M3-Grant/fpga-synth-engine/00-先看我.md

# 00 · 先看我 —— 项目总入口

> 竞赛：2026 全国大学生嵌入式芯片与系统设计竞赛 · FPGA 创新设计赛道
> 选题：选题二《基于 FPGA 的实时多音色合成电子乐器引擎》
> 平台：高云 **GW2AR-LV18QN88C8/I7**（Sipeed Tang Nano 20K，27 MHz，无 PLL 倍频）
> 版本：**v2.0.1**（2026-11-04）

**一句话现状：12 键可演奏 C4~B4 一个完整八度，4 声部复音，6 档音色。**
**钢琴走 6 谐波加法合成（非谐倍率 + 每谐波独立衰减），吉他走 Karplus-Strong 物理建模 ——
两条完全不同的合成路线。双红外分别当延音踏板和弱音踏板，上位机 120 fps 实时可视化。**

| 关键指标 | 值 |
|---|---|
| 采样率 | 52734.375 Hz（27 MHz ÷ 8 ÷ 64） |
| 内部演奏延迟 | **5.006 ms**（37 ns 量化，n=12 实测） |
| 遥测 | 576 B/帧 @ 921600 8N1，**103 fps** |
| 渲染 | **120 fps**（跟随屏幕刷新率） |
| 资源 | LUT **9281**/20736（45%）、Register 3695/15750（24%）、DSP 3/24、BSRAM 0 |

---

## 一、这个包能做什么

| 能力 | 实现程度 |
|---|---|
| 复音 ≥ 4 | ✅ `VOICE_NUM = 4`，参数化可扩 |
| **钢琴音色** | ✅ 6 谐波加法合成，倍率 `n·√(1+B·n²)`（B=3e-4，非谐），权重 1/h，每谐波独立衰减（τ 2.5 s → 0.08 s） |
| **吉他音色** | ✅ Karplus-Strong 单弦，`y-(y>>5)` 快衰减；踩延音踏板切 `y-(y>>7)` |
| 数字波形 | ✅ 三角 / 方波 / 锯齿 / 脉冲（`oscillator_array` + `adsr`） |
| 延音踏板 | ✅ IR#1（引脚 85）：踩着松手走 `env-(env>>4)-1` 指数渐弱（≈0.93 s），抬脚回收声部 |
| 弱音踏板 | ✅ IR#2（引脚 73）：遮挡 = 整体 -12 dB（混音末级 `>>> 2`） |
| 手感开关 | ✅ `A5 02` 松键渐弱(48 ms) / 立即静音；`A5 03` 延音踏板总开关 |
| 延迟测量 | ✅ 片内 37 ns 量化，min/max/avg/抖动 |
| 实时可视化 | ✅ 波形 / FFT 频谱 / 李萨如 / 12 音统计 / 延迟面板 |
| 纯硬件合成 | ✅ 全部 Verilog，无软核、不预存 PCM |

---

## 二、硬件与接线

### 2.1 触摸输入（TTP229 钢琴模块）

| 信号 | 引脚 | 说明 |
|---|---|---|
| `ttp_scl` | 75 | FPGA → TTP229 SCL |
| `ttp_sdo` | 76 | TTP229 → FPGA（片内上拉） |

> ⚠️ TTP229 的 VCC **必须接 3.3 V**。接 5 V 会让 SDO 输出 5 V，打坏 FPGA 的 3.3 V IO。
> ⚠️ 商家标的"I2C"是误标，实际是 2 线串行（主机给时钟、模块出数据位）。

另一个顶层 `synth_board12_top` 支持旧的 12 × TTP223 并行方案（引脚 27/28/29/30/31/26/41/42/48/77/79/25）。

### 2.2 双红外

| 信号 | 引脚 | 作用 |
|---|---|---|
| `ir_in` | **85** | IR#1 · 延音踏板（遮挡 = 踩下） |
| `ir2_in` | **73** | IR#2 · 弱音踏板（遮挡 = -12 dB） |

模块 VCC 接 3.3 V、GND 共地，OUT 低有效。
红外朝桌面被常遮挡时会一直报"有手"，等于踏板被永久踩住 —— 用 `A5 03 0` 可整体停用延音踏板。

> 引脚 **74** 是旧版红外口，实际接线是 85/73，别再改回去。

### 2.3 音频输出

| 信号 | 引脚 | 说明 |
|---|---|---|
| `i2s_bck` | 56 | → PCM5102A BCK |
| `i2s_lrck` | 55 | → LRCK / WS |
| `i2s_din` | 54 | → DIN |
| `pa_en` | 51 | 板载 MAX98357A 使能（外接功放可不用） |

**推荐链路**：`FPGA I2S → PCM5102A → PAM8403（3 W，独立 5 V）→ 4 Ω 喇叭 + 密封腔体`。
完整接线见 `docs/18-新硬件接线指南.md`。

### 2.4 其他引脚

| 用途 | 引脚 |
|---|---|
| 时钟 | 4（板载 27 MHz） |
| UART TX | 48（另有 69/42/77/79 并联备用） |
| UART RX | 27 |
| 板载 LED | 15~20（低电平点亮） |
| 避开 | 33~40（HDMI/LCD）、87/88（用户键/**复位**） |

---

## 三、代码结构

### 3.1 合成链路

| 模块 | 作用 |
|---|---|
| `synth_ttp229_top.v` | **整机顶层**（TTP229 + 双红外 + 遥测 + 延迟） |
| `ttp229_scan.v` | TTP229 2 线串行读出（500 kHz，20 ms 一轮） |
| `key_scan.v` | 12 路按键消抖（5 ms）+ 边沿检测 → 音符事件 |
| `note_alloc.v` | 音符事件 → 4 声部分配 / 抢占 / `all_off` 回收 |
| `note_table.v` | 音名 → 频率控制字（`tools/gen_fcw.py` 生成，勿手改） |
| `synth_top.v` | **两条音色通路的汇合点** + 弱音移位 |
| `piano_engine.v` | **钢琴**：4 声部 × 6 谐波加法合成，非谐倍率，串行乘加 |
| `ks_array.v` / `karplus_strong.v` | **吉他**：Karplus-Strong 物理建模（支持 sustain） |
| `oscillator_array.v` / `osc_voice.v` | 数字波形通路 |
| `adsr.v` | 四段包络 + **S_PEDAL**（踏板延音的指数渐弱） |
| `mix_tree.v` | N 路求和 + 20 位饱和 |
| `i2s_tx.v` | 标准 Philips I2S 发送机 |
| `latency_meter.v` / `lat_stat.v` | 37 ns 量化的延迟测量与统计 |
| `uart_stream.v` | 576 字节帧的双缓冲发送器 |
| `ui_cmd.v` | 下行命令解析（`A5 01/02/03`） |
| `ir_gesture.v` | 红外消抖 + 挥手判定（诊断用，音色已改由 UI 控制） |

### 3.2 顶层与自检固件

| 模块 | 用途 |
|---|---|
| `synth_ttp229_quiet_top.v` | 静音台架版（触摸/延迟/串口全活，DAC 输出置零） |
| `synth_board12_top.v` | 12 × TTP223 版整机 |
| `tone_test_top.v` | 440 Hz 单音「生死线」工程 |
| `chord_demo_top.v` | 零接线自动和弦演示 |
| `self_test_12notes.v` | 零接线循环钢琴十二音 |
| `self_test_square.v` | 零接线循环方波十二音（硬件对照） |
| `self_test_ks.v` | 零接线 KS 拨弦自检 |
| `ttp229_debug.v` | 触摸 → LED 显示位号（测位映射） |

---

## 四、测试体系（15 套回归）

```powershell
cd code
powershell -ExecutionPolicy Bypass -File .\run_sim_all.ps1
# 期望最后一行：ALL SIMULATIONS PASSED   (15 suites)
```

| # | 套件 | 覆盖 |
|---|---|---|
| 1 | `i2s_tx` | BCK 周期 / 每 LRCK 的 BCK 数 / 采样率 |
| 2 | `note_alloc` | 声部分配、抢占、释放 |
| 3 | `adsr` | 四段包络单调性、峰值、RELEASE |
| 4 | **`adsr_pedal`** | **踏板延音：松手走 S_PEDAL 慢衰减（≈932 ms），不踩踏板仍 48 ms** |
| 5 | `synth_top` | 数字波形通路：静音/单音/复音/释放 |
| 6 | `tone_test` | 440 Hz 实际输出频率 |
| 7 | `synth_board` | 2 键版集成 |
| 8 | `led_ctrl_top` | LED 模式切换 |
| 9 | `key_scan` | 消抖 + 事件 |
| 10 | `ir_gesture` | 挥手窗口判定 |
| 11 | `synth_board12` | 12 键版整机 |
| 12 | `key12_notes` | 12 个键 → 12 个音名 |
| 13 | `piano_engine` | 钢琴引擎：谐波、衰减、damper、和弦 |
| 14 | `ttp229` | TTP229 串行读出（位序、单键、全按、松键） |
| 15 | `synth_ttp229` | 整机链路（串行 → 按键 → 合成 → I2S） |

> ⚠️ **必须用 `.ps1`，不要用 `.bat`。** `.bat` 只看退出码，测试台打印 `[FAIL]` 时退出码仍是 0，会假报 PASS
> （2026-10-15 就因此漏掉过 2 个隐藏 FAIL）。`.ps1` 扫描输出里的 `[FAIL]` 才是真判据。

**单模块快速验证**（比跑全套快一个数量级）：

```powershell
$iv="C:\iverilog\bin"
& "$iv\iverilog.exe" -o "$env:TEMP\t.vvp" "code\rtl\adsr.v" "code\sim\tb_adsr_pedal.v"
& "$iv\vvp.exe" "$env:TEMP\t.vvp"
```

---

## 五、v2.0.1 验证结果

| 项 | 结果 |
|---|---|
| 综合 / 布线 | 0 Error，时序收敛 |
| 资源（`synth_ttp229`） | LUT **9281**/20736（45%）、Register 3695/15750（24%）、DSP 3/24 |
| 串口 | 103.0 fps、0 异常帧 |
| 延迟 | avg **5.006 ms**（min 4.996 / max 5.014 / 抖动 0.018 ms，n=12） |
| 钢琴非谐性（FFT） | 泛音比 1.0025 / 1.0051 / 1.0038 / 1.0051 / 1.0076（n=2..6），等效 B≈7e-4 |
| 踏板延音（数字波形） | 932 ms 归零；不踩踏板仍 48.5 ms |
| 吉他衰减（C4） | 不踩踏板 668 ms 归零；踩踏板 1087 ms 仍有 332 |

---

## 六、踩过的坑（新对话务必知道）

1. **采样率是 52734.375 Hz，不是 48000**。`fs = 27 MHz ÷ 8 ÷ 64`。按 48 k 算，A4 会跑成 483 Hz。
2. **I2S 必须标准 Philips 时序**（LRCK 边沿后延迟 1 个 BCK 发 MSB）。左对齐会让样本左移一位 = 音量翻倍 + 削波。
3. **`tri` 是 Verilog 保留字**（三态线网类型），信号不能叫 `tri`。
4. **iverilog 通过 ≠ 综合通过**。Gowin 的 `EX3791`（位宽截断）/ `EX3784`（索引越界）能抓出仿真不报的 bug。
5. **`.v` 文件不能带 UTF-8 BOM**，否则 iverilog 报 `No top level modules`（Gowin 反而不报，很隐蔽）；
   **`.ps1` / `.bat` 必须纯 ASCII**，PowerShell 5.1 / cmd 按系统 ANSI 代码页读取，中文注释会破坏语法。
6. **KS 的延迟线必须同步读**。写成 `wire x = delay[rd]` 时 Gowin 用不了 BSRAM，整块退化成触发器，DFF 从 3.7k 冲到 18k。
7. **有符号数与无符号数的移位是两回事**。`lp - (lp >> 8)` 对补码负数是"绝对值变大"，波形会一路放大到削波；
   必须 `$signed(lp) - ($signed(lp) >>> 8)`。
8. **多声部叠加要算幅度预算**。单声部激励 1/2（±16383）× 4 声部 = 65532，超 16 位满幅后整段削成方波
   （频谱铺满全频段，听着既不像钢琴也不像吉他）。现在钢琴 1/4、吉他 1/8。
9. **KS 引擎要知道"延音踏板"**。`sustain` 只喂给 note_valid 门控是不够的 —— 衰减档也得切，否则踩了踏板还是 0.67 s 就没声。

---

## 七、文档速查

| 想干什么 | 看哪篇 |
|---|---|
| 仓库总览 / 快速开始 | `README.md` |
| **新硬件怎么接** | `docs/18-新硬件接线指南.md` |
| 上板接线、喇叭怎么焊 | `docs/07-接线指南.md` |
| 触摸 / 红外 / 轻触开关方案 | `docs/08-交互硬件接线.md` |
| 模块接口规格 | `docs/05-模块规格与接口定义.md` |
| 钢琴音色怎么做的 | `docs/16-钢琴音色迭代.md` |
| 红外手势怎么做的 | `docs/17-红外手势最小系统.md` |
| I2S 到底哪里错了 | `code/I2S调试记录.md` |
| Gowin 烧录流程 | `docs/10-Gowin烧录指南.md` |
| 历代评审与发布说明 | `docs/09` / `docs/12` / `docs/13` / `docs/15` |

> ⚠️ `host_viz/` 是 **v1 时代的 Python 上位机**（`synth_viz.py` + LabVIEW 对接文档），
> 已被 `host_ui/`（Electron + 浏览器版）取代，仅作历史参考保留。
> `iterations/` 里是 `demo0.0.2` 的代码快照，同理。

---

## 八、待办（按优先级）

1. **喇叭换 4 Ω 全频 + 密封腔体** —— 对音色的改善大于任何电子改动（板载 SPK+/SPK− 是 BTL，两端都不能接地）
2. **第二路红外的表情通道**：目前 IR#2 用来做弱音；若要做"手距 → 力度/弯音"，需要连续量测距而不是开关量
3. **钢琴音色的力度分层**：现在没有 velocity，所有按键同一个音头
4. **李萨如可视化**：衰减信号的轨迹会卷成螺旋，闭不上；后期考虑用"谱峰重建"生成理想轨迹
5. 和弦削波取舍：单音约 55% 满幅，两音以上会饱和；接 3 W 功放后若嫌糊可加软限幅
