M3-Grant/fpga-synth-engine/docs/12-进度记录-2026-10-14.md

# 进度记录 · 2026-10-14

> 状态：**全链路打通，板子已出声** ✅
> 下次继续：先跑回归仿真 → 烧 2 键版 → 接 12 键触摸

---

## 一、今日里程碑

### 1. 硬件链路全部打通，喇叭出声 ✅

| 环节 | 结果 |
|---|---|
| USB 枚举 | `VID_0403&PID_6010` = **FTDI FT2232H**，`ProblemCode 0` |
| 串口 | **COM9 / COM10**（属 FTDI 双通道，**烧录不用它们**） |
| 驱动 | **完全免驱** —— Windows 11 自带 FTDI 驱动（`Service = FTDIBUS`） |
| JTAG | `GW2AR-18C`，ID `0x0000081B`，Family `GW2AR` |
| 烧录 | SRAM Program 100%，4.6 秒 |
| 上板现象 | **LED 闪 + 喇叭持续出声**（用户确认） |

**⚠️ 之前"资源管理器不认"的真凶就是 USB 数据线：**

```
旧线：USB\VID_0000&PID_0002   ProblemCode 43
      "A request for the USB device descriptor failed"   ← 连描述符都拿不到
新线：USB\VID_0403&PID_6010   ProblemCode 0             ← 正常
```

> **那根能用的线务必留好、贴标签。** 以后调试出问题，第一个怀疑对象永远是线。

板子橙色 WS2812 流水灯 = BL616 固件在跑，**和 FPGA 无关**，它可以作为"供电正常"的指示。

---

### 2. 命令行构建流程打通（不用开 IDE）✅

新增 `code/synth/build.ps1` + `code/synth/README.md`：

```powershell
cd D:\harness\fpga-synth-engine\code\synth
.\build.ps1 -Target tone_test                # 只构建
.\build.ps1 -Target synth_board -Program sram # 构建 + 烧 SRAM
```

| Target | 顶层 | 说明 |
|---|---|---|
| `tone_test` | `tone_test_top` | 440 Hz 自检，**一直响**，只在验证工具链时用 |
| `synth_board` | `synth_board_top` | 2 键版（板载按键 87/88），**零接线** |
| `synth_board12` | `synth_board12_top` | 12 键版（TTP223），正式演奏用 |

### 🔑 关键坑：引脚 54/55/56 是 SSPI 专用引脚

不设这一项，布局布线直接失败：

```
ERROR (PR2017) : 'i2s_din' cannot be placed ...
                 for the location is a dedicated pin (SSPI)
```

**解法**：Tcl 里加 `set_option -use_sspi_as_gpio 1`
（对应 IDE 里 `Place & Route → Dual-Purpose Pin → Use SSPI as regular IO`）

引脚分配本身**没错** —— 与官方 `vendor-docs/audio/src/audio.cst` 逐条一致。

---

### 3. Gowin 综合新暴露并修掉的 4 个真实 bug ✅

Gowin 综合器的告警比 iverilog 严格，一上板就抓出 4 个问题：

| # | 文件 | 问题 | 修复 |
|---|---|---|---|
| 1 | `constraints/synth_board12.cst` | `SINGLE_RESISTOR=ON` 非法（仅 bank 2/3/6/7 支持）→ **阻塞 P&R** | 去掉该属性，保留 `PULL_MODE=DOWN` |
| 2 | `constraints/synth_board.cst` | 同上 | 同上 |
| 3 | `rtl/osc_voice.v:78` | `modulated >>> 8` 触发 `EX3791`（33→16 位截断） | 改 `modulated[23:8]`，**语义完全等价**，附值域校核注释 |
| 4 | `rtl/synth_board_top.v:194` | LED 拼接 7 位截成 6 位，**心跳位被挤掉** | `2'b00` → `1'b0` |

> **#4 是实打实的功能 bug**：会导致 `led[0]` 心跳灯不闪、`led[1:2]` 错位。
> 而 `tone_test_top` 没这问题，所以昨天没暴露。

**教训：iverilog 通过 ≠ 综合通过。上板前必须跑一次 Gowin 综合看告警。**
目前 3 个 target 综合**全部零 ERROR、零 EX3791 告警**（只剩两个无害的时钟类 WARN）。

### 4. 音量调整

| 参数 | 原值 | 现值 | 效果 |
|---|---|---|---|
| `AMP`（`tone_test_top` / `synth_top`） | `16'sh2000`（1/4 满量程） | `16'sh0800`（1/16） | **降 12 dB** |

原因：方波谐波极其丰富，1/4 满量程在 8Ω 小喇叭上实测**非常刺耳**。

---

## 二、当前状态

### 已生成的比特流

| Target | 路径 | 状态 |
|---|---|---|
| `tone_test` | `build/tone_test/impl/pnr/tone_test.fs` | 已上板验证 ✅（但**未含降音量改动**，是旧的 1/4 幅度） |
| `synth_board` | `build/synth_board/impl/pnr/synth_board.fs` | 已修 LED bug + 降音量，**未上板** |
| `synth_board12` | `build/synth_board12/impl/pnr/synth_board12.fs` | 已修，**未上板** |

### 板子现状

- **已拔线，FPGA 里没有程序**（SRAM 掉电即失，正常）
- 喇叭焊接情况待确认

### ⚠️ 未完成的事

1. **回归仿真没跑完** —— `osc_voice.v` 和 `synth_board_top.v` 改动后，只跑了一部分 iverilog 验证就被打断
2. 2 键版 / 12 键版**都还没上板**
3. `synth_board_top` 的 `ACTIVE_LOW=0`（假设板载按键**按下为高**）**未在实物验证**

---

## 三、明天从这里继续

### 第 1 步：跑回归仿真（确认今天的 RTL 改动没破坏功能）

```powershell
cd D:\harness\fpga-synth-engine\code
.\run_sim_all.bat          # 期望输出 ALL SIMULATIONS PASSED
```

### 第 2 步：烧 2 键版（零接线，验证复音 + ADSR + 音量）

```powershell
cd D:\harness\fpga-synth-engine\code\synth
.\build.ps1 -Target synth_board -Program sram
```

**预期现象**

| 现象 | 含义 |
|---|---|
| `led[0]` 约 1.6 Hz 闪 | 逻辑在跑 |
| 按 **KEY1** 出声 / 再按停声 | 音符开关 |
| 按 **KEY2** 切到下一个音（C-D-E-F-G-A-B-C） | 音阶步进 |
| `led[5:3]` 显示当前音阶位置 | 二进制计数 |

**如果按键行为反了**（松开才响、按下停）：把 `synth_board_top.v` 里两处 `debounce` 的
`.ACTIVE_LOW(0)` 改成 `.ACTIVE_LOW(1)` 再重建。

### 第 3 步：接 TTP223 ×12 → 烧 12 键版

接线：`VCC→3.3V`、`GND→GND`、`I/O→对应 key 引脚`，**A/B 焊盘都不焊**（默认高有效，匹配 `ACTIVE_LOW=0`）。

引脚分配见 `code/constraints/synth_board12.cst`，全部来自官方例程 `.cst`，已核实。

```powershell
.\build.ps1 -Target synth_board12 -Program sram
```

### 第 4 步：尚未开始的功能

- **第二交互维度**（红外对管做手势/力度）—— 比赛要求 ≥2 维交互，现在只做了第 1 维（按键）
- **钢琴音色**（加法合成 wavetable）—— 只做过可行性分析，未动手

---

## 四、环境备忘

| 项 | 值 |
|---|---|
| Gowin 云源 | `D:\Gowin\Gowin_V1.9.11.03_Education_x64` |
| 综合器 | `IDE\bin\gw_sh.exe`（Tcl） |
| 烧录器 | `Programmer\bin\programmer_cli.exe` |
| `GOWINHOME` | 命令行工具**必须**设置（`build.ps1` 自动设） |
| iverilog | `C:\iverilog\bin` |
| 器件 | `GW2AR-LV18QN88C8/I7` / 短名 `GW2AR-18C` |
| 时钟 | 27 MHz（引脚 4）→ `fs = 52734.375 Hz` |

### programmer_cli 常用 operation_index

| 值 | 操作 |
|---|---|
| `2` | SRAM Program（掉电即失） |
| `4` | SRAM Program and Verify |
| `9` | exFlash Erase,Program,Verify（掉电保持） |
| `11` | exFlash Verify |

---

## 五、一句话总结

> **昨天：仿真全过、代码就绪。今天：工具链、USB、JTAG、综合、烧录全部打通，板子真的响了。**
> 明天从「跑回归仿真 → 烧 2 键版」开始，然后接 12 个触摸键。
