M3-Grant/fpga-synth-engine/docs/09-第一代demo评审报告.md

# 第一代 demo 测试与评审报告

> 测试时间：2026-10-08
> 被测版本：`demo0.0.1`（提交 `46b5d9e`）
> 测试环境：Icarus Verilog 12.2022（`C:\iverilog\bin`）

---

## 一、仿真测试结果：21 项全通过 ✅

### 1. `i2s_tx` —— 6/6 通过

```
[检查1] BCK 周期            期望 296.3 ns    实测 296.0 ns      PASS
[检查2] 每 LRCK 周期 BCK 数 期望 64          实测 64            PASS
[检查3] 实际采样率          期望 52734.4 Hz  实测 52734.3 Hz    PASS
[检查4] 串行数据流 6 组向量                                    PASS 6/6
        T1 L=1234 R=ABCD  → 流 1234abcd
        T2 L=FFFF R=0000  → 流 ffff0000
        T3 L=8001 R=7FFE  → 流 80017ffe
        T4 L=A55A R=5AA5  → 流 a55a5aa5
        T5 L=0001 R=8000  → 流 00018000
        T6 L=+max R=-max  → 流 7fff8000
```

**评价**：这套测试向量设计得很扎实，特别是 **T5（边界值 0001/8000）和 T6（正负满量程）**——这两个是新手最容易漏的，能覆盖说明测过脑子。

### 2. `tone_test_top` —— 2/2 通过

```
实际采样率      = 52734.375 Hz
音频样本数      = 2216
相位 MSB 翻转数 = 36
测得方波频率    = 439.86 Hz（期望 440.00，误差 0.032%）  PASS
I2S 持续输出    = 2216 个样本                              PASS
```

**评价**：**测实际输出频率**而不是只测"有没有信号"，这是很专业的做法。439.86 Hz 的偏差来自仿真窗口取整，不是设计问题。

### 3. `led_ctrl_top` —— 10/10 通过

模式切换、回绕、5 种模式输出全部正确。

### 4. 独立复算音高表

我用 Python 独立复算了 `note_table.v` 的 FCW 值：

| 音符 | 频率 | 代码值 | 复算值 | 实际音高误差 |
|---|---|---|---|---|
| C4 | 261.63 | 21308174 | 21308535 | −0.002% |
| D4 | 293.66 | 23917617 | 23917228 | +0.002% |
| E4 | 329.63 | 26846617 | 26846816 | −0.001% |
| F4 | 349.23 | 28443000 | 28443144 | −0.001% |
| G4 | 391.99 | 31926188 | 31925745 | +0.001% |
| A4 | 440.00 | 35835935 | 35835935 | **0.000%** |
| B4 | 493.88 | 40224476 | 40224208 | +0.001% |
| C5 | 523.25 | 42616348 | 42616256 | 0.000% |

**结论：音高全部正确**，最大误差 0.002%，远低于人耳可辨阈值（约 0.3%）。
（代码值与理论值有几十个 LSB 的差异，但不影响音准，属于可接受的取整方式。）

---

## 二、做得好的地方（值得保持）

| # | 亮点 | 为什么重要 |
|---|---|---|
| 1 | **`i2s_tx` 重写为标准 Philips I2S** | v1 左对齐会让 PCM5102A 左右声道错位、声音发闷。这个修正很关键 |
| 2 | **每声道 32 BCK（非 16）** | v1 只有 16 BCK/声道，采样率被顶到 105kHz。修正后是合理的 52.7kHz |
| 3 | **样本锁存（`l_reg`/`r_reg`）** | 帧起点打一拍，保证发送途中数据不被上游改写。**这是很多人会漏的坑** |
| 4 | **`sample_req` 提前 16 BCK 请求** | 给上游留出计算时间，避免欠载。设计意识很好 |
| 5 | **上电复位（POR）** | `tone_test_top` 用计数器自复位，不依赖按键，减少一类入门坑 |
| 6 | **测试向量覆盖边界值和满量程** | T5/T6 体现了测试思维 |
| 7 | **显式声明 `sample_req` 再使用** | 规避了 iverilog v14 的 "declaration after use" 检查 |
| 8 | **文档记录了踩坑** | `I2S调试记录.md` 对答辩极有价值 |

---

## 三、发现的问题

### 🔴 问题 1：两处"插 J4"的残留说法（**上板前必须修正**）

**先说明：你们的结论是对的。** `00-先看我.md` 和 `07-接线指南.md` 第 18~22 行都正确指出：
> 原理图里标 J4（Conn_01x02），但**实物上没有焊座子**，只有两个标着 **SPK** 的裸露焊盘，必须自己焊线。BTL 输出，不能接地。

**但有两处早期写法没同步更新，仍然说"插 J4"：**

| 位置 | 原文 | 问题 |
|---|---|---|
| `code/rtl/tone_test_top.v` 第 12、14 行 | "输出经 J4（2pin 座子）接 4~8Ω 喇叭"<br>"生死线可以**完全不接线**，只要把 pa_en 拉高、喇叭插 J4 就能响" | 说"不接线""插座子"，与实物矛盾 |
| `docs/07-接线指南.md` 第 30 行 | "生死线那天可以**一根线都不接**……喇叭插到板上 J4 座子" | 与同文件第 20~21 行的更正自相矛盾 |
| `docs/07-接线指南.md` 第 38~39 行 | 方案 A："接线量 **0 根**"、"喇叭插 J4" | 表格里还在说插 J4 |

**风险**：
- 队员只看这几行，会以为"不用焊接、插上就行" → 找不到座子、以为板子有问题，**白折腾几小时**
- 更糟的情况：误以为某些排针是喇叭口，接错位置 → **可能烧功放芯片**

**注意**：`07-接线指南.md` 后面的第 55、70~87、202~203 行其实写得很完整（焊盘位置、焊接步骤、万用表检查），
所以**信息是全的，只是前面留了过时说法**，容易让读者在第一眼就被误导。

**建议修正**（3 处，10 分钟能改完）：

1. `tone_test_top.v` 第 10~16 行注释改为：
   ```
   //    原理图上标 J4，但实物未焊座子，输出在板上的 SPK+ / SPK- 两个裸焊盘。
   //    → 用板载功放出声需要自己焊两根线到 SPK 焊盘（BTL 输出，两端都不可接 GND）。
   //    → 若不焊接，则走外接 PCM5102A 方案（3.5mm 耳机口，零焊接）。
   ```
2. `07-接线指南.md` 第 30 行：删掉"插到板上 J4 座子"，改成"**喇叭两根线焊到 SPK 焊盘**"
3. `07-接线指南.md` 第 38~39 行表格：方案 A 的"接线量"由"0 根"改为"**2 根（需焊接）**"，"出声方式"改为"**4~8Ω 喇叭焊到 SPK 焊盘**"

**另外强烈建议**：在 `07-接线指南.md` 里补一张**实物照片**，圈出 SPK 焊盘位置。文字描述"排针 54 和 56 正下方往板内一格"不如一张照片直观。

---

### 🟠 问题 2：采样率 52734.375 Hz 不是标准音频速率

| 标准速率 | 本项目 | 偏差 |
|---|---|---|
| 44100 | 52734.375 | +19.58% |
| 48000 | 52734.375 | +9.86% |

**影响评估**：
- ✅ **音准没问题**——FCW 按真实 fs 算，A4 实测 440.00 Hz
- ✅ **MAX98357A 支持 8k~96kHz**，能接受这个速率
- ⚠️ **但与标准 48kHz 不兼容**：如果以后要把音频录到电脑分析、或与外设对接，会有问题
- ⚠️ **与 PCM5102A 的隐患**：PCM5102A 通过采样 MCLK 或 BCLK 自动检测速率。52734 Hz 落在它支持的范围内，应该能用，但**换 DAC 后必须重新验证**

**建议**：
- 如果只是"出声"和演示，**保持现状完全没问题**
- 若想更规范，可改 `BCK_HALF`：`5` → 42187.5 Hz，`3` → 70312.5 Hz（但仍非标准）
- **真正的标准 48kHz 需要 24.576MHz 时钟**（27MHz 除不出整数），这就是为什么会有这个偏差——不是设计失误，是时钟源的物理限制

---

### 🟡 问题 3：MAX98357A 是单声道，注意演示策略

代码注释里已经提到了，这里再强调：

- MAX98357A 是**单声道** D 类功放
- `SD_MODE > 1.4V` 时只输出**左声道**
- 当前 `tone_test_top` 左右声道同数据，所以听不出问题
- **但等你们做复音、立体声效果时，右声道会丢失**

**建议**：
- 频谱验证和最终演示**按计划外接 PCM5102A**（立体声）——你们文档里已经想到了，很好
- 板载 MAX98357A 只当"快速验证出声"用

---

### 🟡 问题 4：缺少幅值调节机制

当前 `AMP = 16'sh2000`（1/4 满量程）是固定参数，需要改代码重新综合才能调音量。

**建议**：后续加一个按键或电位器控制幅值，现场演示时可调，避免音量过大刺耳。

---

## 四、改进建议（按优先级）

### P0（上板前必须做）

| # | 事项 |
|---|---|
| 1 | **确认并统一喇叭接法**（J4 vs SPK 焊盘），修正文档矛盾 |
| 2 | **补一张实物接线照片**放进 `docs/07-接线指南.md` |
| 3 | 焊接前用万用表确认 SPK+ / SPK− 无短路、未接地 |

### P1（上板后尽快做）

| # | 事项 | 说明 |
|---|---|---|
| 4 | 记录**真实上板实测数据** | 波形/频率截图，答辩要用 |
| 5 | 用示波器或逻辑分析仪确认 BCK/LRCK/DIN 实际波形 | 对照仿真验证硬件一致 |
| 6 | 外接 PCM5102A 做立体声验证 | 为后续复音做准备 |

### P2（进入第二代开发时）

| # | 事项 | 说明 |
|---|---|---|
| 7 | 提高时间分辨率 | 当前仿真窗口下 440Hz 测得 439.86Hz，可用更长窗口验证 |
| 8 | 加入 ADSR 包络 | 让声音不再"硬切" |
| 9 | 相位累加器位宽保持 32 位 | 当前设计正确，扩复音时别降位宽 |
| 10 | 开始参数化复音数 | `parameter VOICE_NUM` + `generate`，为 4→32 复音做准备 |

---

## 五、总体评价

**这是一份质量很高的第一代 demo。** 具体来说：

| 维度 | 评分 | 说明 |
|---|---|---|
| 功能正确性 | ★★★★★ | 21 项测试全通过，含边界值 |
| 测试设计 | ★★★★★ | 测实际频率而非"有无信号"，覆盖边界 |
| 代码规范 | ★★★★☆ | 注释详尽、模块解耦、命名清晰 |
| 文档完整度 | ★★★★☆ | 8 篇文档 + 调试记录，但存在 1 处矛盾 |
| 工程意识 | ★★★★★ | 样本锁存、提前请求、上电复位都考虑到了 |
| **上板风险** | ⚠️ | **喇叭接法未确认，有烧板风险** |

**最强的一点**：你们踩过的坑都留下了记录（`I2S调试记录.md`），这在答辩时是**实打实的加分项**——证明你们理解原理，而不是抄代码。

**最需要立刻做的**：把喇叭接法搞清楚。这是唯一有"物理损坏风险"的问题，其余都是优化项。

---

## 六、上板检查清单

上板前逐项确认：

```
□ 喇叭接法已确认（J4 还是 SPK 焊盘）
□ 焊接处万用表测过，无短路、未接地
□ 板卡供电正常（Type-C 数据线，非充电线）
□ Gowin 工程器件选对：GW2AR-LV18QN88C8/I7
□ 约束文件 tone_test.cst 已导入
□ 改过代码后重新综合+布线+生成码流（不能下旧码流）
□ 上电后先看 led[0] 是否闪烁（证明逻辑在跑）
□ 听到 440Hz 单音 → 生死线通过
```

**注意**：`led[0]` 闪烁是"逻辑在跑"的证据。如果灯不闪，说明板子没配置成功，别急着怀疑音频。
