M3-Grant/fpga-synth-engine/docs/06-追赶排期（10-08起）.md

# 06 · 追赶排期（2026-10-08 起）

> **为什么要有这份文件**：原排期从 09-22 开始，但环境这一步实际上到 10-08 才就位，
> 已经落后约 2.5 周。原计划作废，下面是按"距省赛提交还剩 27 天"重新倒推的版本。
> 赛题：高云 · 选题二《基于 FPGA 的实时多音色合成电子乐器引擎》
> **省赛提交：2026-11-04 18:00（剩 27 天）｜ 决赛：2026-11-20 ~ 11-22**

---

## 一、先解决三个"不知道就白干"的问题（今天，1 小时内）

| # | 必须确认 | 为什么 | 怎么确认 |
|---|---|---|---|
| 1 | ~~板卡型号到底是哪个~~ | ✅ **已确认为 Tang Nano 20K**，文档与引脚约束全部适用 | — |
| 2 | **DAC 模块型号与接线方式** | 是否要 MCLK、逻辑电平是 3.3V 还是 5V，直接决定能不能出声 | 看模块丝印（应为 PCM5102A），问客服"是否 3 线 I2S、不需 MCLK" |
| 3 | **省赛提交截止日期** | 文档里的 11-04 来自报名时的信息，必须在官网再核一次 | 大赛官网 http://www.fpgachina.cn/ |

> ⚠️ 如果是 **Tang Mega 60K**：主时钟、引脚、器件系列全部不一样，
> 必须先把 `code/constraints/*.cst` 和 Gowin 工程里的器件换成 GW5AT-LV60，
> 其余架构（I2S / DDS / 复音）不变。**这一步不确认，后面每一天都可能白做。**

---

## 二、已完成 / 待完成（截至 10-08）

| 项 | 状态 |
|---|---|
| 硬件采购 | ✅ 已下单 |
| Gowin 软件 | ✅ 已下载，❌ **未安装** |
| Icarus Verilog 仿真器 | ✅ **已装好**（`D:\Tools\iverilog\bin`，含 GTKWave） |
| I2S 模块 | ✅ **已重写并通过仿真**（标准 Philips I2S，9/9 项通过） |
| 440Hz 验证工程 | ✅ **已写好并通过仿真**（实测 439.86 Hz） |
| 音符 FCW 表 | ✅ 已生成（C4~C6，25 个半音） |
| 点灯 | ❌ 未做 |
| 上板出声 | ❌ 未做 ← **生死线** |

---

## 三、五周追赶计划

### W1｜10-08(四) ~ 10-11(日) — 环境 + 点灯 + **出声（生死线）**

| 日期 | 任务 | 验收标准 |
|---|---|---|
| **10-08 今天** | ① 安装 Gowin 云源软件教育版 V1.9.11.03（422MB，**勾选 GW2A/GW2AR 器件库**）② 安装云源编程器教育版（85MB）③ 确认上面三个问题 | 软件能打开，器件列表里有对应芯片 |
| **10-09 五** | 跑官方例程 `vendor-docs/led/blink_led`：新建工程 → 加 `.v` → 加 `.cst` → Synthesize → Place & Route → Program Device | **板上 LED 闪烁** |
| **10-10 六** | ① 不照抄，独立重做一遍 `flow_led` ② **外接 PCM5102A 出声**（5 根线：54/55/56 + 3V3 + GND，杜邦线即可，零焊接） | 走完流程不卡壳；**耳机响** |
| **10-11 日** | 录一段出声视频存档；把 I2S 排查经验补进文档 | 🔴 **耳机里听到持续的 440Hz 单音** |

> 💡 **板载已有一片 MAX98357A（I2S DAC + D 类功放）**，接在引脚 54/55/56，使能脚 51，
> 输出在标着 **SPK** 的两个焊盘上（**没焊座子，要自己焊线**）。
> 它是单声道、D 类 PWM 底噪大，**不能用于频谱验证**。
> 所以**推荐直接走外接 PCM5102A**（杜邦线插上就行，不用动烙铁）。排针丝印顺序见 `07-接线指南.md`。

> **工程路径绝对不能有中文、空格**（例如 `D:\fpga\code`）。这是 Gowin 最常见的创建失败原因。
>
> **不出声的排查顺序**（按顺序来，别跳）：
> 1. 板卡供电灯亮不亮 → 换 Type-C 数据线（**必须是数据线，不能是纯充电线**）
> 2. 设备管理器认不认得到串口 → 装 BL616 驱动
> 3. Programmer 里 Port 换 0 → 1 试一下
> 4. 用手机耳机插入 DAC，音量先调到最小再慢慢加大
> 5. 万用表量 BCK 对地应有约 1.7V 平均电压（说明有时钟输出）
> 6. 逻辑分析仪/示波器看 BCK=3.375MHz、LRCK=52.7kHz 是否对得上
> 7. **若 10-14 仍无声音 → 立刻降级**：改用 PWM 直推蜂鸣器验证逻辑链，
>    同时在高云群里问 I2S，不要一个人死磕

---

### W2｜10-12(一) ~ 10-18(日) — DDS 正弦波 + 音符

| 日期 | 任务 | 验收标准 |
|---|---|---|
| 10-12 | 用 Python 生成正弦波形表（1024 点 × 16bit），存成 `.mi` 或 `.hex` | 文件生成、数值可读 |
| 10-13 | 在 Gowin 里用 IP Core 例化 ROM，或 `$readmemh` 加载 | 综合通过，BSRAM 占用 1~2 块 |
| 10-14 | 相位累加器高 10 位 → ROM 地址 → 样本 → I2S | 仿真输出正弦序列 |
| 10-15 | 上板：改 `tone_test_top` 用正弦替代方波 | 手机频谱 App 看到 **440Hz 单峰** |
| 10-16 | 接入 `note_table.v`（已生成），用板载按键切换音符 | 按键能改变音高 |
| 10-17 | 试 220 / 440 / 880Hz，核对频谱 | 频率误差 < 1% |
| 10-18 | 复盘封板：把 I2S + DDS 封装成干净的可复用模块 | 接口清晰，带注释 |

**本周末产出**：能弹不同音高的正弦波电子琴（单音）。

---

### W3｜10-19(一) ~ 10-25(日) — 2 维交互 + ADSR

| 日期 | 任务 | 验收标准 |
|---|---|---|
| 10-19 | **交互维度 1**：自制电容触摸（IO 充电 → 转输入 → 计数器测放电时间） | 手指触摸能稳定触发，不误触 |
| 10-20 | 触摸做成 4~8 个键位 | 不同键位出不同音 |
| 10-21 | **交互维度 2**：光电对管 / 红外接近 / 第二组触摸 | 第二个维度独立可控 |
| 10-22 | 两维度组合（一个选音、一个控音量或音色） | 互不干扰 |
| 10-23 | ADSR 状态机（IDLE → A → D → S → R） | 状态转换图清晰 |
| 10-24 | 实现四段包络，用**移位加法**近似，不占 DSP | 听得到渐强/衰减/释放，不再硬切 |
| 10-25 | 录一段旋律视频存档 | 视频可播放 |

**本周末产出**：带包络、双维度控制的简易电子琴。

---

### W4｜10-26(一) ~ 11-01(日) — 复音 4 + 架构定型

| 日期 | 任务 | 验收标准 |
|---|---|---|
| 10-26 | 🔴 振荡器改成 `parameter VOICE_NUM` + `generate`；波形 ROM 改**全阵列共享** | 改一个数字就能改复音数 |
| 10-27 | 音符分配器：note-on 找空闲声部，note-off 释放 | 仿真验证 |
| 10-28 | 混音加法树（流水线 + 饱和处理） | 多音同响不失真 |
| 10-29 | 复音 4 上板调试 | 🔴 **同时按 4 键，频谱出现 4 个独立谱峰** |
| 10-30 | **测试模式**：一键输出 N 路不同频率（合规自证用） | 频谱峰数 = 复音数 |
| 10-31 | 加第 2 种音色；有余力扩到复音 8 | 能切换音色 |
| 11-01 | 看综合报告，确认无时序违例；记录资源占用 | 无 setup/hold 违例 |

> ⚠️ **11-01 是决策点**：复音 4 还不稳，就把省赛交付冻结在 W3 水平（单音+包络），
> 复音留到国赛。**宁可功能少，也要稳**。

---

### W5｜11-02(一) ~ 11-04(三) — 文档 + 视频 + 提交

| 日期 | 任务 | 验收标准 |
|---|---|---|
| 11-02 | 综合实现报告（LUT/FF/BSRAM/DSP、时钟、时序）+ 设计报告 | 文档完整 |
| 11-02 | 演示视频（≤3 分钟，**必须含测试模式的频谱演示**） | 视频可播放 |
| 11-03 | 材料打包：源码 + 约束 + 脚本 + 报告 + 视频，**文件名全英文小写** | 无中文文件名 |
| 11-03 | 连续运行 10 分钟不出错、不失真 | 无死机 |
| **11-04** | 🔴 **提交（18:00 前）** | 上传成功，留截图 |

---

## 四、已经替你解决的技术坑（别再踩）

| 坑 | 原状态 | 现在 |
|---|---|---|
| **I2S 时序是左对齐不是 I2S** | LRCK 一跳变就出 MSB，缺 I2S 规定的 1 位延迟 → PCM5102A 会声道错位 | ✅ 已改为标准 Philips I2S（1 延迟位 + 16 数据 + 15 补零） |
| **采样率 105 kHz** | 每声道只有 16 BCK，速率非标准，DAC 可能锁不上 | ✅ 改为 64 BCK/LRCK，**fs = 52734.375 Hz** |
| **"DIN 左移 1 位"的假 bug** | 其实是 testbench 没丢掉无效位 + 在时钟沿改样本造成竞争 | ✅ testbench 重写，**9/9 项全部通过** |
| **FCW 按 48000 算** | fs 实际是 52734，按 48000 算 A4 会变成 483Hz，跑调两个半音 | ✅ 已生成 `note_table.v`（按真实 fs）和 `tools/gen_fcw.py` |
| **iverilog 没装** | 文档写着"已安装"，实际没有 | ✅ 已装到 `D:\Tools\iverilog\bin` |

---

## 五、本周（W1）每天结束时自查

- [ ] 今天有没有让板子**真的动起来**（灯闪 / 出声）？
- [ ] 遇到看不懂的英文界面，有没有截图翻译？（见 `../06-Gowin界面中英对照速查表.md`）
- [ ] 有没有在高云官方群（213923272）里问问题？
- [ ] 代码有没有改动没记录？

---

## 六、常用命令（复制即用）

**仿真 I2S**：
```powershell
cd D:\Competition\FPGA\FPGA\FPGA\code
D:\Tools\iverilog\bin\iverilog.exe -g2005 -o sim_i2s.out rtl\i2s_tx.v sim\tb_i2s_tx.v
D:\Tools\iverilog\bin\vvp.exe sim_i2s.out
```

**仿真 440Hz 音高**：
```powershell
D:\Tools\iverilog\bin\iverilog.exe -g2005 -o sim_tone.out rtl\i2s_tx.v rtl\tone_test_top.v sim\tb_tone_test.v
D:\Tools\iverilog\bin\vvp.exe sim_tone.out
```

**重新生成音符表**（改了时钟或 BCK_HALF 就必须重跑）：
```powershell
python code\tools\gen_fcw.py 27e6 4 --out code\rtl\note_table.v
```

**看波形**：
```powershell
C:\iverilog\gtkwave\bin\gtkwave.exe tb_i2s_tx.vcd
```
