M3-Grant/fpga-synth-engine/docs/07-接线指南.md

# 07 · 接线指南（Tang Nano 20K）

> 板卡已确认：**Sipeed Tang Nano 20K（GW2AR-LV18QN88C8/I7）**
> 引脚来源：官方 audio 例程 `vendor-docs/audio/src/audio.cst` ＋ Tang Nano 20K 原理图 AUDIO 页交叉核对。

---

## 一、结论先行：板子上已经有一片 I2S DAC 了

原理图里有一片 **MAX98357A**（I2S 输入 → D 类功放），已经接在 FPGA 上：

| 信号 | FPGA 引脚 | 原理图网络名 |
|---|---|---|
| I2S_DIN | **54** | PIN54_I2S_DIN |
| I2S_LRCK | **55** | PIN55_I2S_LRCK |
| I2S_BCLK | **56** | PIN56_I2S_BCLK |
| PA_SD/EN（功放使能） | **51** | PIN51_PA_SD/EN |
| 喇叭输出 | **SPK 焊盘 ×2** | AUDIO_OUTP / AUDIO_OUTN |

> ⚠️ **更正**：原理图里这个输出叫 J4（Conn_01x02），但**实物上没有焊座子**，
> 只有两个标着 **"SPK"** 的裸露焊盘。要接喇叭得**自己焊两根线上去**。
> 位置见图：就在排针 **54 和 56 的正下方（往板内一格）**。

MAX98357A 的关键特性（数据手册确认）：
- **不需要 MCLK**，三线 I2S 就能响
- 支持 **8 kHz ~ 96 kHz**，我们的 52.734 kHz 在范围内
- 型号后缀是 **A**（不是 B）→ 支持的是 **标准 I2S**，跟我们重写的 `i2s_tx.v` 完全匹配
- 支持 16/24/32 位数据 → 我们的"16 位数据 + 32 位帧"没问题

所以 **生死线那天可以一根线都不接**：把 `pa_en`（引脚 51）拉高，喇叭插到板上 J4 座子，就能出声。

---

## 二、两条路线，按顺序走

| | 方案 A：板载功放 | 方案 B：外接 PCM5102A |
|---|---|---|
| 接线量 | **0 根** | 5 根 |
| 出声方式 | 4~8Ω 喇叭插 J4 | 耳机 / 音箱插 3.5mm |
| 声道 | **单声道**（SD_MODE 高电平时只出左声道） | 立体声 |
| 音质 | D 类 PWM，底噪大 | 干净 |
| 频谱验证 | ❌ 底噪会盖住谱峰 | ✅ 适合 |
| 用途 | **先做这个，10 分钟内判断"逻辑通不通"** | **最终演示和答辩用这个** |

> ⚠️ 方案 A 只是用来快速验证的。题目要求"频谱可观测对应数量独立谱峰"，
> D 类功放的 330 kHz PWM 底噪会污染频谱，**正式演示必须走方案 B**。

---

## 三、方案 A：板载功放出声（今天就能做）

### 步骤
1. `tone_test_top.v` 里已经把 `pa_en` 拉高了（第 6 节），不用改代码
2. 综合 → 布局布线 → 下载
3. **找一个喇叭**，两根线焊到板上的 **SPK 焊盘**（见下方定位）
4. 上电 → 应该听到持续的 440 Hz 单音

**喇叭规格（买错会烧功放，务必照着买）**：

| 参数 | 要求 |
|---|---|
| 阻抗 | **8Ω（推荐）或 4Ω，绝不能低于 4Ω** |
| 功率 | ≥1W，推荐 2W |
| 类型 | **动圈式小扬声器**，带两根引线 |
| 禁忌 | ❌ 有源音箱 ❌ 压电蜂鸣片 ❌ 无源蜂鸣器 |

淘宝搜 `8欧2瓦 小喇叭 40mm 引线`，3~8 元，**买两个**（一个备用）。
详细选型理由见 `04-硬件采购清单.md` 第 2.3 节。

### SPK 焊盘在哪
在你拍的那张照片上（能看到 SD 卡座、丝印 `V3921` 的那面）：

- 找到上排排针里的 **54** 和 **56** 两个脚
- **它们正下方（往板内一格）有两个椭圆形的裸露焊盘**
- 焊盘左下方印着 **`SPK`** 三个字母 ← 就是这里

⚠️ 这里**没有焊座子**，只有两个焊盘，得用电烙铁焊两根线上去
（实验室借个烙铁，2 分钟的事）。焊完用万用表量一下两个焊盘之间**不是短路**再上电。

### ⚠️ 喇叭接法（唯一会烧芯片的操作）
MAX98357A 输出是 **BTL 桥接**：
- 喇叭**跨接在两个 SPK 焊盘之间**（一端接一个焊盘）
- **绝对不能**把喇叭一端接焊盘、另一端接 GND
- 阻抗必须 ≥ 4Ω（8Ω 更稳妥）

### 不响的话
- 先量两个 SPK 焊盘对 GND 的直流电压，正常应在 **2.5V 左右**（BTL 静态中点）
- 确认 `pa_en` 真的拉高了（引脚 51 量到约 3.3V）
- 注意：SD_MODE > 1.4V 时只输出**左声道**。我们左右声道送的是同一份数据，所以没影响；
  但后面做立体声时记得这一点

> 💡 **如果不想焊**：直接用方案 B 的外接 PCM5102A 就行了——杜邦线一插就响，
> 零焊接。板载 SPK 只是备选。

---

## 四、方案 B：外接 PCM5102A（最终交付用）

### 4.1 排针丝印的确切顺序（已按实物照片放大确认）

Tang Nano 20K 有两排 20pin，**板子丝印直接印了 FPGA 引脚号**。
你拍照的那一面（能看到 SD 卡座、丝印 `V3921` 的那面），**上面那一排**从左到右是：

```
位置  1   2   3   4    5     6    7   8   9   10  11  12  13  14  15  16  17  18   19   20
丝印  52  53  71  72  3V3   GND   79  86  49  55  48  51  54  56  41  42  80  76  GND   5V
```

对应关系（★ = 我们要用的）：

| 丝印 | 位置 | 用途 |
|---|---|---|
| **3V3** | 第 5 个 | ★ DAC 供电 |
| **GND** | 第 6 个（紧挨 3V3） | ★ 共地 |
| **55** | 第 10 个 | ★ LRCK |
| 48 | 第 11 个 | 空 |
| **51** | 第 12 个 | ★ 板载功放使能 pa_en |
| **54** | 第 13 个 | ★ DIN |
| **56** | 第 14 个 | ★ BCK |
| GND | 第 19 个 | 备用接地 |
| 5V | 第 20 个 | ⚠️ 别接 DAC |

**好消息**：51、54、56 三个脚**紧挨在一起**（第 12、13、14 个），
3V3 和 GND 也在同一排上（第 5、6 个），**五根线全在这一排搞定**，不用跨到对面排针。

**下排**（同一面的下面那一排，丝印是倒着印的）从左到右是：

```
3V3  GND  18  19  20  17  31  30  29  25  26  28  27  16  15  77  85  75  74  73
```

### 4.2 万用表复核（30 秒，建议做）

虽然丝印已经确认，接电源线之前还是量一下最稳：

1. 板子 USB-C 上电（先别接 DAC）
2. 黑表笔接 USB 口金属外壳（已知的地）
3. 红表笔点那个标着 `3V3` 的第 5 个脚 → 应读到 **3.3V 左右**
4. 红表笔点标着 `GND` 的第 6 个脚 → 应读到 **0V**
5. ⚠️ 第 20 个脚标着 `5V`，**千万别接 DAC**（大部分 PCM5102A 模块是 3.3V 逻辑）

### 4.3 关于排针有没有焊

官方渲染图上是**光板**（只有镀金孔，没焊排针）。实物一般已焊好，
**上板前先确认**：如果只有光孔没排针，得先自己焊上排针，
或者直接把杜邦线焊到孔上——否则杜邦线插不住。

### 4.4 接线表

| PCM5102A 模块 | Tang Nano 20K | 说明 |
|---|---|---|
| **BCK**（或 BCLK） | 排针丝印 **56** | 位时钟 |
| **LRCK**（或 LCK / WS） | 排针丝印 **55** | 左右声道时钟 |
| **DIN**（或 DATA / SD） | 排针丝印 **54** | 串行数据 |
| **VIN / VCC** | 排针丝印 **3V3** | 确认模块是 3.3V 逻辑；若模块标 5V 就接 5V |
| **GND** | 排针丝印 **GND** | ⚠️ **必须共地**，不共地一定不出声 |
| SCK / MCLK | 见下方说明 | 3 线版本没有这个脚 |

一共就 **5 根线**。

### 4.5 关于 MCLK（SCK）—— 如果你的模块有这个脚

如果你的 PCM5102A 模块引出了 **SCK/MCLK** 并且需要外部提供主时钟，
**不用慌，27 MHz 刚好能精确分出标准 MCLK**：

```
fs      = 27 MHz / 512      = 52734.375 Hz
MCLK    = 256 × fs          = 13,500,000 Hz  = 27 MHz ÷ 2   ← 精确整除，零抖动
BCK     = 64 × fs           = 3.375 MHz
```

在顶层加三行就能产生：

```verilog
// 可选：给需要 MCLK 的 DAC 用（13.5 MHz = 256 × fs，精确）
output wire mclk,
reg mclk_r = 1'b0;
always @(posedge clk) mclk_r <= ~mclk_r;
assign mclk = mclk_r;
```
然后在 `.cst` 里把 `mclk` 约束到任意一个空闲 IO 即可。

**不过更省事的做法**：直接问卖家"这个模块是不是 3 线 I2S、不需 MCLK"。
大部分 20~40 元的 PCM5102A 模块都是板载晶振自给 MCLK 的版本，**SCK 脚都不引出来**。

### 4.6 用好消息：两个 DAC 可以同时接

引脚 54/55/56 **同时**连着板载 MAX98357A 和排针。
所以你可以把 PCM5102A 并接上去，**板载喇叭和外接耳机同时响**，方便对比调试。
不想让板载喇叭响，就把 `tone_test_top.v` 里的 `assign pa_en = 1'b1;` 改成 `1'b0`。

---

## 五、上电前检查清单（照着打勾）

```
□ 断电状态下完成所有接线（I2S 信号线带电插拔有冲击）
□ GND 共地 —— DAC 的 GND 和板子的 GND 是连通的（万用表蜂鸣档确认）
□ VIN 接的是 3V3 不是 5V（除非模块明确标 5V）
□ 3V3 和 GND 之间不短路（万用表电阻档，读数不是 0）
□ BCK / LRCK / DIN 三根没有接反 —— 每根线两头贴标签
□ 喇叭（若用）跨接两个 SPK 焊盘之间，任意一端都没碰 GND
□ 两个 SPK 焊盘之间不短路（万用表电阻档，未接喇叭时应为开路）
□ 先上电，确认板子没发烫、没异味，再插耳机
□ 耳机音量先调到最小，再慢慢加大（440Hz 方波挺刺耳的）
```

---

## 六、最常见 5 个接线错误

| 错误 | 后果 | 现象 |
|---|---|---|
| **忘了共地** | 一定不出声 | 完全安静，或有嗡嗡交流声 |
| BCK 和 LRCK 接反 | 不出声 | 安静，或刺啦刺啦杂音 |
| 喇叭一端接了 GND | **烧 MAX98357A** | 芯片发烫 |
| VIN 接了 5V 但模块是 3.3V | 烧 DAC | 模块发烫 |
| 用了纯充电的 Type-C 线 | 板子没供电 | 电脑认不到串口 |

---

## 七、接线完成后，验证顺序

1. **先看 LED**：`led[0]` 应该以约 1.6 Hz 闪烁 → 说明 FPGA 逻辑在跑
2. **量 BCK**：万用表直流档测引脚 56 对地，应有 **约 1.65V**（3.375 MHz 方波的平均值）
   → 0V 说明没输出，3.3V 说明卡在高电平，都说明有问题
3. **量 LRCK**：引脚 55 对地同样约 1.65V
4. **插耳机听**：应该是干净的 440 Hz 单音
5. **手机频谱 App**：应看到一个尖峰在 440 Hz

---

## 八、相关文件

| 文件 | 内容 |
|---|---|
| `code/rtl/tone_test_top.v` | 440 Hz 验证工程（含板载功放使能） |
| `code/constraints/tone_test.cst` | 引脚约束（54/55/56/51） |
| `code/I2S调试记录.md` | I2S 时序说明 + 不出声的排查顺序 |
| `06-追赶排期（10-08起）.md` | 到天的执行计划 |
