M3-Grant/fpga-synth-engine/docs/iterations/迭代03-12键电子琴.md

# 迭代说明书 03 · 12 键可演奏电子琴（beta3）

> 迭代日期：2026-10-08
> 基线：迭代 02（复音 4 + ADSR）
> 本次目标：**从"能演示"到"能演奏"** —— 交互层落地
> 状态：✅ 完成，9 套仿真全部通过

---

## 一、这次做了什么

| 新增 | 文件 | 说明 |
|---|---|---|
| **按键扫描** | `rtl/key_scan.v` | 12 路独立消抖 + 事件锁存 + 逐拍上报 |
| **12 键板级顶层** | `rtl/synth_board12_top.v` | 可直接上板演奏的完整顶层 |
| **约束文件** | `constraints/synth_board12.cst` | 12 键 + I2S + LED 引脚分配 |
| **测试** | `sim/tb_key_scan.v` | 扫描器单元测试 |
| **测试** | `sim/tb_synth_board12.v` | 12 键集成测试 |

### 与迭代 02 的关系

迭代 02 的 `synth_board_top.v` 用「2 键状态机」切换音阶——**只能演示，不能演奏**。
本迭代把它升级成 12 键直连：**每个键一个音**，覆盖 C4~B4 完整八度（含全部半音）。

---

## 二、12 键布局

| 键号 | 音符 | note_table 索引 | 频率 |
|---|---|---|---|
| KEY0 | C4 | 0 | 261.63 Hz |
| KEY1 | C#4 | 1 | 277.18 Hz |
| KEY2 | D4 | 2 | 293.66 Hz |
| KEY3 | D#4 | 3 | 311.13 Hz |
| KEY4 | E4 | 4 | 329.63 Hz |
| KEY5 | F4 | 5 | 349.23 Hz |
| KEY6 | F#4 | 6 | 369.99 Hz |
| KEY7 | G4 | 7 | 392.00 Hz |
| KEY8 | G#4 | 8 | 415.30 Hz |
| KEY9 | A4 | 9 | 440.00 Hz |
| KEY10 | A#4 | 10 | 466.16 Hz |
| KEY11 | B4 | 11 | 493.88 Hz |

**半音齐全** → 可演奏任意调式，不只是 C 大调。

---

## 三、测试结果

### `tb_key_scan`（扫描器）8 项全通过

```
[检查1] 复位后无事件                          PASS
[检查2] 按下 KEY2 → 音符 D4(索引2)            PASS ×3
[检查3] 松开 KEY2 → note_on=0                 PASS ×2
[检查4] 音符映射抽查 KEY0/4/7/11              PASS ×4
[检查5] 三键同时按下 → 恰好 3 个事件          PASS ×2
```

调试抓到的精确事件流（三键同时按下）：
```
事件#1 t=14: idx=0  ← C4
事件#2 t=15: idx=4  ← E4
事件#3 t=16: idx=7  ← G4
press_lat: 000010010000 → 000010000000 → 000000000000
```
**逐位清除，无重复、无丢失。**

### `tb_synth_board12`（集成）9 项全通过

```
[检查1] 上电静音                              PASS ×2
[检查2] 按 KEY0 → C4，峰值 840                PASS ×4
[检查3] 松键 → 余韵后静音                     PASS ×2
[检查4] 三键同时 → 占用 3 声部，峰值 3096     PASS ×3
[检查5] I2S 翻转正常 + pa_en 拉高             PASS ×2
```

**峰值 840 : 3096 ≈ 1 : 3.7**（单音 vs 三音），复音叠加符合预期。

---

## 四、设计演进：四次改错才定型（重要）

这次 `key_scan` 我改了四版，每一版都踩在**Verilog 的经典陷阱**上。记录下来：

### ❌ 第 1 版：两个 always 块驱动同一组输出

```verilog
// 错误：按下和释放各一个 always 块，都写 note_valid
always @(posedge clk) begin ... note_valid <= 1'b1; ... end   // 按下
always @(posedge clk) begin ... note_valid <= 1'b1; ... end   // 释放
```
**多驱动**，综合会报错或产生不可预期行为。

→ **修正**：合并成单一 always、单一出口。

### ❌ 第 2 版：流式扫描 `key_press`（事件全丢）

```verilog
ST_SCAN_ON: begin
    if (key_press[ptr]) ...    // ← 扫到第 ptr 位时，脉冲早没了
end
```
`key_press` 是 `debounce` 输出的**单周期脉冲**，而扫描要 12 拍才轮到对应位置。

实测证据：
```
t=12  key_press=000000000100   ← 事件脉冲出现
t=13  state=1 ptr=0            ← 状态机才启动
t=15  ptr=2                    ← 扫到 bit2 时，值已是 0
```
→ **修正**：必须先把边沿**锁存成电平**，再逐位处理。

### ❌ 第 3 版：锁存变量的置位与清除分在两个 always 块

```verilog
always @(posedge clk) press_lat <= press_lat | key_press;   // 置位
always @(posedge clk) press_lat[p_idx] <= 1'b0;             // 清除
```
**又是多驱动**——同一个坑踩第二次。

→ **修正**：锁存、上报、清除全部放进同一个 always 块。

### ❌ 第 4 版：给已经是脉冲的信号又锁存一次

```verilog
press_lat <= press_lat | key_press;    // ← key_press 本来就是脉冲，不该再锁存
```
结果 `press_lat` 一直保持置位，**同一个按键被反复上报**（3 键收到 6 个事件）。

→ **修正**：直接用 `key_press` 置位，不要 `|` 累积。

### ✅ 最终版：锁存 + 优先编码 + 逐拍上报清除

```verilog
if (key_press != 0)     press_lat <= key_press;        // 登记新事件
else if (has_press)     press_lat[p_idx] <= 1'b0;      // 上报后清位
if (has_press)          note_valid <= 1'b1; ...        // 逐拍上报
```

---

## 五、测试平台也踩了两次坑

| # | 现象 | 根因 | 修正 |
|---|---|---|---|
| 1 | 全部检查失败，事件数为 0 | `wait_evt` 任务里"监视超时强制清 key_in"，把自己要等的事件打断了 | 改成"驱动信号 → 跑固定周期 → 核对记录"，不用复杂任务 |
| 2 | 三键收到 6 个事件 | 测试里既让监视块 `on_cnt++`，又在循环里 `on_cnt++`，**同一事件数了两遍** | 用 `snap_on = on_cnt` 做快照差值统计 |

> **教训**：测试失败时先怀疑测试。第 2 次"6 个事件"我一开始以为模块有 bug，
> 用调试 testbench 抓到精确事件流（确实是 3 个）才确认是测试计数错。

---

## 六、与竞赛要求的对照

| 竞赛要求 | 迭代 02 | 迭代 03 |
|---|---|---|
| 复音 ≥ 4 | ✅ | ✅ |
| ADSR 包络 | ✅ | ✅ |
| 多声部实时混音 | ✅ | ✅ |
| 单音实时变调 | ✅ | ✅ |
| 纯硬件合成 | ✅ | ✅ |
| 延迟 ≤ 10ms | ✅ | ✅ |
| **≥2 维交互** | ❌ | ⚠️ **第 1 维达成**（12 键演奏） |

**还差第二维交互**（表情/力度/滑音），可用你们已采购的**红外对管**或**避障模块**实现无接触手势。

---

## 七、上板说明

### 7.1 引脚约束（⚠ 必须核实）

`constraints/synth_board12.cst` 里 12 个按键引脚是**候选分配**：
```
key[0..7]  → 25,26,27,28,29,30,31,32
key[8..9]  → 41,42
key[10..11]→ 87,88（板载按键，可先用）
```

**必须对照实物/Wiki 核实** 40pin 扩展口的实际引出引脚。
核实方法：Gowin 里导入约束后看 FloorPlanner，报错的引脚换一个候选即可。

### 7.2 接线（TTP223 触摸模块）

| TTP223 引脚 | 接到 |
|---|---|
| VCC | 板卡 3.3V |
| GND | 板卡 GND |
| I/O | 对应的 key 引脚 |
| A/B 焊盘 | **都不焊**（默认高电平有效，匹配代码 `ACTIVE_LOW=0`） |

### 7.3 上板现象

```
led[0] 闪     → 逻辑在跑（最重要判据）
led[1] 亮     → 有音符在发声
led[2] 闪一下 → 收到按键事件
触摸任一键    → 听到对应音高
同时按三键    → 听到和弦（最多 4 音）
```

---

## 八、下一步

| 方向 | 说明 |
|---|---|
| **第二维交互** | 红外对管/避障模块做无接触手势，或 ADC 做力度 |
| **钢琴音色** | 方波 → 加法合成波表（见与用户的讨论，架构已就绪） |
| **外接 PCM5102A** | 从板载单声道升级到立体声，频谱验证更干净 |

---

## 九、文件清单

```
新增：
  code/rtl/key_scan.v              12 路按键扫描
  code/rtl/synth_board12_top.v     12 键板级顶层
  code/constraints/synth_board12.cst
  code/sim/tb_key_scan.v
  code/sim/tb_synth_board12.v

修改：
  code/run_sim_all.bat             测试从 7 套扩到 9 套

沿用：
  code/rtl/synth_board_top.v       2 键版（保留做对比）
  code/rtl/{synth_top,osc_voice,oscillator_array,note_alloc,adsr,mix_tree}.v
```
