M3-Grant/fpga-synth-engine/docs/assets/README.md

# docs/assets

从 `code/` 根目录整理过来的验证产物：

| 文件 | 来源 |
|---|---|
| `spectrum.png` / `spectrum_verify.png` | 早期钢琴谐波 FFT 验证截图 |
| `synth_demo.wav` / `synth_demo_44k.wav` | 离线仿真导出的演示音频（52.7 kHz / 44.1 kHz） |
