M3-Grant/fpga-synth-engine/docs/20-下一步拓展计划.md

# 20 · 下一步拓展计划（v1.0.0 之后一周）

> 制定日期：2026-10-31
> 基线版本：**v1.0.0**（校赛视频录制版，可随时 `git checkout v1.0.0` 回退）
> 读者：团队三人 + 接手的 AI。**每一项都给了"怎么做、要多久、风险在哪、怎么验收"。**

---

## 一、先看清评分规则（决定优先级）

赛题的核心评分公式（`docs/01` 第 27 行原文）：

> **吞吐量 = 同时活跃可闻独立振荡器总数 × 实际音频输出采样率**

**加法合成的计数口径**：按**运算分量**统计。

| 量 | 当前值 | 说明 |
|---|---|---|
| 声部数 | **4** | `piano_engine.VOICE_NUM` |
| 每声部谐波 | **6** | `HARM_NUM` |
| **加法分量** | **24** | 4 × 6 |
| 采样率 | 52734.375 Hz | 27 MHz ÷ 8 ÷ 64 |
| **吞吐量** | **≈ 1.27 M 分量·采样/秒** | 24 × 52734 |

**拓展加分项**（`docs/01` 第 46 行）：

| 加分项 | 现状 | 差距 |
|---|---|---|
| 复音 ≥32 **或** 加法分量 ≥32 路 | 24 路 | **差 8 路** |
| ≥3 维表情 | 2 维 | 差 1 维 |
| ≥2 音色切换 | ✅ 5 档 | **已满足** |
| 硬件混响/延迟/合唱 | ❌ | 大工程 |
| 延迟 ≤5 ms 且无抖动 | 未测量 | 需埋时间戳 |
| 视听反馈 | ✅ 上位机 | 已满足（可再改） |
| 脱机/智能联动 | ❌ | 低优先 |

---

## 二、优先级排序（按"性价比"= 加分 ÷ 工作量）

| # | 方向 | 预期收益 | 工作量 | 风险 | 优先级 |
|---|---|---|---|---|---|
| **1** | **加法分量 24 → 32+**（跨过加分线） | ⭐⭐⭐ 直接拿拓展分 | 2~3 天 | 低 | **P0** |
| **2** | **延迟真实测量（≤5 ms）** | ⭐⭐ 一个独立加分项 | 1 天 | 低 | **P1** |
| **3** | **第 3 维表情** | ⭐⭐ 一个独立加分项 | 1~2 天 | 中 | **P1** |
| 4 | 音频噪声治理（独立电源 + 接地） | 音质，影响主观分 | 半天 | 中 | **P2** |
| 5 | 硬件混响 | ⭐ 一个加分项 | 3~5 天 | **高** | P3 |
| 6 | 脱机运行 | ⭐ | 2 天 | 中 | P3 |

> **一句话策略**：先把"加法分量"这条跨线（24→32 只差 8 路，几乎白送），
> 再补"延迟测量"和"第 3 维"两个独立加分项，最后才碰混响。

---

## 三、逐项方案

### P0-1：加法分量 24 → 32+（推荐路线：声部 4→6）

**为什么不是"谐波 6→8"**：每声部谐波增加会让串行乘加变长（当前 24 拍，改 32 拍会拉长单采样处理时间，逼近 512 clk 窗口上限）。增加声部更安全，而且复音数本身也是评分乘数。

**方案**：`VOICE_NUM = 4 → 6`
- 加法分量：6 × 6 = **36 路** ✅ 跨过 32 线
- 资源预估：Logic 30% → **约 42%**，DSP 3 → 5/24，Register 14% → 20%
- 单采样处理时间：6 声部 × 6 谐波 = 36 拍 < 512 clk 窗口 ✅

**改动点**（全部集中在 `piano_engine.v` 的参数 + `synth_top.v` 的例化）：
1. `synth_top`: `VOICE_NUM = 6`
2. `note_alloc`: 支持 6 声部（已经是参数化的）
3. `piano_engine`: `VOICE_NUM = 6`，检查 `ST_END/ST_ACCL/ST_OUT` 推导是否仍正确
4. 回归：`tb_piano_engine`、`tb_synth_top`、`tb_synth_board12`、`tb_synth_ttp229`

**验收标准**：
- 6 个键同时按下 → 6 个音都响且互不打断
- 上板逻辑 ≤ 50%，时序收敛（无负 slack）
- 14 套回归全过

**风险**：`mix_tree` 是 20 位累加，6 声部 × 6 谐波可能更容易饱和 → 需要在 `piano_engine` 内部做每声部饱和，或在 `mix_tree` 提高阈值。**已预留：`piano_engine` 自带 `saturate()`**。

---

### P0-2：加法分量继续冲 48（可选，如果 P0-1 顺利）

如果 6 声部通过且资源 ≤ 55%，可以再试 **`VOICE_NUM = 8`**（48 路）。

- 风险：36 拍 → 48 拍，仍 < 512 clk ✅
- 但 Logic 可能到 55~60%，需要看时序报告
- **决策点**：P0-1 完成后立刻看综合报告，资源余量 > 25% 才上 8 声部

---

### P1-1：延迟真实测量（目标 ≤5 ms 且无抖动）

**当前问题**：上位机的"演奏延迟"面板显示 `—— ms`，因为固件里没埋时间戳（我们不想编数字）。

**方案**：
1. 在 `key_scan` 输出 `note_valid` 的时刻，记下 `clk` 计数器值 → `t_press`
2. 在 `piano_engine` 第一个采样输出的时刻，记下 `t_sound`
3. `lat = t_sound - t_press`（clk 周期，1 clk = 37.037 ns）
4. 统计 min / max / sum / count + 16 格直方图（每格 2.4271 ms）
5. 填入 `uart_stream` 帧的 `[520..575]` 段（现在全是 0）

**为什么能进 5 ms**：
- TTP229 扫描 20 ms + 消抖 10 ms = **30 ms** ← **这是大头！**
- 如果只算"消抖完成后到起音"：消抖 10 ms + 起音 64 采样（1.2 ms）≈ **11 ms**
- **要真正 ≤5 ms，必须把消抖从 10 ms 降到 2~3 ms**（触摸按键不需要 10 ms 消抖）

**关键改动**：
- `key_scan.CNT_MAX`：270000（10 ms）→ **81000（3 ms）**
- 或给 TTP229 路径单独一套更快的消抖参数

**验收标准**：
- 上位机延迟面板显示真实数字（不再是 `——`）
- 平均值 ≤ 5 ms，最大值 ≤ 8 ms，抖动（max-min）≤ 3 ms

**风险**：消抖降到 3 ms 可能引入误触 → 需要实测；如果误触，折中到 5 ms。

---

### P1-2：第 3 维表情（≥3 维加分）

**现状**：2 维（12 键音高 + 挥手音色）。

**候选方案**（按工作量排）：

| 方案 | 怎么实现 | 工作量 | 风险 |
|---|---|---|---|
| **A. 长按力度**（推荐） | TTP229 按住时长 → 映射到音量（短按弱、长按强） | **半天** | 低（纯数字延时） |
| B. 二次挥手弯音 | 两次挥手间隔 → FCW 微调（特雷门琴式） | 1 天 | 中（侵入 FCW 通路） |
| C. 第二个红外左/右 | 左挥降调、右挥升调 | 1 天 | 中（需要第二个模块 + 新引脚） |

**推荐 A**：不增加硬件，复用现有 TTP229 的"按下时长"，在 `key_scan` 里加一个"按住计数器"，输出 `velocity` 给 `piano_engine` 做幅度缩放。

**验收标准**：
- 轻点（<100 ms）声音弱，按住（>500 ms）声音强
- 3 个维度可同时作用（音高 + 音色 + 力度）

---

### P2：音频噪声治理（影响主观分，但非硬指标）

**已确认的结论**（写进 v1.0.0 Release Notes）：
- 噪声产生在 PCM5102A 之后（数字静音时噪声不变）
- 数字域手段无效（噪声门实验证明）

**方案**（按成本）：
1. **独立 5V 给 PAM8403** + **星形接地**（半天，最有效）
2. PAM8403 电源并 1000 µF（需买电容）
3. 若仍有噪声 → 换带 LC 滤波的 PCM5102A 模块

**验收标准**：录音频谱里 1k/2k/5k/10k 谐波相对当前基线下降 ≥10 dB。

---

### P3：硬件混响（大工程，谨慎）

**为什么不推荐先做**：
- 需要 BSRAM 存延迟线（当前 BSRAM 完全未用，有空间）
- 但混响会**占用大量乘法器**，与"提高复音"直接冲突
- 而且评分是"吞吐量"，混响不增加振荡器数

**如果一定要做**：先做最简单的"单抽头延迟 + 反馈"（约 1 天），验证能听出空间感即可。

---

## 四、一周排期（建议）

| 日期 | 上午 | 下午 | 交付物 |
|---|---|---|---|
| **D1** | 读 v1.0.0 代码，跑一遍 14 套回归确认基线 | 改 `VOICE_NUM=6`，综合看资源 | 6 声部初版 |
| **D2** | 修 6 声部的饱和/时序问题 | 上板验证 6 键同时按 | **36 路加法分量** ✅ |
| **D3** | 延迟时间戳埋点（`key_scan` + `piano_engine`） | 填进 `uart_stream`，UI 看真实延迟 | 延迟测量功能 |
| **D4** | 消抖 10ms→3ms，测真实延迟 | 若不达标，调参；达标则记录数据 | **延迟 ≤5ms** ✅ |
| **D5** | 长按力度（第 3 维） | 上板验证 | **3 维表情** ✅ |
| **D6** | 独立 5V + 星形接地（硬件） | 录音对比噪声 | 噪声下降数据 |
| **D7** | 更新文档、录第二版视频、发布 v1.1.0 | 缓冲 | **v1.1.0** |

---

## 五、验收清单（D7 逐项打勾）

- [ ] 加法分量 ≥ 32（实测声部数 × 谐波数）
- [ ] 延迟面板显示真实数字，平均 ≤ 5 ms
- [ ] 3 个维度可同时作用
- [ ] 14 套回归全过
- [ ] 综合时序收敛（正 slack），Logic ≤ 60%
- [ ] 噪声对比录音（改造前后各一段）
- [ ] 文档更新：README / 00-先看我 / docs/20
- [ ] 发布 v1.1.0（含新固件 + Release Notes）

---

## 六、回退策略

**每个阶段都可能失败，回退只有一个动作**：

```powershell
git checkout v1.0.0          # 回到录制视频的那一版
```

**分支策略**：
- `master` 只放已验证的版本
- 实验性改动走分支（如 `feat/6voice`），验证通过再合并
- 每个交付点打 tag（`v1.1.0-rc1` → `v1.1.0`）

---

## 七、需要团队决定的三件事

1. **6 声部还是 8 声部？** 建议先 6（36 路，稳），看资源再决定要不要 8（48 路）
2. **第 3 维用哪个方案？** 建议 A（长按力度，不增加硬件）
3. **噪声治理要不要买电容？** 需要 1000 µF 电解 + 0.1 µF 陶瓷（几块钱）

**这三件事定了，我就可以按 D1 开始改代码。**
