M3-Grant/fpga-synth-engine/docs/15-审查报告-beta.2.1与代码复审.md

# 15 · beta.2.1 审查结论 & 现有 RTL 代码复审

> 审查日期：2026-10-18
> 审查对象：队友上传的 `fpga-synth-engine-beta.2.1.zip`（2026-10-16）+ 仓库 `master` 上的 `beta.2` 代码
> 结论：**功能改动接受**（+6 dB 音量），**发布流程与文档打回并已在本仓库修正**；另有 3 项 RTL 风险需要跟进。

---

## 一、beta.2.1 逐项核查

所有结论均为**独立复现**，不采信发布说明的自述。

| # | 核查项 | 方法 | 结果 |
|---|---|---|---|
| 1 | 改动范围是否真的只有音量 | 与 `beta.2`（`2e4250c`）逐文件比对 rtl / sim / constraints / docs / tools | ✅ 仅 `synth_board12_top.v`（AMP `16'sh1800` → `16'sh3000`）+ `tb_synth_board12.v`（断言 `700~1300` → `1700~2150`） |
| 2 | 仿真是否 10/10 通过 | `run_sim_all.ps1`（扫描 `[FAIL]`，不是看退出码） | ✅ `ALL SIMULATIONS PASSED (10 suites)` |
| 3 | 实测峰值 | `tb_synth_board12` 输出 | 单音 **1928**、三音和弦 **7659**（理论单声部峰值 ≈ 1931，误差 0.16%） |
| 4 | 综合是否 0 Error | 用同一套源码重跑 `build.ps1 -Target synth_board12` | ✅ 0 Error，仅 2 条既有 Warning（`clk` 未建约束、`clk_d` 走通用布线） |
| 5 | 预编译码流是否真的来自这份源码 | 重综合后逐行比较 `.fs` | ✅ 1378 行中**只有第 19 行 `//Created Time` 不同**；`CheckSum`/`UserCode = 0x85B6` 两侧一致 |
| 6 | `SHA256SUMS.txt` 是否可信 | 对 87 条逐项算 SHA-256 | ✅ 87/87 全部匹配 |
| 7 | +6 dB 是否合理、会不会削波 | 手算链路：`AMP × (env+1)/256 ÷ 4` | ✅ 单声部 1931、4 声部同相最坏 7724 / 32767 = 23.6%，余量 12.5 dB |
| 8 | 是否夹带可执行文件 | 扫描包内扩展名 | ✅ 只有 `.ps1/.py/.bat` 文本脚本，无二进制可执行 |

### 数学口径的小修正（不影响结论）

发布说明与 `docs/14` 用 `AMP × 160/255 ÷ 4 = 1928` 推峰值。实际链路是：

```
osc_voice 的包络增益 = (env + 1) / 256，env = SUS_LEVEL = 160 → 161/256
三角波折叠后的峰值是 12287，不是 12288（≥16383×12288 >> 14 的截断）
→ 理论峰值 = 12287 × 161 / 256 ÷ 4 = 1931.9，取整 1931
```

实测 1928 略低于 1931，是因为测试台每个采样只取一个点，离散采样没有正好落在三角波顶点上（窗口 150000 clk ≈ 293 个采样，C4 一个周期约 201 个采样）。
**结论不变：+6 dB 精确成立，余量充足。** 已在 `00-先看我.md` 中改写成"理论 ≈ 1931 / 实测 1928"。

### 两个必须打回的问题（已在 `master` 上修正）

**P1 · 标签和提交号是虚构的。**
发布说明与 `docs/14` 都写"对应 git 标签 `beta.2.1`（提交 `4d468d8`）"，但：

- `git ls-remote --tags origin` 里没有 `beta.2.1`
- 本地也没有 `4d468d8` 这个提交
- 实际远程最新提交是 `8e546d3`（"Add files via upload"），它是**把 552 KB 的 zip 直接提交进仓库根**

后果：任何人按发布说明去 `git checkout beta.2.1` 都会失败。

处理：本次提交 `23607f7` 已把改动正式落库，并打了 annotated tag `beta.2.1`；zip 已从索引移除（`*.zip` 加入 `.gitignore`，发布包改走 GitHub Release 附件）。

**P2 · `00-先看我.md` 与 `README.md` 严重过时。**
两份文档都停留在 **2026-10-08** 那一版：

| 文档声称 | 实际情况 |
|---|---|
| 7 个 RTL（`i2s_tx`/`tone_test_top`/`note_table`/`led_ctrl_top`/`clk_div`/`debounce`/`pwm`） | **17 个** RTL，缺 `synth_top`/`osc_voice`/`adsr`/`note_alloc`/`mix_tree`/`key_scan`/`synth_board12_top`/`chord_demo_top` 等 8 个核心模块 |
| "合计 21 项检查" | 现在是 **10 套回归、上百项检查** |
| `run_sim_all.bat` 跑三套 | 实际 10 套，且必须用 `.ps1`（`.bat` 只看退出码会假报 PASS） |
| `pa_en` 固定为 1 | 已改为有音符才开、静音 155 ms 自动关 |
| 没有顶层/资源/烧录信息 | 需要补 12 键引脚表、资源占用、码流 UserCode、上板判据 |

处理：两份文档已按当前代码重写（本次提交）。`run_sim_all.bat` 也改成转调 `.ps1` 的薄壳，不再存在"假 PASS"陷阱。

### 轻微问题（记录，不阻断）

- `note_table.v` 在包内是 **LF**、在仓库里是 **CRLF**，与 `.gitattributes` 的 `* -text`（保持原始字节）不符。
  语义完全一致（同一份 47 行内容），但说明打包过程走过一次行尾归一化，与"与 git 标签完全一致"的说法有出入。
- 发布说明里的 Gowin 路径是 `D:\Tools\Gowin\...`（那是队友机器的路径），本机是 `D:\Gowin\...`。README 已写明需用 `-GowinHome` 覆盖。

---

## 二、现有 RTL 复审（面向"钢琴谐波"改造）

按优先级排列，**P1 会在本次钢琴改造中一并修掉**。

### P1 · 抢占第 5 个音时没有音头（`note_alloc` + `adsr` 配合缺陷）

`adsr.note_on` 接的是 `voice_trig[g] | voice_busy[g]`。抢占发生时 `voice_busy` 一直是 1，
`voice_trig` 只脉冲 1 拍，所以 `note_on` **没有上升沿** → `trig_edge` 不产生 → 包络不会重新起音。

现象：4 个声部占满后按第 5 个键，音高会立刻变，但包络停在上一个音的状态（可能已经在衰减末端），
听感是"这个音没有音头、发虚"。对钢琴音色尤其致命，因为钢琴最依赖敲击音头。

修法：给 `adsr` 增加独立的 `trig` 端口，直接接 `voice_trig[g]`，不再靠 `note_on` 的边沿。

### P2 · 年龄计数器会溢出（`note_alloc`）

`voice_age` 是 32 位、每个 clk 递增：`2^32 / 27e6 ≈ 159 秒`。
若一个和弦持续按住超过 2 分半，计数器回绕，抢占时"最早分配"的判据失真。
实际演奏概率低，但伴奏持续和弦是真实场景。建议改成"只递增到上限就停"（饱和计数）。

### P3 · `mix_tree` 的求和位宽不随 `VOICE_NUM` 缩放

`SUM_BITS = IN_BITS + 4` 是写死的。当前 `VOICE_NUM=4`、峰值 7727 时最大 30908，20 位装得下（上限 524287）；
但如果以后把复音数改到 8/16，`IN_BITS + 4` 不够，`sum` 会悄悄溢出（饱和逻辑只能兜底，不能救数据）。
建议改成 `SUM_BITS = IN_BITS + $clog2(VOICE_NUM) + 2`。

### P4 · LED 事件指示的展宽时间与注释不符

`evt_stretch` 用 `blink[22:0] == 0` 清除，`2^23 / 27e6 ≈ 0.31 s`，注释写的是 0.2 s。纯文档问题。

### 已确认正常、无需改动的点

- `key_scan` 的"合并 → 上报 → 清除"单 always 结构：和弦丢音问题已修复，逻辑正确
- `pa_en` 门控：`pa_hold` 155 ms 远大于包络 release 的约 1 ms，不会被切断
- `adsr` 的事件锁存（`trig_pending`/`rel_pending`）与 `sample_en` 同拍取旧值的行为正确，最多 1 个采样周期延迟
- `osc_voice` 四种波形均无直流偏置；`AMP` 为编译期常量，乘法被综合成移位加法，不抢 DSP
- `mix_tree` 饱和边界用显式常量（避免早期 `1<<<` 综合出 X 的问题），保持现状

---

## 三、给队友的修改清单

1. **不要再本地打 tag 后打包上传**。要发布就走：提交 → `git push` → 打 tag → `gh release create`，
   否则别人拿到的"版本号"在仓库里根本不存在。
2. **不要往仓库根塞 zip**。发布包放 Release 附件；仓库只放源码与 prebuilt 码流。
3. 文档随代码一起改。`00-先看我.md` / `README.md` 是评委第一入口，过时的杀伤力比代码 bug 更大
   （第 2 节那张表就是证据）。
4. 打包前跑 `run_sim_all.ps1`（不是 `.bat`）和一次 `build.ps1 -Program none`，并把两者的原始输出贴进发布说明。
5. 若继续调音量，改 `synth_top.v` 的 `mix_out[17:2]` → `[16:1]`（÷4 → ÷2，+6 dB）比继续抬 `AMP` 干净；
   但注意此时 4 声部最坏峰值会到 15448 / 32767（47%），仍安全。
