M3-Grant/fpga-synth-engine/docs/16-钢琴音色迭代.md

# 16 · 钢琴音色迭代（beta.3 候选）

> 日期：2026-10-18
> 目标：把"能响"升级成"像钢琴"—— 用真正的谐波结构取代单一波形
> 状态：RTL + 仿真 + FFT 验证完成，综合通过；**尚未上板试听**

---

## 一、为什么原来的声音不像钢琴

beta.2.1 的链路是「三角波 × ADSR」：

| 环节 | 问题 |
|---|---|
| 波形 | 三角波只有**奇次**谐波，幅度按 1/n² 衰减 → 听起来接近长笛/口琴 |
| 包络 | ADSR 有 SUSTAIN 平台：按住不放就一直响 → 这是风琴/合成器的行为，不是钢琴 |
| 音头 | 线性起音，没有"敲击"的亮度变化 |
| 全曲听感 | 同一个音的频谱**从头到尾不变**，缺少"敲下去亮、随后变暗"的过程 |

钢琴的声音有三个不可替代的特征：

1. **谐波结构**：1、2、3、4、5、6 次谐波全都存在，幅度大致按 1/h^1.5 衰减；
2. **音头亮、尾部暗**：高次谐波衰减速度比基波快得多（这是"钢琴味"的核心）；
3. **固定衰减、无 sustain**：琴弦能量一直在衰减，松键只是踩下制音器让衰减变快。

---

## 二、实现方案（为什么选加法合成）

| 方案 | 做法 | 优点 | 缺点 | 结论 |
|---|---|---|---|---|
| A 波表（BSRAM） | 预存"亮/暗"两张单周期波形，按亮度包络交叉淡化 | 资源省、实现简单 | 波形是**固定循环**的：频谱只随两表混合比例变化，颗粒度粗；且需要外部 .mem 初始化，Gowin 综合对 `$readmemh` 支持不稳 | 备选 |
| B **加法合成（本实现）** | 每声部 6 个正弦振荡器（谐波 1..6），每个谐波有自己的幅度与衰减速率 | 频谱可控、音色变化真实，答辩讲得清 | 需要正弦表 + 多路乘加 | ✅ 采用 |
| C 只换包络 | 保持三角波，只把 ADSR 改成 AD | 改动最小 | 频谱还是错的，"像钢琴"只做到一半 | 不足 |

正弦用 **32 点表 + 一阶线性插值**（等效 512 点精度，谐波失真约 -60 dB），
表用 `case` 常量写死在 `piano_engine.v` 里，不依赖任何外部文件。

---

## 三、`piano_engine.v` 设计要点

```
4 声部 × 6 谐波 = 24 路
每路：32 位相位累加器（步进 = h × FCW）+ 16 位包络 + 起音标志
每采样：串行走 24 路（st 0..27），读相位/包络 → 正弦插值 → 乘包络 → 累加
输出：累加结果 >>> 2，饱和到 16 位
```

### 3.1 谐波权重 A[h]（和为 65536，正好满量程）

| h | 1 | 2 | 3 | 4 | 5 | 6 |
|---|---|---|---|---|---|---|
| A[h] | 35840 | 12672 | 6912 | 4480 | 3200 | 2432 |
| 近似 | 1.000 | 0.354 | 0.193 | 0.125 | 0.089 | 0.068 |
| 相对基波 | 0 dB | -9.0 | -14.3 | -18.1 | -21.0 | -23.4 |

形状取 1/h^1.5 —— 比锯齿波的 1/h 更"暗"，符合钢琴能量集中在低次谐波的事实。

### 3.2 每谐波独立衰减（这是"变暗"的来源）

指数衰减用 `env -= (env >> s) | 1` 实现，时间常数 τ = 2^s 个采样：

| h | 1 | 2 | 3 | 4 | 5 | 6 |
|---|---|---|---|---|---|---|
| s | 14 | 13 | 13 | 12 | 12 | 11 |
| τ | 310 ms | 155 ms | 155 ms | 78 ms | 78 ms | 39 ms |
| 衰到 -60 dB | 2.2 s | 1.1 s | 1.1 s | 0.54 s | 0.54 s | 0.27 s |

`| 1` 保证末段仍有 1 的步进，不会因为 `env>>s == 0` 而卡住。

### 3.3 起音与止音

| 阶段 | 行为 | 时长 |
|---|---|---|
| 起音 | 每采样 +`A[h]>>6`，64 拍到顶 | ≈ 1.2 ms（模拟琴棰击弦） |
| 按住 | 按各自 τ 衰减，**没有 sustain** | 2 s 量级 |
| 松键 | `env -= (env>>9)|1`（damper） | 实测 75 ms 内归零 |

### 3.4 时序

`i2s_tx` 的 `sample_req` 在右声道 LSB 处脉冲，到下一帧锁存样本还有
16 个 BCK = 16 × 2 × BCK_HALF = **128 clk**（BCK_HALF=4）。
本模块用 **28 clk** 算完 24 路（三级流水：正弦 → 乘包络 → 累加），余量 4.5 倍。

### 3.5 位宽与峰值（改参数时必须重算）

```
单项     = sin16(±32767) × env(0..A[h]) >> 16      |项| ≤ A[h]/2
单声部   = ΣA[h]/2 = 32768            （理论上界，实际远小于此）
4 声部   = 131072                     → 24 位累加器够
输出     = acc >>> 2 → 4 声部最坏 32768，饱和兜底
```

---

## 四、验证结果（全部为实测，不是估算）

### 4.1 仿真（`tb_piano_engine.v`，10 项检查全 PASS）

| 检查 | 实测 |
|---|---|
| 无触发时输出 | 恒为 0 |
| 单音 C4 峰值 | **5051**（beta.2.1 三角波为 1928，约 +8.4 dB） |
| 0.23 s 后峰值 | 2712（包络确实在衰减，仍非静音） |
| 松键后 damper | +18 ms 1752 → +37 ms 244 → +56 ms 40 → **+75 ms 0** |
| 4 音和弦峰值 | **15117**（≤ 32767，不削波） |
| 重复敲同一个音 | 包络重新起音，有音头 |

### 4.2 FFT 谐波验证（`tools/verify_piano.py`）

音头窗口（0～78 ms）：

| 谐波 | 1 | 2 | 3 | 4 | 5 | 6 |
|---|---|---|---|---|---|---|
| 幅度 | 3712.7 | 1226.1 | 613.7 | 296.8 | 142.8 | 71.9 |
| 相对基波 | 0 dB | -9.6 | -15.6 | -21.9 | -28.3 | -34.3 |

- 实测基频 **260.9 Hz**（理论 261.63，偏差 **-0.26%**）
- 衰减后窗口（114～191 ms）：3 次谐波从 -15.6 dB 掉到 -61.5 dB
- **高次谐波总占比：音头 0.63 → 衰减后 0.18** —— "音色由亮变暗"被量化验证

### 4.3 综合与资源（Gowin V1.9.11.03，`build.ps1 -Target synth_board12`）

| 项 | beta.2.1（三角波） | 本次（钢琴） |
|---|---|---|
| Error | 0 | **0** |
| Logic | 2061 / 20736（10%） | **5066 / 20736（25%）** |
| Register | 841 / 15750（6%） | **1782 / 15750（12%）** |
| DSP | 2 / 24（8%） | **1 / 24（4%）** |
| BSRAM | 0 | 0（正弦用 LUT 表，没占 BSRAM） |
| Warning | 2 条（时钟） | 2 条时钟 + **10 条 NL0002** |

**关于那 10 条 `NL0002 ... is swept in optimizing`**：这不是错误。因为
`synth_board12_top` 把 `wave_sel` 固定成 `3'b100`，综合器据此判定
`mix_out[17:2]` 分支是死代码，于是把 `osc_voice`×4 / `adsr`×4 / `mix_tree` /
`oscillator_array` 整条老通路优化掉了。这正好省下资源。

代价：**当前比特流里只有钢琴音色**，运行时切不到三角/方波。
第二交互维度接入后，`wave_sel` 会由 `gesture_ctrl` 驱动（不再是常量），
届时老通路会重新被综合进来，资源预计涨到 **约 6500 LUT（31%）** —— 仍然宽裕。
`synth_top` / `synth_board` 两个测试台分别用 `3'b000` 验证老通路，两条路都测过。

---

## 五、怎么用

`synth_top` 的 `wave_sel` 从 2 位扩到 3 位：

| wave_sel | 音色 | 通路 |
|---|---|---|
| 3'b000 | 三角波 | osc_voice → mix_tree |
| 3'b001 | 方波 | 同上 |
| 3'b010 | 锯齿波 | 同上 |
| 3'b011 | 脉冲 25% | 同上 |
| **3'b100** | **钢琴** | **piano_engine（独立通路）** |

- `synth_board12_top` 默认 `3'b100`（钢琴）
- `synth_board_top`（2 键降级版）保持 `3'b000`（三角波），便于与 beta.2 对照
- `chord_demo_top` 自动演示 5 种音色轮换，第 5 轮是钢琴
- 第二交互维度接入后，用 `gesture_ctrl` 驱动 `wave_sel` 即可现场切音色

---

## 六、已知局限 / 下一步

| 项 | 现状 | 改进方向 |
|---|---|---|
| 钢琴的**非谐性**（inharmonicity） | 谐波严格是整数倍 | 高次谐波相位增量加一个微小偏移（±0.1%），更像真实琴弦 |
| **同音多弦失谐**（beating） | 未做 | 每声部再叠一个 ±0.3 Hz 的伴生振荡器，资源约 +30% |
| **力度分层**（velocity） | 未做，所有音同样响 | 需要第二维输入（红外测距）给出 0~1 的力度，映射到 A[h] 与亮度包络 |
| 高次谐波实测比理论低 3~5 dB | FFT 窗口内已衰减所致 | 若要精确对照，应用"包络补偿后的频谱"比较 |
| 上板试听 | **未做**（按要求不烧板） | 等确认后再烧 SRAM 试听 |
