M3-Grant/fpga-synth-engine/docs/13-总体分析与beta.2发布说明.md

# 项目总体分析 & beta.2 发布说明

> 发布日期：2026-10-15
> 版本：**beta.2**
> 对应 commit：见 tag `beta.2`

---

## 一、版本演进

| 版本 | 日期 | 关键内容 | 状态 |
|---|---|---|---|
| `demo0.0.1` | 10-08 | 离线仿真快照 | 已归档 |
| `demo0.0.2` | 10-08 | 离线仿真快照（含 12 键） | 已归档 |
| `beta.1` | 10-14 | 12 键可演奏电子琴，第一代能跑的 demo | 已发布 |
| `beta.1.01` | 10-14 | 修 `tb_synth_top.v` 前向引用编译错误 | 已发布 |
| **`beta.2`** | **10-15** | **上板出声 + 音色升级 + 功放门控 + 按键修复** | **本次** |

---

## 二、beta.2 相对 beta.1 的实质变化

### 1. 硬件链路首次打通（10-14）—— 从"仿真通过"到"板上出声"

| 环节 | 结果 |
|---|---|
| USB 枚举失败 | 根因是**数据线**（`VID_0000&PID_0002` / `ProblemCode 43`） |
| 换线后 | `VID_0403&PID_6010` = FTDI FT2232H，**免驱**，COM9/COM10 |
| JTAG | 扫到 `GW2AR-18C` / ID `0x0000081B` |
| 构建流程 | 新增 `code/synth/build.ps1`，**命令行全自动**（不需要打开 Gowin IDE 建工程） |
| 首次上板 | **`tone_test_top` 440 Hz 出声，LED 心跳正常** |

**关键技术坑**（已固化进构建脚本）：
- 引脚 **54/55/56 是 SSPI 专用功能脚**，必须 `set_option -use_sspi_as_gpio 1`，否则 P&R 直接失败
- 命令行工具必须设置 `GOWINHOME` 环境变量

### 2. 音色升级（10-15）

| 项 | beta.1 | beta.2 |
|---|---|---|
| 波形 | 方波（奇次谐波按 1/n 衰减） | **三角波**（按 1/n²，3 次谐波低 9.5 dB） |
| 波形切换 | 无 | **4 种运行时切换**：三角/方波/锯齿/脉冲 |
| 音量档位 | 1/4 满量程（实测刺耳） | **3/16 满量程**（实测定档） |
| 频谱表现 | 能量拖到 10 kHz 以上，10~100 Hz 有 −40~−60 dB 的跳变冲击 | 高频衰减明显加快，低频降到 −70~−90 dB |

**实测依据**：手机频谱 App 对比。三角波不仅削弱了高次谐波，连低频都变干净了 ——
因为**方波每次翻转都是瞬时跳变**，会产生宽频冲击；三角波是连续折线，没有跳变。

### 3. 功放门控降温

| 项 | beta.1 | beta.2 |
|---|---|---|
| `pa_en` | `1'b1` **常开**（静音时功放也全程上电） | 有音符发声立刻开启，**静音 155 ms 后自动关闭** |

保持窗口（155 ms）是为了避免音符间隙反复开关功放产生"啪"声。
**这是针对实测"板子过热"的直接修复。**

### 4. 按键逻辑修复（**队员贡献**）

| 文件 | 问题 | 修复 |
|---|---|---|
| `rtl/key_scan.v` | `press_lat <= key_press` **覆盖赋值**，和弦多拍上报途中若有新键按下，未上报的位被冲掉 → **那个音不响** | 改为"合并 → 上报 → 清除"同拍完成 |
| `constraints/synth_board12.cst` | `key[5]` 分配到**引脚 32**，而 32 **未引出到 40pin 排针** | 改为 **26**（IOB6B / LCD_VS） |
| `sim/tb_key12_notes.v` | 新增 | 精确构造了上述 bug 的时序场景 |

**这两处都经过独立复核**（不是采信自述）：

1. **按键 bug**：用他的测试台分别跑两份代码 —— 我们的版本在检查3 报
   `[FAIL] 音符 7 (G4) note-on 次数 = 0`，他的版本 4 个音全部收到。**bug 真实存在**。
2. **引脚 32**：放大核对 Sipeed 引脚图，左侧排针编号为
   `73 74 75 85 77 15 16 27 28 25 26 29 30 31 17 20 19 18 3V3 GND`，
   右侧为 `5V GND 76 80 42 41 56 54 51 48 55 49 86 79 GND 3V3 72 71 53 52` ——
   **40 个位置里没有 32，而 26 在左侧**。**他的修正正确**。

### 5. 测试体系修正

| 项 | 问题 | 修复 |
|---|---|---|
| `run_sim_all.bat` | **只看退出码** → 把含 2 个 `[FAIL]` 的运行报成 `ALL PASSED` | 新增 `run_sim_all.ps1`，**扫描输出里的 `[FAIL]`** |
| 3 个 tb 的观测窗口 | 只有 5.8~7.8 个音频采样，方波时碰巧能采到峰值，**换三角波后必然漏采** → 假 FAIL | 放宽到 150000 clk（≈2.4 个周期） |
| `tb_synth_board` 的 `pa_en` 检查 | 只测"发声时为 1"，且时机在长时间静音之后 | 改为**双向覆盖**：发声时为 1、静音 208 ms 后为 0 |

修正后实测峰值与理论**完全吻合**：`AMP × 160/255 ÷ 4`
→ AMP=8192 时 `1285`（实测 1283）；AMP=6144 时 `964`（实测 964）。

---

## 三、架构总览

```
   12× TTP223 触摸键
          │
          ▼
    ┌──────────┐
    │ debounce │ ×12        10 ms 消抖，输出单周期 press 脉冲
    └────┬─────┘
         ▼
    ┌──────────┐
    │ key_scan │            锁存边沿 + 优先编码 + 逐拍上报（每拍一个音符事件）
    └────┬─────┘
         │ note_valid / note_on / note_idx
         ▼
    ┌────────────┐
    │ note_alloc │          声部分配：复用 → 空闲 → 抢占最老
    └─────┬──────┘
          │ voice_busy / voice_note / voice_trig
          ├──────────────────────────┐
          ▼                          ▼
    ┌───────────┐            ┌────────────┐
    │ note_table│ ×VOICE_NUM │   adsr     │ ×VOICE_NUM
    │ 音符→FCW  │            │ A→D→S→R    │
    └─────┬─────┘            └─────┬──────┘
          │ fcw                    │ env
          ▼                        ▼
    ┌───────────────────────────────────┐
    │        oscillator_array           │  generate 例化 N 份
    │  ┌─────────────────────────────┐  │
    │  │ osc_voice                   │  │
    │  │  DDS 相位累加器              │  │
    │  │  wave_sel → 4 种波形         │  │
    │  │  × env 包络调制              │  │
    │  └─────────────────────────────┘  │
    └───────────────┬───────────────────┘
                    ▼
            ┌──────────────┐
            │  mix_tree    │  求和 + 饱和（20 位）
            └──────┬───────┘
                   │ mix_out[17:2]  →  16 位（÷4 留余量）
                   ▼
            ┌──────────────┐
            │   i2s_tx     │  fs = 52734.375 Hz = 27MHz/8/64
            └──────┬───────┘
                   ▼
        板载 MAX98357A（I2S DAC + D 类功放）
                   │  pa_en 门控（有音符才开）
                   ▼
               喇叭
```

**顶层模块**（4 个，用途不同）：

| 顶层 | 用途 | 是否需要外部接线 |
|---|---|---|
| `tone_test_top` | 440 Hz 生死线自检 | 不需要（**但会一直响**） |
| `chord_demo_top` | **自动演示**：单音→三和弦→七和弦→音阶，每轮换一种音色 | 不需要 |
| `synth_board_top` | 2 键版（板载按键 87/88） | 不需要 |
| `synth_board12_top` | **12 键正式版** | 需要 12× TTP223 |

---

## 四、代码规模

| 类别 | 文件数 | 行数 |
|---|---|---|
| RTL（`code/rtl`） | 17 | 2030 |
| 测试台（`code/sim`） | 15 | 2159 |
| **合计** | **32** | **4189** |

> 测试台比 RTL 还多 —— 接近 1.06:1 的测试代码比，是本项目最值得保留的工程习惯。

**遗留待清理**：`sim/tb_diag.v`、`tb_diag2.v`、`tb_diag3.v`（共 133 行）是早期调试残留，
不在任何测试套件里，建议后续删除。

---

## 五、资源占用（`synth_board12_top`，GW2AR-18）

| 资源 | 用量 | 占用率 |
|---|---|---|
| Logic（LUT/ALU） | 2061 / 20736 | **10%** |
| ↳ LUT | 1744 | — |
| ↳ ALU | 317 | — |
| Register | 841 / 15750 | **6%** |
| CLS | 1199 / 10368 | 12% |
| I/O Port | 23 / 66 | 35% |
| DSP（MULT18X18） | 4 / 24 | **9%** |
| BSRAM | 0 | 0% |

**结论：资源极其充裕。** LUT 只用了 10%，DSP 9%，**BSRAM 完全没用**。
这意味着还有很大空间做：
- 提高复音数（4 → 8/16）
- 加混响/延时（正好用 BSRAM）
- 加 wavetable 音色（用 BSRAM 存波形表）
- 第二交互维度

---

## 六、验证矩阵

### 仿真：10 / 10 全部通过

| # | 测试台 | 覆盖内容 |
|---|---|---|
| 1 | `tb_i2s_tx` | BCK 周期、LRCK 64 BCK、采样率 52734.4 Hz、MSB-first 数据流 |
| 2 | `tb_note_alloc` | 单音分配、释放、复音 4、占满抢占、重复按键不占新声部 |
| 3 | `tb_adsr` | ATTACK 单调递增、DECAY 到 SUS、SUSTAIN 稳定、RELEASE 归零 |
| 4 | `tb_synth_top` | 复位静音、单音幅度、复音幅度、逐个释放、I2S 活动 |
| 5 | `tb_tone_test` | 音高（439.86 Hz，误差 < 0.25%）、I2S 持续输出 |
| 6 | `tb_synth_board` | 板级：按键→发声→停声、音阶步进回绕、**功放门控双向** |
| 7 | `tb_led_ctrl_top` | LED 模式切换与回绕 |
| 8 | `tb_key_scan` | 12 键扫描、和弦事件不重不漏 |
| 9 | `tb_synth_board12` | 12 键板级集成：静音→单音→余韵→和弦→I2S/功放 |
| 10 | **`tb_key12_notes`** | **12 键映射 + 和弦 + 回归场景（中途插键）+ note-off** |

### 硬件：部分验证

| 项 | 状态 |
|---|---|
| JTAG 链路 | ✅ 已验证（扫到 GW2AR-18C） |
| 命令行烧录 | ✅ 已验证（SRAM Program 4.4 s） |
| `tone_test_top` 上板 | ✅ **已验证（440 Hz 出声 + LED 心跳）** |
| 合成器上板（`synth_board12`） | ⚠️ **未验证**（板子过热后拔下） |
| `chord_demo` 上板 | ⚠️ 未验证 |
| 12× TTP223 接线 | ⚠️ 未验证 |
| `pa_en` 门控实际降温效果 | ⚠️ 未验证 |

---

## 七、引脚分配（已逐条核对引脚图）

### 12 路触摸键

| key | 音名 | 引脚 | 排针位置 | IO |
|---|---|---|---|---|
| `key[0]` | C4 | 27 | 左 | IOB8A |
| `key[1]` | C#4 | 28 | 左 | IOB8B |
| `key[2]` | D4 | 29 | 左 | IOB14A |
| `key[3]` | D#4 | 30 | 左 | IOB14B |
| `key[4]` | E4 | 31 | 左 | IOB29A |
| `key[5]` | F4 | **26** | 左 | IOB6B |
| `key[6]` | F#4 | 41 | 右 | IOB43A |
| `key[7]` | G4 | 42 | 右 | IOB42B |
| `key[8]` | G#4 | 48 | 右 | IOR49B |
| `key[9]` | A4 | 77 | 左 | IOT30A |
| `key[10]` | A#4 | 79 | 右 | IOT27B |
| `key[11]` | B4 | 25 | 左 | IOB6A |

> ⚠️ **接线注意**：`key[11]=25` 与 `key[5]=26` 物理相邻，容易搞混。
> 12 个键分散在**左右两排**（左 8 个、右 4 个），做钢琴键盘布局时要留意走线。

### 音频与其它

| 信号 | 引脚 | 说明 |
|---|---|---|
| `clk` | 4 | 板载 27 MHz |
| `i2s_din` | 54 | → MAX98357A（**SSPI 专用脚，需 use_sspi_as_gpio**） |
| `i2s_lrck` | 55 | 同上 |
| `i2s_bck` | 56 | 同上 |
| `pa_en` | 51 | 功放使能（现由门控驱动） |
| `led[0..5]` | 15~20 | 低电平点亮 |

---

## 八、风险与缺口

按严重程度排序：

| # | 风险 | 严重度 | 说明 |
|---|---|---|---|
| 1 | **第二交互维度完全缺失** | 🔴 **高** | 比赛硬性要求 ≥2 维交互，目前**只有按键这一维**。这是项目最大的缺口 |
| 2 | 12 键版从未上板 | 🟠 中 | 仿真全过，但 TTP223 极性、实际手感、引脚焊接都没验证 |
| 3 | 板子过热后状态未知 | 🟠 中 | `pa_en` 门控已修，但需上板验证是否解决；若 BL616 受损则需换板 |
| 4 | 第二维度硬件未到位 | 🟠 中 | 红外模块情况未知 |
| 5 | `ACTIVE_LOW` 假设未实测 | 🟡 低 | 假设 TTP223 按下为高，若实际相反需改一个参数 |
| 6 | 音色仍偏"电子" | 🟡 低 | 目前是基础波形，缺少包络精修与滤波 |

---

## 九、下一步建议

**优先级 1 —— 补第二交互维度**（不依赖板子可先做一半）

```
红外传感器 → gesture_ctrl（待写）→ wave_sel / 其它控制量
```

`osc_voice` 的 `wave_sel[1:0]` 端口**已经预留好**，`gesture_ctrl` 接上即可实现"挥手切音色"。
可以先把 RTL + 仿真做完，硬件到了直接接线。

**优先级 2 —— 12 键上板验证**

板子恢复后：
```powershell
cd D:\harness\fpga-synth-engine\code\synth
.\build.ps1 -Target synth_board12 -Program sram
```
先只接 1 个 TTP223 到 `key[0]`（引脚 27）验证极性，再铺开 12 个。

**优先级 3 —— 清理与打磨**

- 删除 `tb_diag*.v` 遗留文件
- `iterations/` 目录整理（散落的 `.v` 文件应收进对应快照）
- ADSR 起音加长（当前 0.61 ms 偏快，有轻微瞬态）

---

## 十、beta.2 附带的比特流

发布附件包含已构建的 `synth_board12.fs`（4.41 MB），可直接烧录：

```powershell
$env:GOWINHOME = 'D:\Gowin\Gowin_V1.9.11.03_Education_x64'
& "$env:GOWINHOME\Programmer\bin\programmer_cli.exe" `
    --device GW2AR-18C --operation_index 2 --fsFile synth_board12.fs
```

`operation_index`：**2** = SRAM（掉电即失），**9** = 写外部 Flash（掉电保持）。

---

*本文档由项目组维护。数据来源：`build/synth_board12/impl/pnr/synth_board12.rpt.txt`、`code/run_sim_all.ps1` 实测输出。*
