M3-Grant/fpga-synth-engine/docs/02-制作周期详细排期.md

# 02 · 制作周期详细排期

> 每个任务都标了验收标准。**做不到验收标准就不要进下一步**——这是零基础团队最重要的纪律。
> 符号说明：🔴 P0 必须 ｜ 🟠 P1 加分 ｜ 🟡 P2 有余力

---

# W1（09-22 ~ 09-28）环境 + I2S 出声
## 🔴 生死线：本周末必须让耳机响

| 天 | 任务 | 验收标准 |
|---|---|---|
| D1 | 确认报名已提交；勾选高云免费板卡申请；在高云官方群（213923272）确认板卡是否满足选题二要求 | 报名状态确认；群里得到答复 |
| D1 | 下单第 1 批硬件（见 `04-硬件采购清单.md`） | 订单已下 |
| D2 | 下载安装 **Gowin 云源软件教育版 V1.9.11.03 For Win**（422MB），勾选 GW2A/GW2AR 器件库 | 软件能打开，器件列表有 GW2AR-18 |
| D2 | 下载安装 **云源编程器教育版**（85MB） | Programmer 能打开 |
| D3 | 跑通官方 LED 例程（`vendor-docs/blink_led`），走完整流程 | 板上 LED 闪烁 |
| D4 | 独立重做一遍（不照抄）：新建工程→加 Verilog→加 `.cst`→综合→布线→码流→下载 | 能独立走完 |
| D5 | DAC 模块到货后接线：BCK / LRCK / DIN / VIN / GND，**注意共地** | 接线完成，用万用表确认无短路 |
| D6 | 写第一版 I2S 发送模块，输出**固定频率方波** | **耳机听到持续单音** ← 生死线 |
| D7 | 缓冲；若未出声，启动风险预案 | — |

**本周末的产出**：耳机里响着固定频率的方波。

> ⚠️ 如果 D7 结束还没有声音：不要继续往下做，先把 I2S 调通。这是整个项目的地基，也是唯一会让方案整体失败的点。

---

# W2（09-29 ~ 10-05）单振荡器（DDS）
## 🔴 目标：440Hz 正弦波，频谱可见主峰

| 天 | 任务 | 验收标准 |
|---|---|---|
| D1 | 用 Python 生成正弦波形表 ROM 初始化文件（1024 点 × 12bit，`.mi` 格式） | 文件生成，内容可读 |
| D1 | 在 Gowin 里实例化波形 ROM（IP Core 或 `$readmemh`） | 综合通过 |
| D2 | 实现**相位累加器**：32 位，每个采样周期加 FCW | 仿真波形正确 |
| D3 | 相位高位 → ROM 地址 → 取出样本 → 送 I2S | 仿真输出正弦序列 |
| D4 | 上板：输出固定 440Hz | **手机频谱 App 显示 440Hz 主峰** |
| D5 | 参数化 FCW，试不同频率（220 / 440 / 880Hz） | 频率准确，误差 <1% |
| D6 | 加一个简单音量控制（移位实现） | 音量可调，不爆音 |
| D7 | 复盘：把 I2S + DDS 封装成可复用模块，加注释 | 模块接口清晰，可被其他模块调用 |

**产出**：能输出任意标准音高正弦波的振荡器。

---

# W3（10-06 ~ 10-12）音符映射 + 2 维交互
## 🔴 目标：能弹音阶，两个独立维度可用

| 天 | 任务 | 验收标准 |
|---|---|---|
| D1 | 建立音符→FCW 查找表（至少 1 个八度，12 个半音） | 表中数值经计算验证 |
| D2 | 板载按键（引脚 87）映射到音符 | 按键能改变音高 |
| D3 | **交互维度 1**：自制电容触摸（RC 充放电 + 计数器测时间） | 手指触摸能触发，不误触 |
| D4 | 触摸做成 4–8 个音符键位 | 不同键位发不同音 |
| D5 | **交互维度 2**：光电感应或第二组触摸/按键 | 第二个维度独立可控 |
| D6 | 两个维度组合使用（如：一个选音、一个控制音量或音色） | 组合逻辑正确，不互相干扰 |
| D7 | 能弹一段简单旋律 | 录视频为证 |

**产出**：能弹奏的简易电子琴。

---

# W4（10-13 ~ 10-19）ADSR 包络
## 🔴 目标：声音有起音/衰减/保持/释放

| 天 | 任务 | 验收标准 |
|---|---|---|
| D1 | 设计 ADSR 状态机（4 段 + IDLE） | 状态转换图清晰 |
| D2 | 实现 Attack（音量 0→最大，可调时长） | 听到渐强起音 |
| D3 | 实现 Decay（最大→保持电平） | 听到衰减 |
| D4 | 实现 Sustain（保持）+ Release（松开后衰减到 0） | 松键后声音自然消失，不硬切 |
| D5 | 包络值用**移位加法**实现（避免占用 DSP） | 综合报告显示 DSP 占用低 |
| D6 | 参数可调（4 段时长各 2–4 档） | 能切换不同包络 |
| D7 | 对比有无包络的听感差异，录视频 | 差异明显 |

**产出**：具备 ADSR 的音色，听感明显改善。

> 💡 本项直接影响评分中"ADSR 包络调控"这一条，也是"听起来像乐器"的关键。

---

# W5（10-20 ~ 10-26）复音 4（架构定型）
## 🔴 目标：同时 4 音，频谱 4 个独立谱峰

| 天 | 任务 | 验收标准 |
|---|---|---|
| D1 | **把振荡器改成 `parameter VOICE_NUM` + `generate`** | 改一个数字就能改复音数 |
| D1 | 波形 ROM 改为**全阵列共享** | 综合报告 BSRAM 占用不随复音数线性增长 |
| D2 | 实现音符分配器：note-on 时找空闲声部，note-off 时释放 | 仿真验证分配逻辑 |
| D3 | 实现声部仲裁（超出复音数时的抢占策略） | 不出现"卡音" |
| D4 | 实现**混音加法树**（流水线 + 饱和处理） | 多音同时响不失真 |
| D5 | 复音 4 上板调试 | **同时按 4 键，频谱出现 4 个独立谱峰** |
| D6 | 加**测试模式**（一键输出 N 路不同频率，用于合规自证） | 测试模式下频谱峰数 = 复音数 |
| D7 | 时序检查：看综合报告，确认无时序违例 | 无 setup/hold 违例 |

**产出**：复音 4 的合成器 —— **这是省赛最小可交付版本**。

> ⚠️ 本周是整个项目的架构定型周。如果 D7 复音 4 仍不稳定，省赛就交付到 W3 的水平（简易电子琴），并把复音放到国赛。

---

# W6（10-27 ~ 11-04）扩展 + 音色 + 提交
## 🔴 11-04 18:00 省赛提交

| 天 | 任务 | 验收标准 |
|---|---|---|
| D1 | 🟠 复音从 4 扩到 8 | 频谱 8 个峰 |
| D2 | 🟠 加 ≥2 种音色（多存一套波形表或改参数） | 能切换音色，听感不同 |
| D3 | 🟠 加 ≥3 维表情（如滑音/颤音/力度） | 三个维度都可演示 |
| D4 | **功能冻结**（只修 bug，不加新功能） | — |
| D4 | 综合实现报告（LUT/FF/BSRAM/DSP、时钟频率、时序是否收敛） | 报告导出 |
| D5 | 设计报告（选题背景、架构、软硬件划分、实测数据、失败分析、复现说明） | 文档完整 |
| D5 | 演示视频（3 分钟以内，含测试模式频谱演示） | 视频可播放 |
| D6 | 材料打包：源码 + 约束 + 脚本 + 报告 + 视频；**文件名全用英文小写** | 检查无中文文件名 |
| D6 | 连续运行测试（10 分钟不出错、不失真） | 无死机 |
| D7 | **提交** | 上传成功 |

**产出**：省赛完整提交包。

---

# W7（11-05 ~ 11-11）复音冲刺
## 🟠 目标：复音 ≥16

| 天 | 任务 | 验收标准 |
|---|---|---|
| D1–D2 | 复音 8 → 16，观察资源占用 | 综合通过，资源不超 |
| D3 | 若时序不收敛：降低采样率到 24kHz 或改用时分复用 | 时序收敛 |
| D4–D5 | 复音 16 上板验证 | 频谱 16 个峰 |
| D6–D7 | 尝试 32（资源允许则保留，不允许退回 16） | 记录实测上限 |

---

# W8（11-12 ~ 11-19）表情与效果器
## 🟠 决赛前最后打磨

| 天 | 任务 | 验收标准 |
|---|---|---|
| D1–D2 | 硬件效果器：延迟（用板载 64Mbit SDRAM 做延迟线） | 能听到延迟效果 |
| D3–D4 | 🟡 视听反馈：HDMI 输出实时频谱或李萨如图形 | 屏幕显示与声音同步 |
| D5 | 完善 ≥3 维表情控制 | 演示流畅 |
| D6 | 现场演示演练（至少 3 遍） | 全流程无卡顿 |
| D7 | 答辩材料、备用方案准备 | 能回答高频问题 |

---

# W9（11-20 ~ 11-22）决赛
- 现场演示（含测试模式自证合规）
- 答辩：重点讲清 FPGA 承担的核心作用、振荡器计数口径、RTL 证据位置
- 准备备份：备用 DAC、备用线材、录音文件（万一现场音响有问题）

---

# W10（决赛后）复盘归档
- 代码整理、注释补全
- 提炼可复用 Skill（题目拓展项鼓励这个）
- 经验总结（供下届参考）

---

## 附：每周检查清单

每周日回答以下问题，答"否"就调整计划：

- [ ] 本周的产出能**上板演示**吗？
- [ ] 有没有引入**新的技术风险**？
- [ ] 代码有没有进版本管理？
- [ ] 文档素材（截图/波形/视频）有没有存档？
- [ ] 距离下一个关键节点还有几天？来得及吗？
- [ ] 有没有该砍但还没砍的功能？
