M3-Grant/fpga-synth-engine/docs/assets/spectrum.png

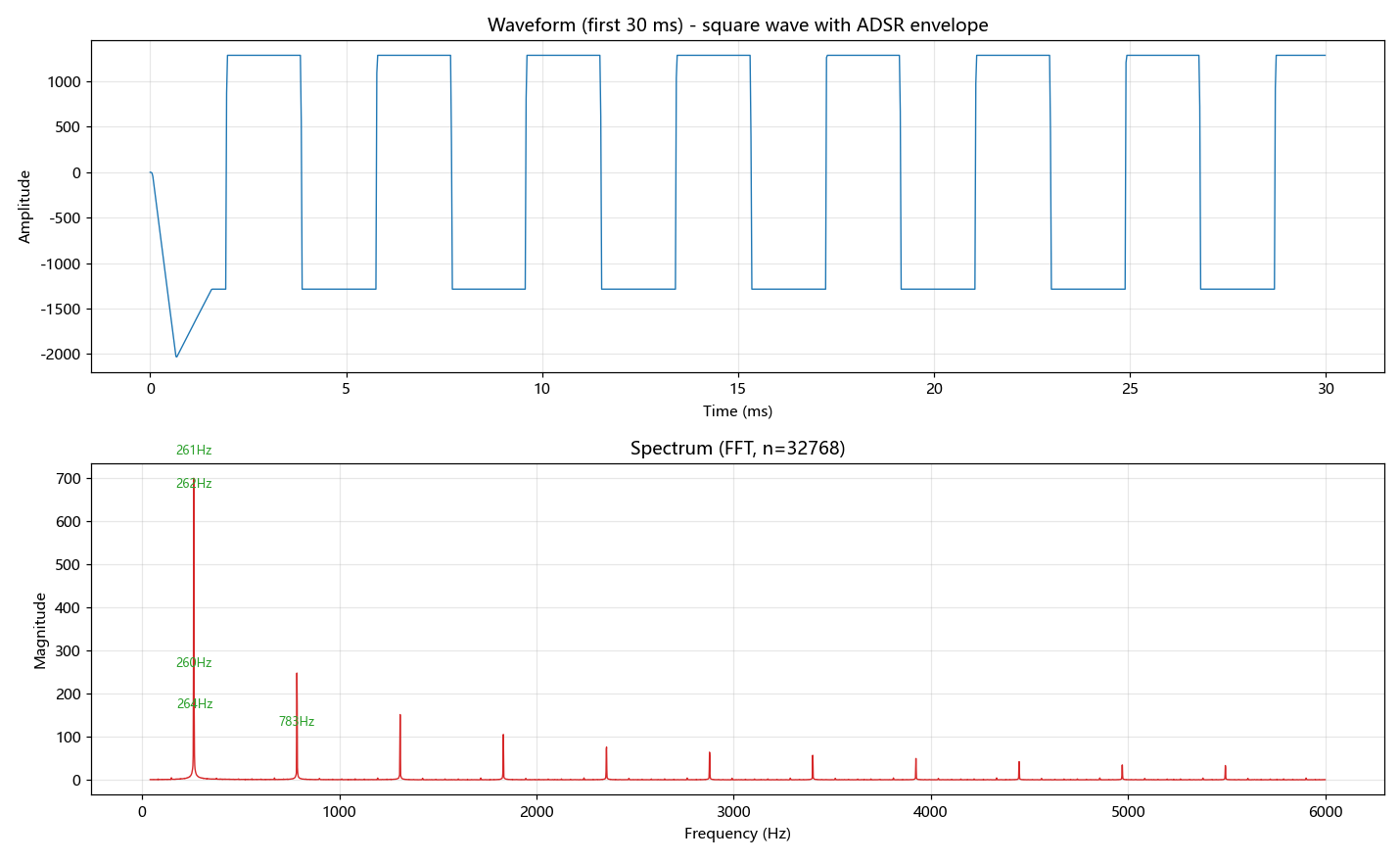
docs/assets/spectrum.png
