M3-Grant/fpga-synth-engine/host_viz/screenshots/preview_flat_keys.png

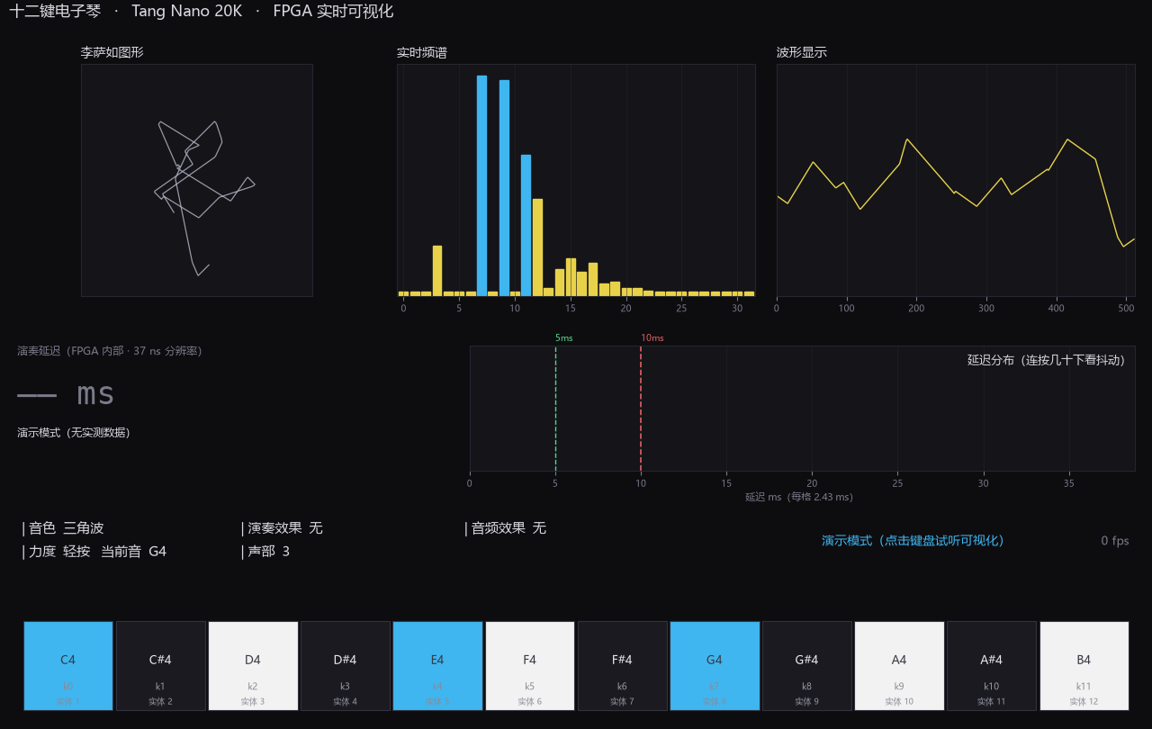
host_viz/screenshots/preview_flat_keys.png
