M3-Grant/fpga-synth-engine/host_viz/screenshots/界面预览.png

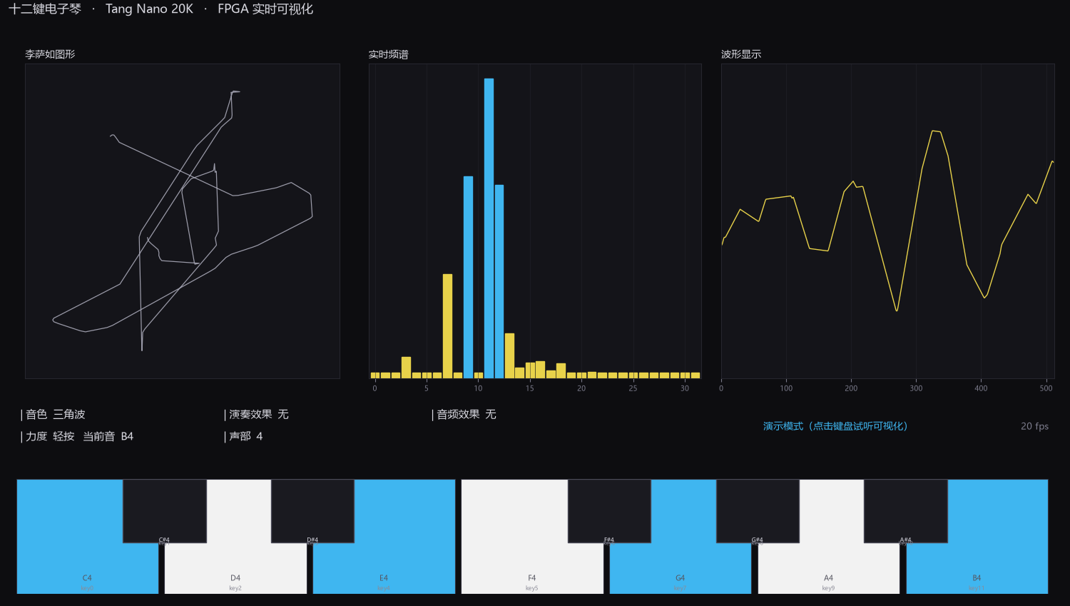
host_viz/screenshots/界面预览.png
