M3-Grant/fpga-synth-engine/docs/03-项目清单.md

# 03 · 项目清单

> 可直接当检查表用。括号内标注的是优先级：🔴 必须 ｜ 🟠 加分 ｜ 🟡 有余力

---

## 一、硬件清单

### 1.1 已有
- [x] Sipeed Tang Nano 20K 开发板（GW2AR-LV18QN88C8/I7）🔴
- [x] Type-C 数据线（**必须支持数据传输**）🔴
- [x] 电脑（Windows）🔴

### 1.2 第 1 批 · 出声必需（约 30–65 元）🔴

| 物品 | 型号建议 | 预算 | 状态 |
|---|---|---|---|
| I2S DAC 模块 | **PCM5102A**（确认是 3 线、不需 MCLK 版本） | 20–50 元 | [ ] |
| 杜邦线 | 母对母、公对母各一扎 | 10–15 元 | [ ] |
| 耳机 | 3.5mm，32Ω 左右 | 家里有 | [ ] |
| 小音箱（备选） | 3.5mm 输入 | 家里有 | [ ] |

### 1.3 第 2 批 · 交互（约 40–80 元）🔴🟠

| 物品 | 型号建议 | 预算 | 用途 | 状态 |
|---|---|---|---|---|
| 铜箔胶带 / 覆铜板 | — | 10–20 元 | 自制电容触摸电极 | [ ] |
| 1MΩ 电阻 | 若干 | 5 元 | RC 充放电 | [ ] |
| 轻触按键 | 6–8 个 | 5–10 元 | 备用音符键 | [ ] |
| 光电对管 | 红外发射+接收 | 10–20 元 | 第二维交互 / 琴键检测 | [ ] |
| 面包板 | 一块 | 10–20 元 | 搭电路 | [ ] |

### 1.4 第 3 批 · 力度与表情（约 30–70 元）🟠

| 物品 | 型号建议 | 预算 | 用途 | 状态 |
|---|---|---|---|---|
| 力敏电阻 FSR | 或压电片 | 15–40 元 | 力度感应（第 3 维） | [ ] |
| ADC 模块 | ADS1015 / MCP3008 | 15–30 元 | **GW2AR-18 无内置 ADC，模拟量必需** | [ ] |
| 霍尔传感器 + 磁铁 | A3144 等 | 10–20 元 | 滑音轮 / 摇杆 | [ ] |

### 1.5 第 4 批 · 机械结构（约 80–150 元）🟡
> 这是发挥你们机械专业优势的部分，建议放到国赛阶段

| 物品 | 用途 | 预算 | 状态 |
|---|---|---|---|
| 铝型材 / 亚克力板 | 琴键与支撑结构 | 30–60 元 | [ ] |
| 弹簧、轴承、螺丝 | 杠杆回弹机构 | 20–40 元 | [ ] |
| 3D 打印件 | 键帽、杠杆、支架 | 按学校资源 | [ ] |
| 光电对管（补充） | 无接触琴键检测 | 10–20 元 | [ ] |

### 1.6 第 5 批 · 显示（可选）🟡

| 物品 | 说明 | 预算 | 状态 |
|---|---|---|---|
| HDMI 线 + 带 HDMI 输入的显示器/电视 | Tang Nano 20K 板载 HDMI 输出 | 家里有则省 | [ ] |

> ⚠️ Tang Nano 20K 的 HDMI 是 **TMDS 输出**，**不能直接接 VGA 显示器**（模拟信号）。需 HDMI 显示设备或转接器。

### 1.7 调试工具

| 物品 | 必需性 | 状态 |
|---|---|---|
| 手机频谱 App（如 Spectroid / Advanced Spectrum Analyzer） | 🔴 免费，**合规自证要用** | [ ] |
| 逻辑分析仪（可选，30–80 元） | 🟠 抓 I2S 时序很有用 | [ ] |
| 示波器（实验室借） | 🟠 有会快很多 | [ ] |
| 万用表 | 🟠 检查接线 | [ ] |
| USB 声卡（可选，30–60 元） | 🟡 把声音采回电脑分析 | [ ] |

**硬件预算汇总**

| 版本 | 新增预算 | 含板卡总计 |
|---|---|---|
| 基础（出声+按键） | 40–80 元 | 240–380 元 |
| 进阶（+触摸+力度） | 110–180 元 | 310–480 元 |
| 完整（+机械+显示） | 190–330 元 | 390–630 元 |

---

## 二、软件清单

| 软件 | 用途 | 获取方式 | 状态 |
|---|---|---|---|
| **Gowin 云源软件教育版 V1.9.11.03 For Win** | 综合、实现、下载（422MB） | 高云官网手动下载 | [ ] |
| **Gowin Programmer 教育版** | 下载码流（85MB） | 高云官网 | [ ] |
| **Icarus Verilog** | 仿真验证 | ✅ **已安装** `D:\Tools\iverilog\bin` | [x] |
| **GTKWave** | 看仿真波形 | ✅ 随 iverilog 已装 | [x] |
| Gowin 在线逻辑分析仪（GAO） | 抓内部信号看波形 | 随 EDA 自带 | [ ] |
| Python | 生成波形表 ROM 文件 | 系统已有 Python 3.14 | [x] |
| Git | 版本管理 | ✅ 已有 2.53.0 | [x] |
| 串口助手 | 调试输出 | 任选（MobaXterm / PuTTY） | [ ] |

**软件下载地址**
- Gowin 教育版：https://www.gowinsemi.com.cn/software/3 （需登录）
- iverilog 官方：https://bleyer.org/icarus/ （已装好，无需再下）

---

## 三、Verilog 模块清单（代码资产）

### 3.1 已实现并验证 ✅

| 模块 | 文件 | 状态 | 乐器方案用途 |
|---|---|---|---|
| 时钟分频 | `clk_div.v` | ✅ 仿真通过 | 产生 48kHz 采样使能 |
| 按键消抖 | `debounce.v` | ✅ 仿真通过 | 交互输入 |
| PWM | `pwm.v` | ✅ 仿真通过 | 备用（如做模拟输出测试） |

### 3.2 待实现（乐器方案核心）

| 模块 | 文件 | 优先级 | 功能 | 验收 |
|---|---|---|---|---|
| **I2S 发送** | `i2s_tx.v` | 🔴 W1 | BCK/LRCK/DIN 三线时序，串行输出 | 耳机出声 |
| **波形表 ROM** | `wave_rom.v` | 🔴 W2 | 1024 点 × 12bit，多种波形 | 输出正弦 |
| **相位累加器** | `phase_acc.v` | 🔴 W2 | 32 位累加，FCW 控制频率 | 频率准确 |
| **单振荡器** | `osc.v` | 🔴 W2 | 相位累加 + 查表 + 包络 | 输出单音 |
| **音符表** | `note_table.v` | 🔴 W3 | 音符 → FCW 映射 | 音阶正确 |
| **电容触摸** | `cap_touch.v` | 🔴 W3 | RC 充放电计时检测 | 触摸响应 |
| **ADSR 包络** | `adsr.v` | 🔴 W4 | 四段包络，移位实现 | 听感自然 |
| **音符分配器** | `note_alloc.v` | 🔴 W5 | note-on/off、声部仲裁 | 不卡音 |
| **振荡器阵列** | `voice_array.v` | 🔴 W5 | `generate` 生成 N 个振荡器 | 改参数即改复音 |
| **混音器** | `mix_tree.v` | 🔴 W5 | 流水线加法 + 饱和 | 不失真 |
| **测试模式** | `test_mode.v` | 🔴 W5 | 输出 N 路等间隔频率 | 频谱 N 个峰 |
| 音色切换 | `timbre_sel.v` | 🟠 W6 | 切换波形表/参数 | ≥2 音色 |
| 表情控制 | `expression.v` | 🟠 W6 | 滑音/颤音/力度 | ≥3 维 |
| 延迟效果器 | `delay_fx.v` | 🟠 W8 | SDRAM 延迟线 | 听到延迟 |
| 混响效果器 | `reverb_fx.v` | 🟡 W8 | 多抽头延迟 | 听到混响 |
| HDMI 频谱显示 | `spectrum_disp.v` | 🟡 W8 | FFT 或简易频谱 + HDMI 输出 | 屏幕显示 |
| 顶层整合 | `synth_top.v` | 🔴 W5 | 例化所有模块 | 整体工作 |

### 3.3 测试平台清单

| 测试平台 | 验证内容 | 优先级 |
|---|---|---|
| `tb_i2s_tx.v` | BCK/LRCK/DIN 时序关系 | 🔴 W1 |
| `tb_osc.v` | 相位累加、频率计算正确性 | 🔴 W2 |
| `tb_adsr.v` | 四段包络时间常数 | 🔴 W4 |
| `tb_note_alloc.v` | 声部分配与仲裁 | 🔴 W5 |
| `tb_mix_tree.v` | 混音饱和处理 | 🔴 W5 |
| `tb_synth_top.v` | 顶层集成仿真 | 🔴 W6 |

---

## 四、文档清单（交付物）

| 文档 | 内容 | 优先级 | 状态 |
|---|---|---|---|
| **设计报告** | 选题背景、系统架构、软硬件划分、实现方法、实测结果、失败分析、复现说明 | 🔴 | [ ] |
| **系统架构图 + 数据流图** | 必须提交，且是评分点 | 🔴 | [ ] |
| **综合与实现报告** | LUT/FF/BSRAM/DSP 占用、时钟频率、时序收敛状态 | 🔴 | [ ] |
| **振荡器计数说明** | 统计口径、当前复音数、RTL 证据位置（**合规自证关键**） | 🔴 | [ ] |
| **交互方案说明** | 两个（或更多）维度的实现原理 | 🔴 | [ ] |
| **测试数据** | 延迟测量、频谱截图（N 个峰）、资源占用 | 🔴 | [ ] |
| **演示视频** | 3 分钟以内，含测试模式频谱演示 | 🔴 | [ ] |
| **README** | 项目简介 + 复现步骤（英文小写文件名） | 🔴 | [ ] |
| 复现说明 | 他人从零开始的操作步骤 | 🔴 | [ ] |
| Skill 提炼（可选） | 可复用经验（题目拓展项鼓励） | 🟡 | [ ] |

---

## 五、技能学习清单

> 只学这些，别的一概不碰。

| 技能 | 用途 | 学习方式 | 状态 |
|---|---|---|---|
| Gowin EDA 全流程 | 综合/布线/下载 | 跑官方例程 | [ ] |
| `.cst` 约束文件语法 | 引脚分配 | 改官方例程对照 | [ ] |
| Verilog 最小子集 | 编码基础 | 7 个语法点（见下） | [ ] |
| 三段式状态机 | ADSR、分配器、控制 | 官方例程 + 练习 | [ ] |
| I2S 时序 | 音频输出 | 看协议时序图 | [ ] |
| DDS 原理 | 频率合成 | 理解 FCW 公式 | [ ] |
| ROM/IP 例化 | 波形表 | Gowin IP Core 向导 | [ ] |
| 在线逻辑分析仪 GAO | 调试 | 官方文档 SUG114 | [ ] |
| 定点数运算 | 包络、混音 | 位宽与移位 | [ ] |

**Verilog 最小子集（只需要这 7 个）**
1. `module` / 端口方向
2. `wire` / `reg`
3. `assign`
4. `always @(posedge clk)`
5. `=` 与 `<=` 的区别
6. `if / else` / `case`
7. 计数器、移位、位拼接

**推荐官方文档**
- SUG949 Gowin HDL 编码风格用户指南
- SUG114 Gowin 在线逻辑分析仪用户指南
- SUG550 GowinSynthesis 用户指南

---

## 六、周检查表模板

每周日填写：

```
周次：W__
本周目标：
实际完成：
能否上板演示：是 / 否
遇到的问题：
下周计划：
需要砍掉的功能：
```

---

## 七、总进度追踪

| 里程碑 | 计划完成 | 实际完成 | 状态 |
|---|---|---|---|
| 环境搭建完成 | W1 | | [ ] |
| **I2S 出声** | W1 | | [ ] |
| 单振荡器 440Hz | W2 | | [ ] |
| 2 维交互可弹奏 | W3 | | [ ] |
| ADSR 包络 | W4 | | [ ] |
| **复音 4（省赛最小交付）** | W5 | | [ ] |
| 测试模式自证合规 | W5 | | [ ] |
| **省赛提交** | W6 / 11-04 | | [ ] |
| 复音 ≥16 | W7 | | [ ] |
| 效果器 + 表情 | W8 | | [ ] |
| **决赛** | W9 / 11-20 | | [ ] |
