M3-Grant/fpga-synth-engine/iterations/demo0.0.2/清单.md

# demo0.0.2 存档快照

> 存档时间：2026-10-08
> 基线：demo0.0.1（单音、方波、无包络）
> 本轮成果：复音 4 + ADSR 包络

## 本轮新增模块（复音架构）

| 文件 | 功能 |
|---|---|
| osc_voice.v | 单声部振荡器（DDS 相位累加 + 方波 + 包络调制） |
| oscillator_array.v | 振荡器阵列（generate 例化 N 份） |
| note_alloc.v | 音符分配器（note-on/off、复用、抢占） |
| mix_tree.v | 混音器（求和 + 饱和，防削波） |
| adsr.v | ADSR 包络发生器（四段状态机） |
| synth_top.v | 复音合成器顶层（整合全部链路） |

## 测试平台

| 文件 | 覆盖 |
|---|---|
| tb_note_alloc.v | 分配/释放/复音/抢占/重复按键（8 项） |
| tb_adsr.v | 四段包络时序与电平（11 项） |
| tb_synth_top.v | 完整链路集成（10 项） |

## 验证结果

- note_alloc：8/8 PASS
- adsr：11/11 PASS
- synth_top 集成：10/10 PASS
- 一键脚本 run_sim_all.bat：6 套全部通过

## 关键指标

| 指标 | 实测 |
|---|---|
| sample_req 间隔 | 512 clk |
| 采样率 fs | 52734.375 Hz |
| 复音数 | 4（可参数化扩展） |
| SUSTAIN 电平 | 160/255 |
| 单音输出幅度 | ~1160 |
| 复音 4 输出幅度 | ~3576 |

## 说明

本目录仅为「本轮新增文件」快照，便于离线取用。
完整可运行代码在仓库根目录 code/，
完整迭代说明见 docs/iterations/。

对应 Git 标签：demo0.0.2
