M3-Grant/fpga-synth-engine/docs/assets/spectrum_verify.png

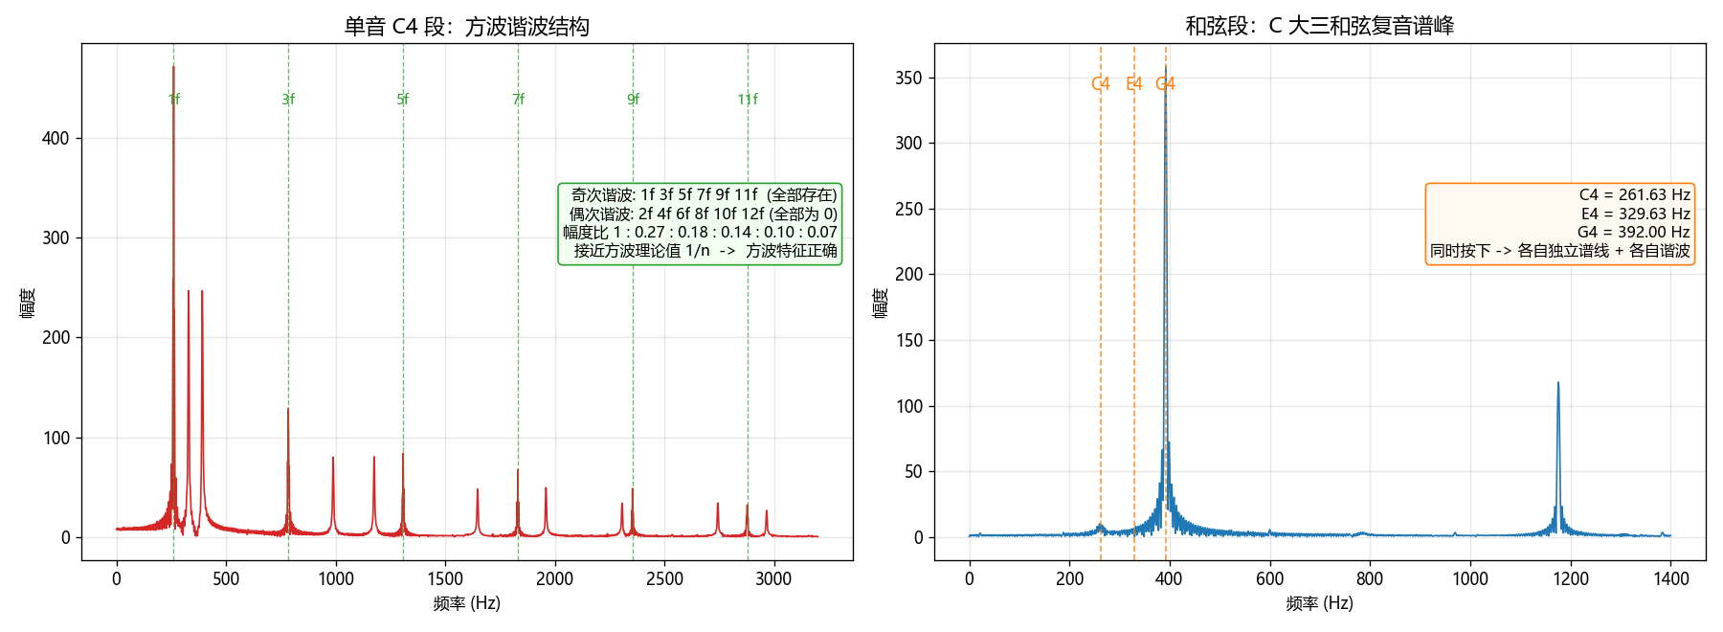
docs/assets/spectrum_verify.png
