M3-Grant/fpga-synth-engine/code/rtl/synth_top.v

// ============================================================================
//  模块名  : synth_top.v
//  功能    : 复音合成器顶层 —— 把分配器/振荡器阵列/混音器/I2S 串成完整链路
//  板卡    : Sipeed Tang Nano 20K (GW2AR-18)，主时钟 27 MHz
//
// ── 数据流（两条音色通路）──────────────────────────────────────────
//   音符事件 → note_alloc → 声部音符索引
//                 ↓
//             note_table（音符→FCW）
//                 ↓
//   ┌─────────────┴──────────────┐
//   ↓                            ↓
// oscillator_array              piano_engine
// （三角/方波/锯齿/脉冲）        （6 次谐波加法合成 + 钢琴衰减包络）
//   ↓                            ↓
// mix_tree（求和 + 饱和）        （内部已归一化 + 饱和）
//   ↓                            ↓
// mix_out[17:2]                  piano_audio
//   └─────────────┬──────────────┘
//                 ↓  （wave_sel == 3'b100 选钢琴）
//              audio_out → i2s_tx → DAC
//
// ── 音色选择（wave_sel[2:0]）─────────────────────────────────────
//   000 三角波  001 方波  010 锯齿  011 脉冲 25%  100 钢琴
//
// ── 迭代状态 ──────────────────────────────────────────────────────
//   迭代 1：复音 4 + 方波 + 可验证的分配逻辑
//   迭代 2：ADSR 包络
//   迭代 3：四种波形运行时切换、三角波、音量定档
//   迭代 4（2026-10-18）：钢琴音色 —— 6 次谐波加法合成 +
//           每谐波独立衰减包络（高次衰减快 → 音色由亮变暗）
// ============================================================================
module synth_top #(
    parameter VOICE_NUM  = 4,          // 复音数（改这里即可扩复音）
    parameter PHASE_BITS = 32,
    parameter USE_KS     = 0,      // 1 = 钢琴档改用 Karplus-Strong 拨弦
    parameter BCK_HALF   = 4,          // I2S BCK 半周期，决定 fs = 52734.375 Hz
    parameter AMP        = 16'sh2000,  // 单声部幅度
    parameter NOTE_BITS  = 5           // 音符索引位宽（0~24）
)(
    input  wire                    clk,       // 27 MHz
    input  wire                    rst_n,
    // ---- 音符事件输入 ----
    input  wire                    note_valid,
    input  wire                    note_on,
    input  wire [NOTE_BITS-1:0]    note_idx,
    // ---- 延音踏板抬起：立即释放所有声部 ----
    input  wire                    all_off,
    input  wire                    fade_soft,   // 1=松键渐弱 0=松键立即静音
    // ---- 延音踏板（2026-11-04）----
    //   sustain   : 1 = IR#1 遮挡，踏板踩着
    //   key_state : 12 个琴键的当前电平，用来判断"这个声部的键还按着吗"
    //               踩着踏板松手时，包络要走慢衰减而不是停在满音量
    input  wire                    sustain,
    input  wire [11:0]             key_state,
    // ---- 弱音踏板（IR#2，2026-11-04）----
    //   1 = 踩下：整体音量降到 1/4（-12 dB），模拟钢琴的 una corda 弱音
    input  wire                    soft_pedal,
    // ---- 音色控制 ----
    input  wire [2:0]              wave_sel,  // 音色：000三角 001方波 010锯齿 011脉冲 100钢琴
    // ---- I2S 输出 ----
    output wire                    i2s_bck,
    output wire                    i2s_lrck,
    output wire                    i2s_din,
    // ---- 调试观测口（综合时可忽略）----
    output wire [VOICE_NUM-1:0]    dbg_voice_busy,
    output wire signed [15:0]      dbg_mix,
    // ---- 给上位机串口用（可悬空）----
    output wire                    dbg_sample_req,
    output wire signed [15:0]      dbg_audio_out
);

    // ==================================================================
    // 1. 样本请求信号（由 i2s_tx 产生）
    // ==================================================================
    wire sample_req;

    // ==================================================================
    // 2. 音符分配器
    // ==================================================================
    wire [VOICE_NUM-1:0]              voice_busy;
    wire [VOICE_NUM*NOTE_BITS-1:0]    voice_note;
    wire [VOICE_NUM-1:0]              voice_trig;

    note_alloc #(
        .VOICE_NUM (VOICE_NUM),
        .NOTE_BITS (NOTE_BITS)
    ) u_alloc (
        .clk        (clk),
        .rst_n      (rst_n),
        .note_valid (note_valid),
        .note_on    (note_on),
        .note_idx   (note_idx),
        .all_off    (all_off),
        .voice_busy (voice_busy),
        .voice_note (voice_note),
        .voice_trig (voice_trig)
    );

    // ==================================================================
    // 3. 音符 → 频率控制字（每个声部一个查表）
    //    注意：note_table 是组合逻辑查表，VOICE_NUM 份并行例化
    // ==================================================================
    wire [VOICE_NUM*PHASE_BITS-1:0] voice_fcw;

    genvar g;
    generate
        for (g = 0; g < VOICE_NUM; g = g + 1) begin : gen_fcw
            note_table u_note (
                .note_idx (voice_note[g*NOTE_BITS +: NOTE_BITS]),
                .fcw      (voice_fcw[g*PHASE_BITS +: PHASE_BITS])
            );
        end
    endgenerate

    // ==================================================================
    // 4. ADSR 包络（每声部一份，独立控制）
    //    触发：voice_trig 是 note-on 瞬间的单周期脉冲
    //    门控：gate = 1 表示该声部应持续发声
    //         · 分配瞬间（trig）→ gate 置 1，触发 ATTACK
    //         · 声部释放（busy 落）→ gate 置 0，进入 RELEASE
    // ==================================================================
    wire [VOICE_NUM*8-1:0] voice_env;

    // 每个声部的琴键是否仍被按着：用该声部当前音符去查 key_state。
    // 12 键版 note_idx 恒在 0..11；越界时按 0 处理，避免 readmem 之外产生 x。
    wire [VOICE_NUM-1:0] voice_key_held;
    localparam [NOTE_BITS-1:0] KEY_MAX = 11;

    generate
        for (g = 0; g < VOICE_NUM; g = g + 1) begin : gen_held
            wire [NOTE_BITS-1:0] vn = voice_note[g*NOTE_BITS +: NOTE_BITS];
            assign voice_key_held[g] = (vn <= KEY_MAX) ? key_state[vn[3:0]] : 1'b0;
        end
    endgenerate

    generate
        for (g = 0; g < VOICE_NUM; g = g + 1) begin : gen_adsr
            adsr #(
                .ENV_BITS  (8),
                .SUS_LEVEL (8'd160),      // 持续电平（0.63 满幅，留混音余量）
                .ATK_STEP  (8'd8),        // 起音较快
                .DEC_STEP  (8'd2),
                .REL_STEP  (8'd3)         // 余韵约 50 个采样周期
            ) u_adsr (
                .clk       (clk),
                .rst_n     (rst_n),
                .sample_en (sample_req),
                .trig      (voice_trig[g]),   // note-on 脉冲（抢占时也会来，保证有音头）
                .note_on   (voice_busy[g]),   // 电平：只用来判断"松开"
                .gate      (voice_busy[g]),
                .fast_release(~fade_soft),
                .sustain   (sustain),         // 踏板踩着
                .key_held  (voice_key_held[g]),
                .env       (voice_env[g*8 +: 8])
            );
        end
    endgenerate

    // ==================================================================
    // 5. 振荡器阵列
    // ==================================================================
    wire [VOICE_NUM*16-1:0] voice_sample;

    oscillator_array #(
        .VOICE_NUM  (VOICE_NUM),
        .PHASE_BITS (PHASE_BITS),
        .AMP        (AMP)
    ) u_osc_array (
        .clk          (clk),
        .rst_n        (rst_n),
        .sample_en    (sample_req),
        .voice_fcw    (voice_fcw),
        .voice_env    (voice_env),
        .voice_gate   (voice_busy),
        .wave_sel     (wave_sel[1:0]),
        .voice_sample (voice_sample)
    );

    // ==================================================================
    // 6. 混音（输出 20 位有符号）
    // ==================================================================
    wire signed [19:0] mix_out;

    mix_tree #(
        .VOICE_NUM (VOICE_NUM),
        .IN_BITS   (16),
        .OUT_BITS  (20)
    ) u_mix (
        .clk        (clk),
        .rst_n      (rst_n),
        .sample_en  (sample_req),
        .samples_in (voice_sample),
        .mix_out    (mix_out)
    );

    // ==================================================================
    // 7. 钢琴音色引擎（2026-11-04 第二轮：恢复加法合成）
    //
    //    为什么又切回来：KS 的线性延迟线只能产生严格谐波 f_n = n·f0，
    //    那是"理想弦"（竖琴/吉他），永远不像钢琴。真钢琴弦有弯曲刚度，
    //    泛音被拉伸 f_n ≈ n·f0·sqrt(1+B·n²)，这是钢琴"金属味/厚度"的来源。
    //    KS 里塞色散全通可以逼近，但相位补偿与系数标定很难在听感上收敛；
    //    而 piano_engine 本来就是 6 谐波并行累加，把倍率表从整数改成
    //    n·sqrt(1+B n²) 即可**精确**实现这个公式（B = 3e-4）。
    //
    //    音色分工因此变成两条完全不同的合成路线：
    //      wave_sel = 4（钢琴）→ piano_engine  加法合成 + 非谐谐波 + 每谐波独立衰减
    //      wave_sel = 5（吉他）→ ks_array      Karplus-Strong 物理建模
    // ==================================================================
    wire signed [15:0] piano_audio;

    piano_engine #(
        .VOICE_NUM  (VOICE_NUM),
        .PHASE_BITS (PHASE_BITS),
        .HARM_NUM   (6),
        .TIMBRE     (0)                  // 0 = 钢琴
    ) u_piano (
        .clk        (clk),
        .rst_n      (rst_n),
        .sample_req (sample_req),
        .voice_fcw  (voice_fcw),
        .voice_trig (voice_trig),
        .voice_busy (voice_busy),
        .audio      (piano_audio)
    );

    // ==================================================================
    // 8. 输出选择
    //    · 老通路：20 位混音取 [15:0]（÷1）—— 2026-10-27 "声音太小"，
    //             依次从 [17:2] → [16:1] → [15:0] 提上来。
    //             4 声部最坏 30908 < 65536，不会溢出。
    // ==================================================================
    // ------------------------------------------------------------------
    // Karplus-Strong 拨弦通路（吉他专用）
    //   参数已冻结：(a+3b)/4 低通、三级低通激励、1/8 幅度、y>>5 衰减
    // ------------------------------------------------------------------
    wire signed [15:0] ks_audio;
    wire piano_mode = (wave_sel == 3'b100);
    wire ks_mode    = (wave_sel == 3'b101);

    ks_array #(
        .VOICE_NUM   (VOICE_NUM),
        .DUAL_VOICES (0),        // 吉他专用：全部单弦（钢琴不再走 KS，双弦白占资源）
        .PHASE_BITS  (PHASE_BITS),
        .DEPTH_LOG2  (9),
        .DECAY_SHIFT (8)
    ) u_ks (
        .clk        (clk),
        .rst_n      (rst_n),
        .sample_req (sample_req),
        .voice_note (voice_note),
        .voice_trig (voice_trig),
        .voice_busy (voice_busy),
        .piano_mode (piano_mode),
        .sustain    (sustain),
        .audio      (ks_audio)
    );

    // 音色选择：0~3 老波形（osc_voice→mix_tree），4 钢琴（加法合成），5 吉他（KS）
    wire signed [15:0] audio_raw = piano_mode ? piano_audio :
                                   ks_mode    ? ks_audio  :
                                                mix_out[15:0];

    // 弱音踏板（IR#2）：整体 -12 dB。放在最后一级，所有音色都吃得到。
    wire signed [15:0] audio_out = soft_pedal ? (audio_raw >>> 2) : audio_raw;

    // 引出给串口帧（dbg_ 端口，不接也不影响功能）
    assign dbg_sample_req = sample_req;
    assign dbg_audio_out  = audio_out;

    // ==================================================================
    // 8. I2S 发送
    // ==================================================================
    i2s_tx #(
        .DATA_BITS (16),
        .BCK_HALF  (BCK_HALF)
    ) u_i2s (
        .clk        (clk),
        .rst_n      (rst_n),
        .sample_l   (audio_out),
        .sample_r   (audio_out),
        .bck        (i2s_bck),
        .lrck       (i2s_lrck),
        .din        (i2s_din),
        .sample_req (sample_req)
    );

    // ==================================================================
    // 9. 调试观测口
    // ==================================================================
    assign dbg_voice_busy = voice_busy;
    assign dbg_mix        = audio_out;

endmodule
