M3-Grant/fpga-synth-engine/code/rtl/synth_board12_top.v

// ============================================================================
//  模块名  : synth_board12_top.v
//  功能    : 12 键电子琴板级顶层 —— 可直接上板演奏
//  板卡    : Sipeed Tang Nano 20K (GW2AR-18)，主时钟 27 MHz
//
//  ── 与 synth_board_top（2 键版）的区别 ────────────────────────────
//  2 键版：用状态机切换音阶，只能演示"逻辑通不通"
//  本版本：12 个按键各自对应一个音符，**能真正演奏**
//          12 键覆盖 C4~B4 一个完整八度（含全部半音）
//
//  ── 可演奏内容 ────────────────────────────────────────────────────
//      · 单音旋律（任意调式，因为半音齐全）
//      · 三和弦 / 七和弦（VOICE_NUM=4，最多四音同时）
//      · 简单双手配合
//
//  ── 按键器件 ──────────────────────────────────────────────────────
//  主用 TTP223 触摸模块（高电平有效，触摸=1）
//  也可用 6×6×5 微动开关（按接线调整 key_scan 的 ACTIVE_LOW）
//
//  ── LED 指示 ──────────────────────────────────────────────────────
//      led[0]   : 心跳闪烁（约 1.6Hz），证明逻辑在跑
//      led[1]   : 有音符在发声
//      led[2]   : 正在扫描/上报事件（调试用）
//
//  ── 音量（beta.2.1）───────────────────────────────────────────────
//  上板实测"按键声音偏小"，故把振荡器幅度从 3/16 满量程提到 3/8：
//      单声部稳态峰值 964 → 1928（+6 dB），单音/和弦均不削波。
//  推导与余量校核见下方 u_synth 的 AMP 参数注释。
//
//  作者    : 第三代 beta3
// ============================================================================
module synth_board12_top #(
    parameter VOICE_NUM  = 4,
    parameter NOTE_BITS  = 5,
    parameter BCK_HALF   = 4,
    parameter KEY_NUM    = 12,
    parameter KEY_CNT_MAX= 270_000,    // 消抖 10ms
    parameter IR_DEBOUNCE_CNT  = 540_000,   // 红外消抖 20ms
    parameter IR_MIN_SWIPE_CNT = 2_160_000, // 挥手最短 80ms（低于此判为误触）
    parameter IR_MAX_SWIPE_CNT = 32_400_000 // 挥手最长 1200ms（高于此判为遮挡）
)(
    input  wire               clk,        // 27 MHz，引脚 4
    input  wire [KEY_NUM-1:0] key,        // 12 路按键输入
    input  wire               ir_in,      // 红外避障模块（低 = 有手），引脚 74
    output wire               i2s_bck,    // 引脚 56
    output wire               i2s_lrck,   // 引脚 55
    output wire               i2s_din,    // 引脚 54
    output wire               pa_en,      // 引脚 51
    output wire [5:0]         led         // 引脚 15~20（低电平点亮）
);

    // ==================================================================
    // 1. 上电复位（不依赖外部按键）
    //    27MHz 下 2^16 周期 ≈ 2.4 ms
    // ==================================================================
    reg [15:0] por_cnt = 16'd0;
    reg        rst_n   = 1'b0;

    always @(posedge clk) begin
        if (&por_cnt) rst_n <= 1'b1;
        else          por_cnt <= por_cnt + 16'd1;
    end

    // ==================================================================
    // 2. 12 路按键扫描 → 音符事件
    // ==================================================================
    wire [KEY_NUM-1:0] key_state;
    wire                note_valid;
    wire                note_on;
    wire [NOTE_BITS-1:0] note_idx;

    key_scan #(
        .KEY_NUM    (KEY_NUM),
        .CNT_MAX    (KEY_CNT_MAX),
        .ACTIVE_LOW (0),              // TTP223 默认高有效；微动开关改成 1
        .NOTE_BITS  (NOTE_BITS)
    ) u_keys (
        .clk       (clk),
        .rst_n     (rst_n),
        .key_in    (key),
        .key_state (key_state),
        .note_valid(note_valid),
        .note_on   (note_on),
        .note_idx  (note_idx)
    );

    // ==================================================================
    // 3. 红外手势 → 音色切换（演奏第二维度）
    //    一次有效挥手换一个音色：0 三角 → 1 方波 → 2 锯齿 → 3 脉冲 → 4 钢琴
    //    与 12 键负责的"音高"维度互相独立，满足赛题"≥2 个可控演奏维度"
    // ==================================================================
    wire [2:0] wave_sel;
    wire       ir_gesture_valid;
    wire       ir_hand;
    wire       ir_tooshort;
    wire       ir_toolong;

    ir_gesture #(
        .DEBOUNCE_CNT  (IR_DEBOUNCE_CNT),
        .MIN_SWIPE_CNT (IR_MIN_SWIPE_CNT),
        .MAX_SWIPE_CNT (IR_MAX_SWIPE_CNT),
        .INIT_SEL      (3'b100),         // 复位默认：钢琴
        .N_COLORS      (5)
    ) u_ir (
        .clk           (clk),
        .rst_n         (rst_n),
        .ir_in         (ir_in),
        .wave_sel      (wave_sel),
        .gesture_valid (ir_gesture_valid),
        .hand_level    (ir_hand),
        .swipe_tooshort(ir_tooshort),
        .swipe_toolong (ir_toolong)
    );

    // ==================================================================
    // 4. 复音合成器
    // ==================================================================
    wire [VOICE_NUM-1:0] dbg_voice_busy;
    wire signed [15:0]   dbg_mix;

    synth_top #(
        .VOICE_NUM  (VOICE_NUM),
        .PHASE_BITS (32),
        .BCK_HALF   (BCK_HALF),
        // ── 音量（beta.2.1 提升）──────────────────────────────────
        // AMP 由 3/16(0x1800) 提到 3/8(0x3000) 满量程 —— 音量 +6 dB。
        //   单声部稳态峰值 = AMP × 160/255 ÷ 4 = 12288 × 160/255 ÷ 4 ≈ 1928
        //   4 声部同相到顶 = 1928 × 4 = 7712，仅为 16 位满量程(32767)的 24%，
        //   故单音与和弦均不削波，mix_tree 的饱和逻辑只在极端情形兜底。
        .AMP        (16'sh3000),        // 3/8 满量程
        .NOTE_BITS  (NOTE_BITS)
    ) u_synth (
        .clk            (clk),
        .rst_n          (rst_n),
        .note_valid     (note_valid),
        .note_on        (note_on),
        .note_idx       (note_idx),
        .all_off        (1'b0),
        .fade_soft      (1'b1),
        .sustain        (1'b0), // 12x TTP223 board: no sustain pedal
        .key_state      (key_state),
        .soft_pedal     (1'b0),   // no soft pedal on this board
        .wave_sel       (wave_sel),     // 由红外挥手切换（原为固定 100 钢琴）
        .i2s_bck        (i2s_bck),
        .i2s_lrck       (i2s_lrck),
        .i2s_din        (i2s_din),
        .dbg_voice_busy (dbg_voice_busy),
        .dbg_mix        (dbg_mix)
    );

    // ==================================================================
    // 4. 板载功放使能门控（降温）
    //    有音符发声时立即开启；静音后再保持约 155ms 才关闭。
    //    保持窗口避免音符间隙反复开关功放（会产生"啪"声），
    //    同时静音时功放断电，显著降低 MAX98357A 的发热。
    //    27MHz × 155ms ≈ 4.19e6 → 取 2^22-1 = 4194303
    // ==================================================================
    wire any_busy = |dbg_voice_busy;
    reg [21:0] pa_hold;

    always @(posedge clk or negedge rst_n) begin
        if (!rst_n)                pa_hold <= 22'd0;
        else if (any_busy)         pa_hold <= 22'h3FFFFF;      // 重新计时
        else if (pa_hold != 22'd0) pa_hold <= pa_hold - 22'd1;
    end

    assign pa_en = (pa_hold != 22'd0);

    // ==================================================================
    // 5. LED 指示（低电平点亮）
    //    led[0] : 心跳
    //    led[1] : 有音符在发声
    //    led[2] : 正在上报事件（note_valid 太短，用 latch 展宽）
    // ==================================================================
    reg [23:0] blink;
    reg        evt_stretch;

    always @(posedge clk or negedge rst_n) begin
        if (!rst_n) begin
            blink       <= 24'd0;
            evt_stretch <= 1'b0;
        end
        else begin
            blink <= blink + 24'd1;
            // 事件灯展宽到约 0.2 秒，肉眼可见
            if (note_valid)                  evt_stretch <= 1'b1;
            else if (blink[22:0] == 23'd0)   evt_stretch <= 1'b0;
        end
    end

    // 1 = 点亮（any_busy 已在第 4 节定义）
    wire [5:0] led_on = {
        2'b00,           // [5:4] 预留
        ir_hand,         // [3]   红外检测到手（挥手时可看到亮）
        evt_stretch,     // [2]   事件指示
        any_busy,        // [1]   正在发声
        blink[23]        // [0]   心跳
    };

    assign led = ~led_on;

endmodule
