M3-Grant/fpga-synth-engine/code/rtl/karplus_strong.v

// ============================================================================
//  模块名  : karplus_strong.v
//  功能    : 拨弦乐器物理建模（Karplus-Strong 算法，单声部）
//  板卡    : Sipeed Tang Nano 20K (GW2AR-18)，27 MHz
//
//  ── 为什么它能"像"拨弦乐器 ────────────────────────────────────────
//  这不是"拟合音色"，而是**弦振动方程的离散解**：
//      延迟线（长度 N = fs/f0）模拟"弦往返一次的时间"
//      一阶低通 (y[n] + y[n-1])/2 模拟"弦的阻尼"（高次谐波先衰减）
//      反馈系数 <1 模拟"能量损耗"
//  1983 年 Karplus & Strong 在 CCRMA 提出的算法，至今是所有物理建模
//  合成器的起点。物理上正确 → 听感上必然像吉他/古筝/竖琴。
//
//  ── 结构 ──────────────────────────────────────────────────────────
//      起音：往延迟线里灌 N 个白噪声采样（模拟"拨"的那一下）
//      之后：每采样读 delay[wr-N]，低通，×衰减，写回 delay[wr]
//
//  ── 资源 ──────────────────────────────────────────────────────────
//      512 × 16bit 的 BRAM（延迟线）。板上的 BSRAM 之前完全没用，正好给它。
//      不占 DSP（只有加法和移位）。
// ============================================================================
`timescale 1ns / 1ps

module karplus_strong #(
    parameter PHASE_BITS = 32,
    parameter DEPTH_LOG2 = 9,                 // 512 深延迟线
    parameter DECAY_SHIFT = 6                 // 衰减 y - y>>6（≈0.984/次）
)(
    input  wire                      clk,
    input  wire                      rst_n,
    input  wire                      sample_req,   // 音频采样率脉冲
    input  wire [PHASE_BITS-1:0]     fcw,          // 频率控制字（未直接用）
    input  wire [9:0]                ks_len,       // 延迟线长度 N = fs/f0
    input  wire                      trig,         // 起音脉冲
    input  wire                      busy,         // 1=发声 0=静音
    input  wire                      slow_decay,   // 1=钢琴式慢衰减(y>>8) 0=拨弦式快衰减(y>>5)
    // ---- 延音踏板（2026-11-04 补）----
    //   ⚠️ 之前 sustain 只喂给 note_valid 门控和 adsr，没进 KS ——
    //      踩踏板时吉他的 voice_busy 虽然保持 1，衰减却仍走拨弦档
    //      （τ≈0.25 s，0.67 s 就没声），比钢琴的 2.5 s 短一个数量级，
    //      踏板对吉他等于没用。现在踩踏板切到 ≈0.7 s 的中间档。
    input  wire                      sustain,
    output reg  signed [15:0]        audio
);

    localparam DEPTH = 1 << DEPTH_LOG2;       // 512

    // ------------------------------------------------------------------
    // 1. 延迟线（BRAM）与指针
    // ------------------------------------------------------------------
    reg  [15:0] delay [0:DEPTH-1];
    reg  [DEPTH_LOG2-1:0] wr;

    reg  [DEPTH_LOG2-1:0] rd;
    // 延迟线必须是"同步读"，综合器才会把它映射到 BSRAM。
    // 之前写成 wire x_now = delay[rd]（异步读）时，Gowin 无法用 BRAM 实现，
    // 整块 512×16 退化成触发器，7 个 KS 实例直接把 DFF 顶到 18573（上限 15750）。
    // 代价：反馈路径多 1 拍延迟，音高约低 0.5%，实际听不出来。
    reg  [15:0] x_now_r;
    always @(posedge clk) x_now_r <= delay[rd];
    wire [15:0] x_now = x_now_r;

    reg  [15:0] x_prev;          // 上一个值，用于一阶低通

    // 写端口（★ 唯一管理 wr 的地方）
    // ------------------------------------------------------------------
    // 之前 wr 由主状态机递增、而 wr_data/wr_en 晚一拍才送到这里，
    // 结果是 **数据在拍 t 准备好、地址在拍 t 已经 +1**：
    // 第 k 个激励样本落进 delay[k+1]，delay[0] 永远没人写。
    // rd 又从 0 开始读，于是读到 4 态 x，x 进入反馈环路后污染整条延迟线
    // （板上的表现就是"按下去有音、随即突然没声"）。
    // 现在把 wr 的递增搬进写端口，地址与数据在同一拍绑定。
    // ------------------------------------------------------------------
    reg  [15:0] wr_data;
    reg         wr_en;

    always @(posedge clk or negedge rst_n) begin
        if (!rst_n) begin
            wr <= {DEPTH_LOG2{1'b0}};
        end
        else if (trig) begin
            wr <= {DEPTH_LOG2{1'b0}};
        end
        else if (wr_en) begin
            delay[wr] <= wr_data;
            wr <= wr + 1'b1;
        end
    end

    // ------------------------------------------------------------------
    // 2. 白噪声（LFSR），用于起音激励
    // ------------------------------------------------------------------
    reg [15:0] lfsr;
    wire       lfsr_fb = lfsr[0] ^ lfsr[2] ^ lfsr[3] ^ lfsr[5];

    // ------------------------------------------------------------------
    // 3. 主状态机
    // ------------------------------------------------------------------
    // 激励噪声：两级低通（更"深沉"）+ 有符号中心化 + 降到 1/4 幅度
    //   一级低通听起来还是"沙沙的"，两级后才有"低频的拨弦感"。
    reg  [15:0] lfsr_prev, lfsr_prev2, lfsr_prev3;
    wire [16:0] lp1 = ({1'b0, lfsr}      + {1'b0, lfsr_prev})  >> 1;
    wire [16:0] lp2 = (lp1               + {1'b0, lfsr_prev2}) >> 1;
    wire [16:0] lp3 = (lp2               + {1'b0, lfsr_prev3}) >> 1;
    // 激励按音色分档：钢琴只过一级低通（保留高频 → 锤击的"嗒"），
    // 吉他过三级（噪声更圆润 → 拨弦的"噗"）。幅度钢琴 1/2、吉他 1/4。
    //
    // ⚠️ 幅度缩放必须对**有符号**量做算术右移。
    //    旧写法 `lp_c[15:0] >>> 1` 先把 17 位有符号截成 16 位无符号，
    //    移位就退化成逻辑右移 —— 负半周翻成接近 +32767 的大正数，
    //    等于给激励灌了一大堆满幅正脉冲。仿真里钢琴档 83 ms 就冲到
    //    32671（削波）、不到 1 s 直接归零，原因就在这里。
    wire [16:0]        exc_lp  = slow_decay ? lp1 : lp3;                    // 钢琴一级 / 吉他三级
    // 中心归零：先做无符号减法拿到补码位模式，再按有符号重新解释。
    // 不写成 $signed({1'b0, exc_lp[15:0]}) —— iverilog 对 $signed 里套拼接的
    // part-select 会报 "Unable to bind wire/reg/memory"，Gowin 却肯过，
    // 于是仿真永远跑不起来、只有综合能验。
    wire [16:0]        lp_c_u  = exc_lp - 17'd32768;
    wire signed [16:0] lp_c    = lp_c_u;
    // ⚠️ 幅度必须留够多声部叠加的余量。
    //    单个 KS 声部的稳态幅度 ≈ 激励幅度，4 声部相加就是 4 倍。
    //    2026-11-04 上一版写成钢琴 1/2（±16383），4 声部一叠加就是 65532，
    //    远超 16 位满幅 → 混音饱和后整段变成**方波**：频谱铺满全频段、
    //    波形是锯齿、听感既不像钢琴也不像吉他。
    //    现在钢琴 1/4、吉他 1/8：4 声部最坏 32764 / 16380，都不削波。
    //   2026-11-04 第三轮：激励改为全幅注入，后面的谱整形低通（α=1/16）
    //   对噪声的 RMS 增益约 0.18（-14.9 dB），正好把幅度拉回可用范围：
    //   实测峰值 钢琴 ≈5900、吉他 ≈4000，4 声部叠加 23600 / 16000，不削波。
    wire signed [16:0] exc_s   = lp_c;

    // ★ 2026-11-04 第三轮：激励谱整形（决定"像不像钢琴"的关键）
    //   原始噪声激励谱是**平坦**的，而 KS 环路的一阶低通对 257 Hz 的基频
    //   几乎不衰减（每圈 0.024%），5 次谐波每圈也只多衰 0.3%，150 圈才 -3.6 dB。
    //   实测（FFT，音头 60 ms）：H1..H6 = 0/-0.6/-6.5/-0.7/+0.5/-2.7 dB ——
    //   H2..H5 与 H1 几乎同强，听感是"金属 / 电子嗡"，不像琴弦。
    //   真实钢琴的谐波约按 1/h^1.5：H2 -9、H3 -14、H4 -18 dB。
    //   解决办法：让激励先过一阶低通 α=1/16（fc≈530 Hz），
    //   得到约 0/-3.9/-8.0/-11.7/-14.9 dB 的谐波倾斜，接近钢琴。
    //   低通时间常数 16 采样（0.3 ms），远小于激励灌入的 202 采样，不影响音头包络。
    wire signed [19:0] exc_s20  = {{3{exc_s[16]}}, exc_s};
    reg  signed [19:0] exc_acc;
    wire signed [19:0] exc_err  = exc_s20 - exc_acc;
    wire signed [19:0] exc_filt = exc_acc + (exc_err >>> 4);
    wire        [15:0] exc_val  = exc_filt[15:0];

    localparam S_IDLE  = 2'd0;
    localparam S_EXC   = 2'd1;      // 灌噪声
    localparam S_RUN   = 2'd2;      // 正常 KS 循环

    reg [1:0]  state;
    reg [9:0]  exc_cnt;
    // 2026-11-04：run_cnt 由 16 位扩到 18 位。
    // 慢衰减（钢琴 τ≈1.0 s）尾音到 1.14 s 时还有 ~31%（-10 dB），
    // 原来 16 位写死 60000 会在那儿**硬截断**，听起来是"咔"一声断掉。
    reg [17:0] run_cnt;
    reg [9:0]  len_q;               // 锁存本轮的 N

    // 尾音上限：钢琴放长到 ≈3.4 s（自然衰减到 -30 dB 以下），
    // 吉他保持 ≈0.95 s（那时已低于 0.7%，本来就没声了）。
    localparam [17:0] RUN_MAX_PIANO = 18'd180000;   // 180000 / 52734 ≈ 3.41 s
    localparam [17:0] RUN_MAX_PLUCK = 18'd50000;    //  50000 / 52734 ≈ 0.95 s
    wire [17:0] run_max = (slow_decay || sustain) ? RUN_MAX_PIANO : RUN_MAX_PLUCK;

    // 衰减后的反馈值
    // ------------------------------------------------------------------
    // 2026-11-04 第二轮：钢琴与吉他必须拉出**听感差距**
    //
    // 第一版只有衰减移位一个 bit 的差别（>>7 vs >>6，0.7 s vs 0.5 s），
    // 低通和激励完全一样 —— 用户实测"钢琴和吉他太接近"。
    // 现在三个维度同时区分：
    //
    //   维度        钢琴                      吉他
    //   ----------  ------------------------  --------------------------
    //   反馈低通    (a+b)/2       保留高频     (a+3b)/4     更闷、像木箱
    //   衰减        y-(y>>8) ≈1.4 s          y-(y>>5) ≈0.25 s
    //   激励        一级低通、幅度 1/2        三级低通、幅度 1/4
    //               （锤击的宽带瞬态）        （圆润的拨弦噪声）
    //
    // 两条曲线直流增益都是 1、环路增益都 <1，稳定。
    // ------------------------------------------------------------------
    // ★★ 2026-11-04 关键修复（低通级）：延迟线里是**补码**，16 位。
    //    旧写法 `{1'b0, x_now} + {1'b0, x_prev}` 是**零扩展**：
    //    -9909 被拼成 55627，低通结果 `lp` 直接变成 +27813，
    //    激励/反馈的负半周整段翻成正的大数，所以波形一直顶着削波、
    //    音色当然"闷且雷同"。低通必须显式符号扩展 + 算术右移。
    wire signed [15:0] x_now_s  = x_now;
    wire signed [15:0] x_prev_s = x_prev;

    wire signed [16:0] lp_piano = {x_now_s[15], x_now_s} + {x_prev_s[15], x_prev_s}; // a+b
    wire signed [15:0] lp_p     = lp_piano >>> 1;                                    // (a+b)/2
    wire signed [18:0] lp_pluck = {x_now_s[15], x_now_s[15], x_now_s}
                                + {x_prev_s[15], x_prev_s[15], x_prev_s}
                                + {x_prev_s[15], x_prev_s[15], x_prev_s}
                                + {x_prev_s[15], x_prev_s[15], x_prev_s};        // a+3b
    wire signed [15:0] lp_g     = lp_pluck[17:2];                                    // (a+3b)/4
    wire signed [15:0] lp       = slow_decay ? lp_p : lp_g;

    // 衰减也必须是有符号算术右移（上一棒已改成 >>>，保留）。
    wire signed [15:0] lp_s           = lp;
    wire signed [15:0] decayed_piano  = lp_s - (lp_s >>> 8);   // 钢琴：约 1.4 s
    wire signed [15:0] decayed_pluck  = lp_s - (lp_s >>> 5);   // 吉他松键：约 0.25 s
    // 吉他 + 延音踏板：介于两者之间（≈0.7 s），否则踩了踏板还是 0.67 s 就没了
    wire signed [15:0] decayed_pluck_sus = lp_s - (lp_s >>> 7);
    // 松键阻尼：busy=0（键已松开且没踩延音踏板）时用快衰减，
    // 约 70 ms 听不见 —— 这才是钢琴"止音"的手感。
    wire signed [15:0] decayed_damper = lp_s - (lp_s >>> 3);
    wire signed [15:0] decayed = busy
        ? (slow_decay ? decayed_piano
                      : (sustain ? decayed_pluck_sus : decayed_pluck))
        : decayed_damper;

    // ------------------------------------------------------------------
    // ★★ 色散全通：让泛音"拉伸"，这才像钢琴（2026-11-04 第二轮）
    //
    //   线性延迟线只能产生严格谐波 f_n = n·f0 —— 那是"理想弦"，
    //   听起来像竖琴/吉他，永远不像钢琴。
    //   真实钢琴弦有弯曲刚度，泛音被拉伸：
    //       f_n ≈ n·f0·sqrt(1 + B·n²)      （B = 非谐性系数）
    //   低音区 B ≈ 1e-4，高音区可到 1e-2，这就是钢琴"金属味/厚度"的来源。
    //
    //   标准解法（Jaffe & Smith 1983 的 Extended Karplus-Strong）：
    //   在环路里插一阶全通
    //       y[n] = x[n-1] - a·x[n] + a·y[n-1]
    //   全通 |H| = 1 不改变幅度、不影响稳定性，但相位延迟随频率下降，
    //   高频泛音的环路周期变短 → 频率被抬高 → 等效于 B > 0。
    //
    //   实现：a 用 2^-SHIFT 的移位做，不占乘法器。
    //   ⚠️ a 太小等于没做：一阶全通 a=1/16 在 2 kHz 的相位延迟只差 0.12 采样，
    //      相对 202 的环路只有 0.06%，等效 B ≈ 2e-5 —— 完全听不出来。
    //      要让 C4 的 B 落到 1e-4 量级，a 必须取到 1/2 左右。
    //      代价是基频会被拖慢约 1%（可在 ks_len 里补 1 个采样）。
    //   钢琴 a = 1/2（明显色散），吉他 a = 1/16（几乎理想弦）。
    // ------------------------------------------------------------------
    wire [3:0] disp_sh = slow_decay ? 4'd1 : 4'd4;      // a = 2^-1 / 2^-4
    reg  signed [16:0] ap_x1, ap_y1;
    wire signed [16:0] ap_in  = decayed;
    wire signed [16:0] ap_out = ap_x1 - (ap_in >>> disp_sh) + (ap_y1 >>> disp_sh);

    always @(posedge clk or negedge rst_n) begin
        if (!rst_n) begin
            ap_x1 <= 17'sd0;
            ap_y1 <= 17'sd0;
        end
        else if (sample_req && state == S_RUN) begin
            ap_x1 <= ap_in;
            ap_y1 <= ap_out;
        end
    end


    always @(posedge clk or negedge rst_n) begin
        if (!rst_n) begin

            rd       <= {DEPTH_LOG2{1'b0}};
            x_prev   <= 16'd0;
            wr_en    <= 1'b0;
            wr_data  <= 16'd0;
            lfsr     <= 16'hACE1;
            state    <= S_IDLE;
            exc_cnt  <= 10'd0;
            run_cnt  <= 18'd0;
            exc_acc  <= 20'sd0;
            len_q    <= 10'd200;
            audio    <= 16'sd0;
        end
        else begin
            wr_en <= 1'b0;

            // LFSR 每周期都跑（噪声源）
            lfsr      <= {lfsr_fb, lfsr[15:1]};
            lfsr_prev  <= lfsr;
            lfsr_prev2 <= lfsr_prev;
            lfsr_prev3 <= lfsr_prev2;

            if (trig) begin
                // 起音：进入激励阶段，指针归零（wr 由写端口清，见上）
                state   <= S_EXC;
                rd      <= {DEPTH_LOG2{1'b0}};
                exc_cnt <= 10'd0;
                run_cnt <= 18'd0;
                exc_acc <= 20'sd0;
                len_q   <= ks_len;
                x_prev  <= 16'd0;
                audio   <= 16'sd0;
            end
            else if (sample_req) begin
                case (state)
                    // ---- 灌噪声：写满 N 个采样 ----
                    S_EXC: begin
                        // 激励噪声先做一阶低通 —— 原始白噪声直接灌进去听起来像
                        // "在弦上使劲摩擦"，低通后才像"拨一下"。
                        exc_acc <= exc_filt;   // 一阶低通状态推进
                        wr_data <= exc_val;
                        wr_en   <= 1'b1;
                        exc_cnt <= exc_cnt + 10'd1;
                        if (exc_cnt + 10'd1 >= len_q) begin
                            state <= S_RUN;
                            // 激励从 delay[0] 顺序写到 delay[N-1]，最老的样本就是
                            // delay[0]，所以读指针直接从 0 开始（wr 由写端口推进）。
                            rd    <= {DEPTH_LOG2{1'b0}};
                        end
                    end

                    // ---- 正常循环 ----
                    S_RUN: begin
                        // 色散全通 → 衰减 → 写回延迟线
                        wr_data <= ap_out[15:0];
                        wr_en   <= 1'b1;

                        x_prev <= x_now;           // 记住上一次读出值
                        rd     <= rd + 1'b1;

                        audio  <= $signed(x_now);  // 输出当前读出值

                        run_cnt <= run_cnt + 18'd1;
                        // 尾音自然衰减：不再因"松键"立即静音。
                        //   busy 只表示"这个声部是否被按键占用"，
                        //   而延迟线里的能量该衰减多久，就让它衰减多久。
                        //   弹完一个单音马上弹复音时，单音的余音不会被砍断。
                        //   上限按音色分档（run_max），见上面的 localparam。
                        if (run_cnt > run_max) begin
                            state <= S_IDLE;
                            audio <= 16'sd0;
                        end
                    end

                    default: begin
                        state <= S_IDLE;
                        audio <= 16'sd0;
                    end
                endcase
            end
        end
    end

endmodule
