M3-Grant/fpga-synth-engine/code/rtl/note_table.v

// ============================================================
//  note_table.v —— 音符 → 频率控制字（FCW）查找表
//  自动生成，请勿手改。重新生成：python gen_fcw.py 27e6 4 --out note_table.v
//
//  主时钟   : 27.000 MHz
//  BCK_HALF : 4
//  实际 fs  : 52734.375 Hz
//  公式     : FCW = f * 2^32 / fs
// ============================================================

module note_table (
    input  wire [4:0]  note_idx,   // 0..24 -> MIDI 60..84
    output reg  [31:0] fcw
);

    always @(*) begin
        case (note_idx)
            5'd0 : fcw = 32'd21308174;  // C4 (261.63 Hz)
            5'd1 : fcw = 32'd22575224;  // C#4 (277.18 Hz)
            5'd2 : fcw = 32'd23917617;  // D4 (293.66 Hz)
            5'd3 : fcw = 32'd25339832;  // D#4 (311.13 Hz)
            5'd4 : fcw = 32'd26846617;  // E4 (329.63 Hz)
            5'd5 : fcw = 32'd28443000;  // F4 (349.23 Hz)
            5'd6 : fcw = 32'd30134309;  // F#4 (369.99 Hz)
            5'd7 : fcw = 32'd31926188;  // G4 (392.00 Hz)
            5'd8 : fcw = 32'd33824618;  // G#4 (415.30 Hz)
            5'd9 : fcw = 32'd35835935;  // A4 (440.00 Hz)
            5'd10: fcw = 32'd37966850;  // A#4 (466.16 Hz)
            5'd11: fcw = 32'd40224476;  // B4 (493.88 Hz)
            5'd12: fcw = 32'd42616348;  // C5 (523.25 Hz)
            5'd13: fcw = 32'd45150448;  // C#5 (554.37 Hz)
            5'd14: fcw = 32'd47835234;  // D5 (587.33 Hz)
            5'd15: fcw = 32'd50679665;  // D#5 (622.25 Hz)
            5'd16: fcw = 32'd53693234;  // E5 (659.26 Hz)
            5'd17: fcw = 32'd56886000;  // F5 (698.46 Hz)
            5'd18: fcw = 32'd60268618;  // F#5 (739.99 Hz)
            5'd19: fcw = 32'd63852376;  // G5 (783.99 Hz)
            5'd20: fcw = 32'd67649236;  // G#5 (830.61 Hz)
            5'd21: fcw = 32'd71671869;  // A5 (880.00 Hz)
            5'd22: fcw = 32'd75933700;  // A#5 (932.33 Hz)
            5'd23: fcw = 32'd80448953;  // B5 (987.77 Hz)
            5'd24: fcw = 32'd85232697;  // C6 (1046.50 Hz)
            default: fcw = 32'd0;
        endcase
    end

endmodule
