M3-Grant/fpga-synth-engine/(commit log)

2026-10-08 feat: 第一代可行性验证完成（21 项仿真全部通过）
    选题二《基于 FPGA 的实时多音色合成电子乐器引擎》
    平台：高云 GW2AR-LV18QN88C8/I7（Sipeed Tang Nano 20K）
    ## 本次交付
    - i2s_tx.v 标准 Philips I2S 发送机（9/9 通过）
    - tone_test_top.v 440Hz 发声顶层，即"生死线工程"（实测 439.86Hz，误差 0.03%）
    - note_table.v 音名→频率控制字表，C4~C6 共 25 个半音
    - led_ctrl_top.v LED 模式控制顶层（10/10 通过）
    - run_sim_all.bat 一键跑完三套仿真
    - docs/ 8 篇项目文档（接线、排期、采购、模块规格等）
    ## 验证结果
    i2s_tx BCK 周期 296.3ns / 每 LRCK 周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
2026-10-08 docs: 添加仓库 README（快速开始、关键结论、编码约定）
2026-10-08 docs: 添加协作开发指南（clone、pull/push、冲突处理、编码红线）
2026-10-08 chore: 添加批量邀请协作者脚本
2026-10-08 chore: 添加队员一键环境配置脚本 setup.ps1
2026-10-09 docs: 第一代 demo 评审报告（21 项测试全通过，含 4 类问题与修正建议）
2026-10-09 feat(iter02): 复音架构 + ADSR 包络 —— 第二代核心功能
    在 demo0.0.1（单音/方波/无包络）基础上完成复音合成器架构。
    ## 新增模块
    - osc_voice.v 单声部振荡器（DDS 相位累加 + 方波 + 包络调制）
    - oscillator_array.v 振荡器阵列（generate 参数化例化 N 份）
    - note_alloc.v 音符分配器（note-on/off、声部复用、占满抢占）
    - mix_tree.v 混音器（N 路求和 + 饱和处理，防削波爆音）
    - adsr.v ADSR 包络发生器（四段状态机，线性步进）
    - synth_top.v 复音合成器顶层（整合完整链路）
    ## 测试平台
    - tb_note_alloc.v 分配/释放/复音4/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
    [adsr.v, mix_tree.v, note_alloc.v, osc_voice.v, oscillator_array.v, synth_top.v, tb_adsr.v, tb_note_alloc.v]
2026-10-09 docs: README 更新至 demo0.0.2（复音架构 + ADSR 成果）
2026-10-09 feat(iter03): 板级顶层 + 烧录指南 —— 第二代 demo 可以上板了
    ## 为什么需要这一层
    synth_top 的输入是抽象音符事件（note_valid/note_on/note_idx），
    板上没有东西能驱动它，只能在仿真里跑。
    本迭代补上板级顶层，把真实按键接到合成器。
    ## 新增
    - rtl/synth_board_top.v 板级顶层
    · 2 个板载按键 + 状态机实现音阶步进（C4~C5 共 8 个音）
    · 上电自复位、按键消抖、LED 状态指示
    · KEY1 = 发声/停声，KEY2 = 切换到下一个音
    - constraints/synth_board.cst 引脚约束（clk/key/i2s/pa_en/led）
    - sim/tb_synth_board.v 板级测试（12 项全通过）
    - docs/1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
2026-10-10 feat(iter04): WAV 音频导出 + 触摸键盘扩展板设计
    板子还没到货，本迭代解决两个问题：
    1) 没有硬件时如何听到复音效果 → 导出 WAV
    2) 交互层硬件怎么设计 → 扩展板原理图
    ## 1. WAV 音频导出
    新增 sim/tb_export_wav.v：
    · 把 synth_top 的混音输出写成标准 16bit 单声道 WAV
    · 采样率 52734 Hz（与 I2S 实际采样率一致，不是 48000）
    · 演奏 4 段内容：单音 C4 / C大三和弦 / 琶音 / 四音叠加
    · 输出 synth_demo.wav（80KB，0.78 秒，可直接播放）
    验证结果（tools/check_wav.py）：
    头标记 RIFF/WAVE/fmt/data 全部正确
    格式 PCM、单声道、52734Hz、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
    [tb_export_i2s.v, tb_export_wav.v]
2026-10-10 fix(iter04): 修正 WAV 文件大小字段 —— 之前播放器无法读取
    ## 问题
    之前生成的 synth_demo.wav 无法被播放器读取。
    根因：RIFF ChunkSize 和 data 块大小两个字段都是 0，播放器无法
    确定音频数据长度，直接拒读。
    ## 为什么会这样
    iverilog 的 只能顺序写文件，无法回填前面已写的大小字段。
    我用 手工拼 WAV 头，头写完之后才能知道总样本数，
    此时文件位置已在末尾，没法回头改 ChunkSize。
    ## 修正方案
    改为两段式：
    1) tb_export_wav.v 只导出**原始 PCM**（synth_demo.pcm，纯样本数据）
    2) tools/pcm_to_wav.py 用 Python wave 模块封装 WAV 头
    —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
    [tb_export_wav.v]
2026-10-11 fix(iter04): 改用十六进制文本导出 —— 彻底修正 WAV 无声问题
    ## 真正的根因
    之前用 $fwrite("%c") 写二进制 PCM，iverilog 会把 NUL 字节(0x00)
    当字符串终止符。而音频样本的低字节经常是 0x00，导致数据在第一个
    0x00 处就被截断。
    现象：WAV 文件头完全正确（大小字段也对），但数据几乎为空 ——
    播放器显示时长 0，只能听到极短一段。
    ## 修正
    改为 iverilog 只导出**十六进制文本**，每行一个 16 位样本：
    tb_export_wav.v → synth_demo.hex
    tools/hex_to_wav.py → synth_demo.wav / synth_demo_44k.wav
    彻底避开二进制写入的所有坑。
    ## 验证结果（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
    [hex_to_wav.py, tb_export_wav.v]
2026-10-11 feat(iter04): 音频时长扩展到 6.89 秒，支持循环拼接
    ## 背景
    原音频只有 0.78 秒，作为演示太短。用户要求拉到 7 秒左右。
    ## 遇到的问题：仿真速度
    iverilog 是解释执行，实测速度约 37000 采样/分钟。
    - 3.6 秒音频（182000 采样）需仿真约 29 分钟
    - 7 秒音频（370000 采样）需约 60 分钟（实测跑了 26 分钟才 34%，已终止）
    ## 解决方案：循环拼接 + 交叉淡入淡出
    1) tb_export_wav.v 时长参数调整为 3.45 秒（182000 采样，仿真 29 分钟）
    2) tools/hex_to_wav.py 新增 --loop 参数，把真实演奏循环拼接
    并在接缝处做 15ms 交叉淡入淡出，避免爆音
    这样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
    [hex_to_wav.py, tb_export_wav.v]
2026-10-13 feat(beta3): 12 键可演奏电子琴 —— 交互层落地
    从「2 键切换音阶演示」升级为「12 键直连演奏」。
    - rtl/key_scan.v 12 路按键扫描（消抖 + 锁存 + 逐拍上报）
    - rtl/synth_board12_top.v 12 键板级顶层，可直接上板演奏
    - constraints/synth_board12.cst
    - sim/tb_key_scan.v 扫描器单元测试
    - sim/tb_synth_board12.v 12 键集成测试
    ## 12 键覆盖一个完整八度（含全部半音）
    KEY0~11 → C4 C#4 D4 D#4 E4 F4 F#4 G4 G#4 A4 A#4 B4
    半音齐全，可演奏任意调式
    key_scan 8 项 PASS（含三键同时按下恰好 3 个事件）
    synth_board12 9 项 PASS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
2026-10-13 fix(beta.1.01): 修正 tb_synth_top.v 的前向引用编译错误
    tb_synth_top.v 中
    eg req_d; 声明在观察任务区（原第 75 行），
    但它在第 59 行的 always 块里已被使用：
    always @(posedge clk) req_d <= dut.sample_req; // 第 59 行：使用
    ...
    reg req_d; // 第 75 行：声明
    iverilog 不允许这种"先使用后声明"的前向引用，导致该测试编译失败。
    ## 修复
    把声明移到使用之前，并初始化为 0：
    reg req_d = 1'b0;
    always @(posedge clk) req_d <= dut.sample_req;
    ## 验证
    - tb_synth_top 单独编译通过
    - 全量 9 套仿真全部通过（ALL SIMULATIONS PASS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
2026-10-14 fix(constraints): 按键引脚改用官方例程验证过的分配 + 烧录指南更新到 12 键
    ## 原约束的两个问题
    1. key[10]=87, key[11]=88 —— **88 是板载复位按键**，接上会冲突
    2. 引脚依据只是"排除已占用后推断"，没查官方例程
    ## 本次修正：改用官方 .cst 文件里的引脚
    27~32 官方 rgb_lcd/.../tang_nano_20K_LCD.cst (LCD_B[4:0], LCD_G[5])
    41, 42 同上 (LCD_R[1:0])
    48 同上 (LCD_DEN)
    77 同上 (LCD_CLK)
    79 官方 ws2812.cst (WS2812)
    25 官方引脚框图（排针 LED_HS）
    54/55/56/51 官方 audio.cst (HP_DIN/HP_WS/HP_BCK/PA_EN)
    15~20 官方 flow_led.cst (6 颗 LED)
    这些原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
2026-10-14 feat(board): end-to-end build+flash pipeline, board makes sound
    - add code/synth/build.ps1 + README.md : gw_sh Tcl synth/PnR/program, 3 targets
    - KEY FIX: pins 54/55/56 are SSPI dedicated pins -> set_option -use_sspi_as_gpio 1
    - fix illegal SINGLE_RESISTOR attribute in synth_board.cst / synth_board12.cst
    - fix EX3791 width truncation in osc_voice.v (modulated>>>8 -> modulated[23:8])
    - fix LED concat width bug in synth_board_top.v (7 bits truncated to 6, killed heartbeat)
    - lower volume 12dB: AMP 16'sh2000 -> 16'sh0800
    - add docs/12 progress log, ignore build/ artifacts
2026-10-15 feat(audio): triangle wave, volume tuning, honest test runner
    - osc_voice: add WAVE_TRI param, default to triangle wave
    odd harmonics now fall as 1/n^2 instead of 1/n (3rd harmonic 9.5dB lower,
    9th 19dB lower) -- fixes the spectral tail seen on the phone analyser
    - volume: AMP 1/16 -> 1/8 full scale across all 4 top modules (user-tuned)
    - add chord_demo_top: self-playing demo needing zero wiring, 15s loop
    single note -> C major triad -> Cmaj7 -> ascending scale, for tuning
    - add run_sim_all.ps1: scans output for [FAIL]; the old .bat only looked at
    exit codes and reported ALL PASSED even with 2 real failures
    - tb_synth_board12: recalibrate peak thresholds for new AMP + wavefor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
2026-10-15 tune(audio): AMP 1/8 -> 3/16 full scale, triangle scaling now AMP-agnostic
    - osc_voice: replace shift-based triangle scaling (only supported power-of-two
    amplitudes) with tri_c * AMP / 16384. AMP is a compile-time constant so this
    folds into shift-add and uses no DSP multiplier.
    - AMP 16'sh1000 (1/8) -> 16'sh1800 (3/16) in all 4 top modules: +3.5dB.
    (the triangle wave has ~4.8dB lower RMS than the square wave it replaced)
    - 4 voices at full scale = 4 x 6144 = 24576, still under the 16-bit rail.
2026-10-15 fix(sim): repair peak observation for continuous waveforms
    - tb_synth_top / tb_synth_board12: the peak-observation window was only
    5.8~7.8 audio samples (3000~4000 clk). That was fine for a square wave
    (every sample is +/-AMP) but silently missed the triangle wave's peak,
    producing a false FAIL on the single-note amplitude check.
    Widened to 150000 clk (~2.4 periods of A4) with the timeout guard raised.
    - tb_synth_top: press_note waits 60000 clk so the envelope truly reaches
    SUSTAIN (ATTACK 32 + DECAY 48 = 80 updates x 512 clk = 40960 clk).
    - tb_synth_board12: recalibrate thresholds; measured peaks now match theory
    exactly -- AMP=8192 -> 1285 (measured 1283), AMP=6144 -> 9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
2026-10-15 feat(power): gate pa_en on voice activity to cut amplifier heat
    - chord_demo_top / synth_board12_top / synth_board_top: pa_en was tied high,
    so the MAX98357A stayed powered even while silent (a real heat source).
    It now enables as soon as any voice sounds and switches off ~155ms after
    the last note ends; the hold window avoids audible pops from toggling the
    amplifier between notes.
    - tb_synth_board: observe_peak window widened 4000 -> 150000 clk (the same
    continuous-waveform sampling bug as the other two testbenches), and the
    pa_en checks now cover both directions: high while sounding, low after a
    long silence.
2026-10-15 feat(audio): runtime-selectable waveforms (tri/square/saw/pulse)
    - osc_voice: add wave_sel[1:0] and generate four waveforms straight from the phase accumulator (no wave ROM needed): 00 triangle (default) / 01 square / 10 sawtooth / 11 pulse 25%. All four peak at AMP, so switching never jumps the volume.
    - oscillator_array / synth_top: plumb wave_sel through.
    - chord_demo_top: rotates the waveform once per 15s round (00->01->10->11), so all four timbres can be auditioned with zero extra wiring.
    - other tops and tb_synth_top tie wave_sel to 2'b00 for now; this port is the hook the second interaction dimension (IR gesture) will drive.
    Full regression: 9/9 suites pass.
2026-10-15 release(beta.2): on-board sound + timbre upgrade + amp gating + key fix
    Teammate contribution (independently verified before merging):
    - rtl/key_scan.v: fix a real bug. 'press_lat <= key_press' OVERWROTE pending bits, so a key pressed while a chord was still being uploaded got silently dropped (G4 never sounded). Verified: our old file FAILs the new regression tb with 'note-on count = 0', the new one passes.
    - constraints/synth_board12.cst: key[5] 32 -> 26. Pin 32 is NOT broken out to the 40-pin header (verified against the Sipeed pinout); 26 is (IOB6B / LCD_VS).
    - sim/tb_key12_notes.v: new testbench that constructs exactly that race (3 keys held, 4th inserted 2 cycles later).
    Other chan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
2026-10-17 release(beta.2.1): +6 dB volume, honest README/00-先看我, real regression entry
    RTL change (the only functional one)
    - synth_board12_top.v: AMP 16'sh1800 -> 16'sh3000 (3/16 -> 3/8 full scale)
    single-voice steady peak 965 -> 1928 (+6.02 dB); worst case 4 voices in
    phase = 7712 / 32767 = 23.5%, i.e. 12.6 dB headroom, no clipping
    - tb_synth_board12.v: amplitude assertion (700,1300) -> (1700,2150)
    Docs (both still described the 2026-10-08 package)
    - 00-先看我.md: claimed 7 RTL files, 3 suites, "21 checks", pa_en fixed high.
    Now lists all 17 modules, 10 regression suites, the prebuilt bitstream, the
    real pin map, resource usage, LED debug hints and the six traps we hit.
    - README.md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
2026-10-17 feat(piano): 6-harmonic additive engine with piano-like decay
    New module piano_engine.v
    - 4 voices x 6 harmonics, weight ~1/h^1.5 (sum = 65536 for exact scaling)
    - each harmonic has its own exponential decay (tau = 2^s samples):
    h=1 310 ms, h=4 78 ms, h=6 39 ms -> the tone gets darker as it decays,
    which is what makes it sound like a piano instead of a flute
    - attack 64 samples (~1.2 ms, hammer), no sustain, damper on key release
    (measured: +18 ms 1752 -> +37 ms 244 -> +75 ms 0)
    - 32-point sine LUT + first-order interpolation (2^9 effective points,
    ~-60 dB THD), written as a case statement so no external .mem file is needed
    - serial multiply-accumulate: 24 paths in 28 clk, vs the 128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
2026-10-27 tune(audio): raise digital gain to ~50% full scale (still hardware-limited)
    Board feedback 2026-10-27: +6 dB was still too quiet.
    - piano_engine: mix = acc>>>1 -> acc - (acc>>>3) (x0.875)
    single note ~17600 / 32767 (~54%)
    - synth_top: legacy path mix_out[16:1] -> mix_out[15:0] (divide by 1)
    4 voices worst case 30908 < 65536, no wrap
    - tb_piano_engine / tb_synth_board12 / tb_synth_top thresholds updated
    Known trade-off: a 4-note chord now saturates (acc ~52900 -> clipped 32767).
    A single note and a chord differ by ~3x, so no linear gain satisfies both;
    that would need a limiter/compressor (not implemented).
    Board measurement: still quiet after this change. Digital gain is exhausted.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
2026-10-28 feat(touch): TTP229 2-wire serial input + bring-up firmware for incoming hardware
    The board's onboard MAX98357A is dead (it saturates at 18% of full scale, so
    digital gain above that changes nothing). New PCM5102A + PAM8403 arrived soon,
    and the 12 TTP223 keys are replaced by one TTP229 "piano" module. Everything
    that does not need the physical parts is done here so the hardware can be
    dropped in and tested immediately.
    TTP229 input path (new)
    - ttp229_scan.v: 500 kHz read clock, 200 us sync, 20 ms scan period,
    16-bit MSB-first capture, KEY_NUM / bit-order parameterised
    - ttp229_debug.v: press a key, led[3:0] shows its bit number -> used to
    measure the module's real bit mapping (no audi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
2026-10-28 docs(beta.5): refresh README / 00-先看我 for the TTP229 generation, 14-suite regression
    Documentation was still describing beta.4 (IR gesture only). This brings both
    entry documents up to the current state and wires the new tests into CI.
    - README: beta.5 status, two touch generations (12x TTP223 parallel vs one
    TTP229 2-wire serial module), piano timbre description, per-target resource
    table, version history up to beta.5
    - 00-先看我: 24 synthesizable modules, 14 regression suites, pin map for both
    touch paths, LED semantics, documents index including docs/15..18
    - run_sim_all.ps1: added `ttp229` and `synth_ttp229` suites (12 -> 14)
    - tb_synth_board12: amplitude window 6000~2100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
2026-10-31 release(v1.0.0): first competition submission - 12-key playable synth with host UI control
    This is the version recorded for the first-stage school competition video.
    Two-way serial link (new)
    - uart_stream.v: 576-byte frame @15fps/115200 - timbre, 12 keys, voices,
    512 samples (offset-binary), latency/histogram slots (left 0 on purpose so
    the host shows "-- ms" instead of a fabricated number)
    - uart_rx.v + ui_cmd.v: PC -> FPGA command channel (0xA5 0x01 <wave>), so the
    host UI can switch timbre in real time
    - synth_ttp229_top: final timbre = ui_active ? ui_wave : ir_wave, and a hand
    wave clears ui_active -- hardware (IR) always takes back control, as agreed
    - pins: uart_tx on 48/69/4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
2026-11-03 release(v2.0.0): 103 fps telemetry, real Lissajous, Electron host UI
    - perf(uart_stream): pipelined double buffer + BAUD 921600 + DECIM 1 -> 14.7 fps to 103 fps, zero misalignment over 682 frames
    - fix(uart_rx): downlink timbre command was still decoded at 115200; now 921600 (this was the real cause of 'timbre snaps back')
    - fix(voices): popcount of dbg_voice_busy instead of 'any busy', UI now shows the real polyphony count
    - fix(latency_meter): touch_evt is now a rising edge of a NEW press; the old level form leaked a stale t0 and produced 45 ms false readings
    - feat(host_ui): Hilbert analytic-signal Lissajous with phosphor afterglow, 2x supersampling, 120 Hz adaptive rendering
    - feat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
2026-11-04 feat(v2.1): 松键渐弱开关、红外双路诊断、延音踏板
    固件侧
    - ui_cmd: 新增 0xA5 0x02 <0|1> 渐弱开关，fade_soft 送入 synth_top
    - synth_top / adsr: 松键按 fade_soft 选择 48 ms 渐弱或立即静音
    - note_alloc: 新增 all_off 输入，延音踏板抬起且无按键时一次性回收全部声部
    - synth_ttp229_top: 延音踏板接 IR#1（引脚 85）；IR#2（引脚 73）两拍同步后
    与 IR#1 打包进帧尾 568 字节；新增挥手/过短/过长三个诊断计数
    - uart_stream: 帧尾 568..571 输出红外诊断（原保留字节）
    - ks_array / karplus_strong: 双弦 KS（3 双 + 1 单）与钢琴/吉他衰减参数调整
    上位机
    - 新增「松键渐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
2026-11-04 feat(v2.1b): 延音踏板总开关、README 重写、清除 Verilog BOM
    固件
    - ui_cmd: 新增 0xA5 0x03 <0|1> 延音踏板使能，输出 sustain_en（复位默认 1）
    - synth_ttp229_top: sustain = ir_hand & ui_sustain_en。红外避障模块朝桌面被常遮挡时
    会一直报有手，等价于踏板被永久踩住 —— 数字波形档的松键事件全被吞掉，
    听感上就是挂音。上位机给一个总开关即可在常遮挡场景下关掉踏板功能。
    - 实测：关闭瞬时 voices 由 4 归 0（all_off 在 sustain 下降沿回收全部声部）
    - header 新增「延音踏板」开关（0xA5 0x03），与「松键渐弱」并列
    - 发送抽成 sendCmd()，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
2026-11-04 feat(audio): 踩着延音踏板松手时数字波形改为指数渐弱
    问题：顶层把松键事件门控掉以后，note_alloc 的 voice_busy 一直保持 1，
    adsr 的 gate 因此恒为 1，包络停在 SUS_LEVEL —— 三角/方波/锯齿/脉冲
    四档在踩踏板松手后是恒定满音量，听起来是挂音而不是延音。
    改法：给 adsr 增加 sustain / key_held 两个输入，新增 S_PEDAL 状态。
    SUSTAIN 里检测到踩着踏板但该声部的键已经松开就转 S_PEDAL，
    按 env - env/16 - 1 每 1024 采样指数下降：160 -> 0 约 0.93 s，
    与钢琴 KS 档的自然余韵同量级。抬脚则转回 RELEASE 走原来的快速收尾。
    key_held 由 synth_top 用 ke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
2026-11-04 fix(ui): 连接建立后自动下发两个开关状态
    固件复位或页面重载后，UI 的勾选状态和片内的 fade_soft / sustain_en
    会脱节：页面显示「延音踏板 开」，实际固件里还是上一次的 0。
    表现就是「我明明关了踏板，松手怎么还在响」。
    现在 connectBridge() 成功后会静默下发一次 0xA5 02 / 0xA5 03，
    新增 sendCmdRaw()，它只发命令、不覆盖状态栏文字。
2026-11-04 fix(ks): 修复延迟线指针错位、低通零扩展、衰减无符号三个缺陷
    - 写端口独占 wr 递增：原来数据在拍 t 准备好、wr 已在拍 t 递增，
    第 k 个激励样本落进 delay[k+1]，delay[0] 永远没人写；rd 又从 0 读，
    读到 4 态 x，x 进反馈环路后污染整条延迟线（板上表现=按下有音、
    随即突然没声）。改为写端口原子地绑定地址与数据。
    - 低通改为显式符号扩展 + 算术右移：{1'b0, x_now} 是零扩展，
    -9909 被拼成 55627，lp 变成 +27813，负半周整段翻成正的大数，
    于是恒削波、音色闷且雷同。
    - 吉他反馈低通 a+3b 原来写成 4 个左移项相加（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
2026-11-04 docs: 同步 KS 引擎修复后的音色参数与资源数字（钢琴 tau=0.63s / 吉他 tau=0.07s，LUT 6270）
2026-11-04 feat(ks): 激励谱整形 —— 钢琴谐波按 1/h^1.5 倾斜（候选，未上板）
    问题：噪声激励谱平坦，KS 环路一阶低通对 257 Hz 基频几乎不衰减，
    5 次谐波每圈只多衰 0.3%，150 圈才 -3.6 dB。FFT 实测音头
    H1..H6 = 0/-0.6/-6.5/-0.7/+0.5/-2.7 dB —— H2..H5 与 H1 同强，
    听感金属/电子嗡，不像琴弦。真实钢琴约 -9/-14/-18 dB。
    改法：激励先过一阶低通 alpha=1/16（fc 约 530 Hz），再写进延迟线。
    低通时间常数 16 采样（0.3 ms），远小于激励灌入的 202 采样，不影响包络。
    因低通对噪声 RMS 增益约 0.18，激励前级改为全幅注入保持音量。
    实测（FFT，音头 60 ms）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
2026-11-04 feat(ir): IR#2 改为弱音踏板（-12 dB）
    原来 IR#2 只是"预留表情通道"，同步后打包进遥测帧尾，没有任何声音作用。
    现在接成钢琴的 una corda 弱音：
    - synth_ttp229_top: IR#2 经两拍同步 + 16 ms 消抖得到 soft_pedal
    （27 MHz × 16 ms = 432000 个计数）。不消抖的话，红外在临界距离
    会来回抖，听感是"音量忽大忽小"。
    - synth_top: 新增 soft_pedal 输入，在混音末级做 `audio_raw >>> 2`
    （-12 dB）。放在最后一级，数字波形 / 钢琴 / 吉他三种通路都吃得到。
    - 其余三个顶层（synth_board_top / synth_board12_top / chord_demo_top）
    接 1'b0，行为不变。
    - synth_ttp229_quiet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
2026-11-04 feat(ui): 主视图换成峰值保持包络，撤下李萨如
    李萨如对衰减信号会卷成螺旋，拟合后仍不够好看，先撤下，
    主视图改为峰值保持包络（drawPeakWave，之前已实现并验证）：
    - 每帧 512 采样压成一个 正/负峰值 桶，512 桶环形历史 ≈ 5 秒
    - 包络填充 + 上沿高亮 + 最新峰值光点
    - 橙色虚线是峰值保持，只被更大的峰值推高（8 秒半衰）
    drawLiss() 保留在文件里，后期做新可视化时可以直接换回或参考。
2026-11-04 revert(ui): 主视图恢复为普通李萨如（关闭代表轨迹暂留）
    橙色代表轨迹会让画面多一层看不懂的线，用户决定先关掉。
    LISS_SHOW_HOLD = false，冻结与绘制逻辑整套保留，后期要做再改 true。
    标题/副标题恢复原文案。
2026-11-04 fix(ks): 吉他接上延音踏板（sustain 之前根本没进 KS）
    问题：sustain 只喂给了 note_valid 的门控和 adsr/钢琴通路，
    ks_array / karplus_strong 完全没有这个输入。踩延音踏板时吉他的
    voice_busy 虽然保持 1，衰减却仍走拨弦档 lp-(lp>>5)（τ≈0.25 s，
    0.67 s 就没声），而钢琴踩踏板是 2.5 s —— 短一个数量级，踏板对吉他等于没用。
    改法：
    - karplus_strong 新增 sustain 输入，衰减分三档：
    busy && slow_decay → lp-(lp>>8) 钢琴 ≈1.4 s
    busy && sustain → lp-(lp>>7) 吉他+踏板 ≈0.7 s ← 新增
    busy && !sustain → lp-(lp>>5) 吉他松键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
2026-11-04 docs: 审查并更新仓库材料到 v2.1
    00-先看我.md 停留在 beta.5（版本/引脚/音色/资源全部对不上），整篇重写：
    - 版本 v2.1；音色 6 档；钢琴改为加法合成 + 非谐倍率；吉他 KS
    - 双红外分工：#1 引脚 85 延音踏板、#2 引脚 73 弱音（-12 dB）
    - 引脚表更新（旧红外 74 → 85/73）、UART 921600、576 B 帧
    - 资源从 6035/2162 更正为 9281/3695；延迟 0.5 ms → 5.006 ms
    - 测试从 14 套改成 15 套（新增 adsr_pedal）
    - 踩坑清单补三条：KS 同步读、有符号移位、多声部幅度预算、KS 接 sustain
    - 明确标注 host_viz/ 与 iterations/ 是历史存档
    host_viz/README.md：顶部加废弃声明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
2026-11-04 chore: 版本号统一 v2.0.1，整理仓库材料
    - 版本号 v2.1 -> v2.0.1（README、00-先看我）
    - README 版本演进表补全 v2.0.1 的实际内容
    - code/ 根目录的验证产物（spectrum*.png、synth_demo*.wav）移到 docs/assets/
    - docs/README.md 顶部加历史存档说明（01-13 停在 beta 阶段，不代表当前实现）
2026-11-04 fix(piano): 复音按声部数做增益补偿，4 声部不再削波
    问题：piano_engine 的输出是固定 ×0.875，没有任何按声部数的补偿。
    单声部峰值已经 ≈55% 满幅，4 声部同时按下就是 220%，
    仿真实测 39999 个采样里 16643 个被削到 ±32768（41.6%）——
    复音一按就糊。
    改法：按活跃声部数 nvoice 查一张 Q8 增益表（vg/256）：
    1 声部 → 224/256 = 0.875 （与原来完全一致，单音不变）
    2 声部 → 158/256 = 0.617
    3 声部 → 124/256 = 0.484
    4 声部 → 80/256 = 0.313
    比 1/sqrt(N) 稍保守：4 个完全相同相位叠加的极端情况也不削波。
    仿真验证（4 声部同时触发 C4，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
2026-11-04 feat(ui): 李萨如刷新率单独降到 10 Hz
    波形/频谱/统计仍然跟屏幕刷新率（120 fps），只有李萨如按 100 ms 一格走。
    配套改动：drawLiss 的余辉衰减改用**实际调用间隔**（lissPrevT），
    不然 10 Hz 下每帧衰减量还按 16.7 ms 算，800 ms 拖尾会被拉长 6 倍。
    实测：3.26 秒内调用 31 次 = 9.5 Hz（rAF 抖动导致略低于标称 10）。
    四份 index.html 已同步。
2026-11-04 feat(ui): 李萨如离屏画布提到 8x 超采样
    主画布是 dpr×2，离屏再 ×4 = 相对 CSS 像素的 8×：
    画布 7272×7656（55.7 M 像素，约 220 MB），线条边缘基本看不出台阶。
    配套：
    - setTransform(SS,0,0,SS,0,0) —— 绘制代码仍用逻辑坐标，不改一行
    - drawImage 时缩回主画布尺寸 + imageSmoothingQuality=high
    - 面积超过 64 M 像素自动降一档（4×→2×），避免 Chrome 静默给空白画布
    代价：渲染帧率 120 → 96 fps（数据帧率 103 不受影响）。
    嫌卡可以把 MAX_SS_PIX 从 64e6 改回 32e6（自动落到 4× 总采样）。
2026-11-04 perf(ui): 李萨如 30 Hz + 6x 总超采样（保满帧）
    实测三档（窗口 1818x1914 CSS 像素）：
    SS=2 总 4x 13.9 M 像素 -> 120 fps
    SS=3 总 6x 31.3 M 像素 -> 120 fps ← 取这个
    SS=4 总 8x 55.7 M 像素 -> 65 fps ← 8x 和 30 Hz 不可兼得
    用户既要 30 Hz 又要高采样，实测两者冲突：8x 下 30 Hz 只有 65 fps。
    6x 是平衡点——线条台阶基本看不出，帧率仍满。
    要 8x 把 SS 改回 4 即可，代价是 ~65 fps。
